VicidominiLab/BrightEyes-TTM/docs/source/IOConnectorBoard.md

# I/Os adapters & Pinout

```{toctree}
pinout5x5
pinout7x7
```

## Pinout synchronization

```{eval-rst}
.. list-table::
   :header-rows: 1

   * - SMA on Xilinx KC705 board (.xdc)
     - Input
   * - J11
     - Frame
   * - J12
     - Laser SYNC
   * - J14
     - Line
   * - J13
     - Pixel     
```
