VicidominiLab/BrightEyes-TTM/docs/source/NIM2TTL.md

# MPD NIM 2 TTL

MPD NIM 2 TTL

- *Brand:* Micro Photon Devices
- *Product code:* NIM2TTL
- *Link to the product:* <http://www.micro-photon-devices.com/Products/Instrumentation/NIM2TTL-Converter>

This is a commercial device which we use for converting the laser clock signal from NIM levels to TTL levels.
