VicidominiLab/BrightEyes-TTM/docs/source/img/FCS_curve.png

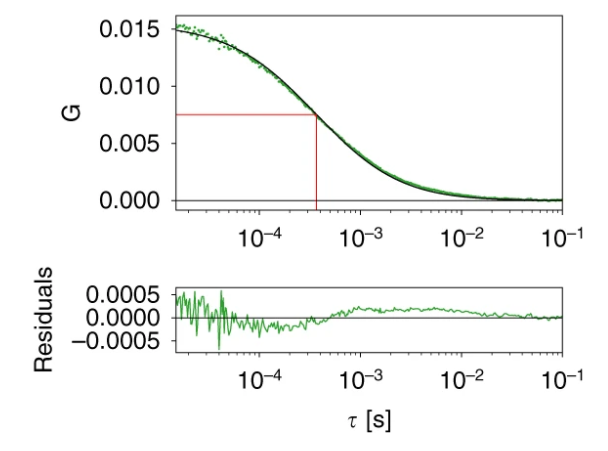
docs/source/img/FCS_curve.png
