VicidominiLab/BrightEyes-TTM/docs/source/img/FLIM_imaging.PNG

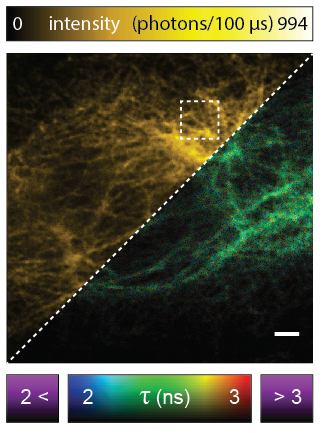
docs/source/img/FLIM_imaging.PNG
