VicidominiLab/BrightEyes-TTM/docs/source/img/Nutt_slidingscale.PNG

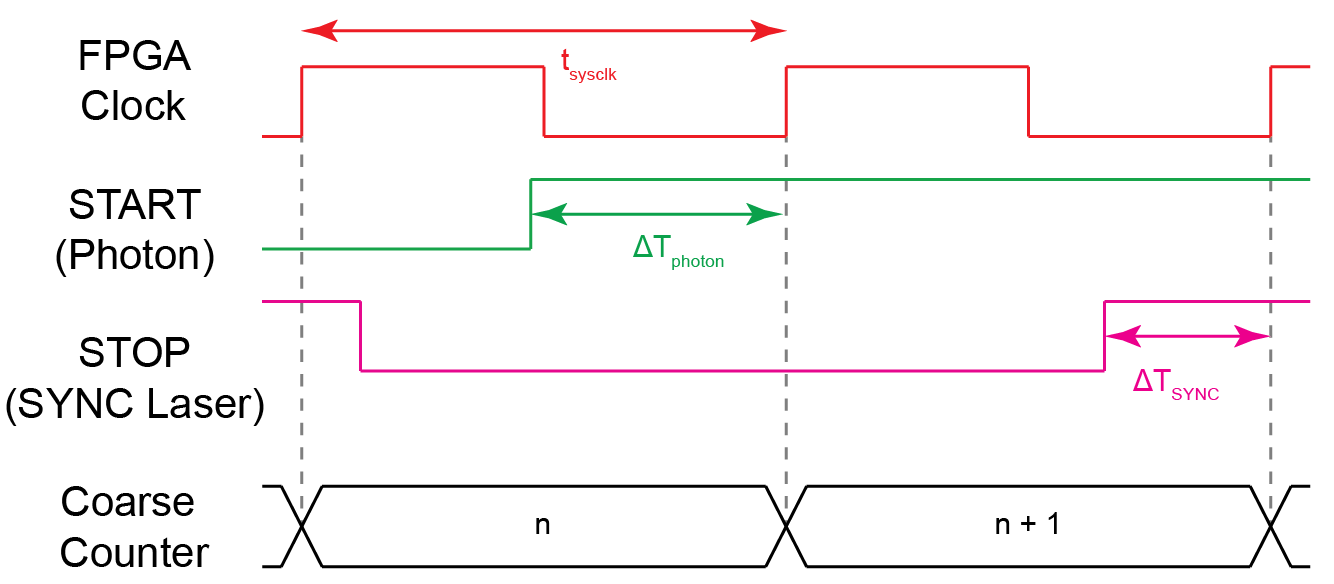
docs/source/img/Nutt_slidingscale.PNG
