VicidominiLab/BrightEyes-TTM/docs/source/img/TCSPC_histograms.png

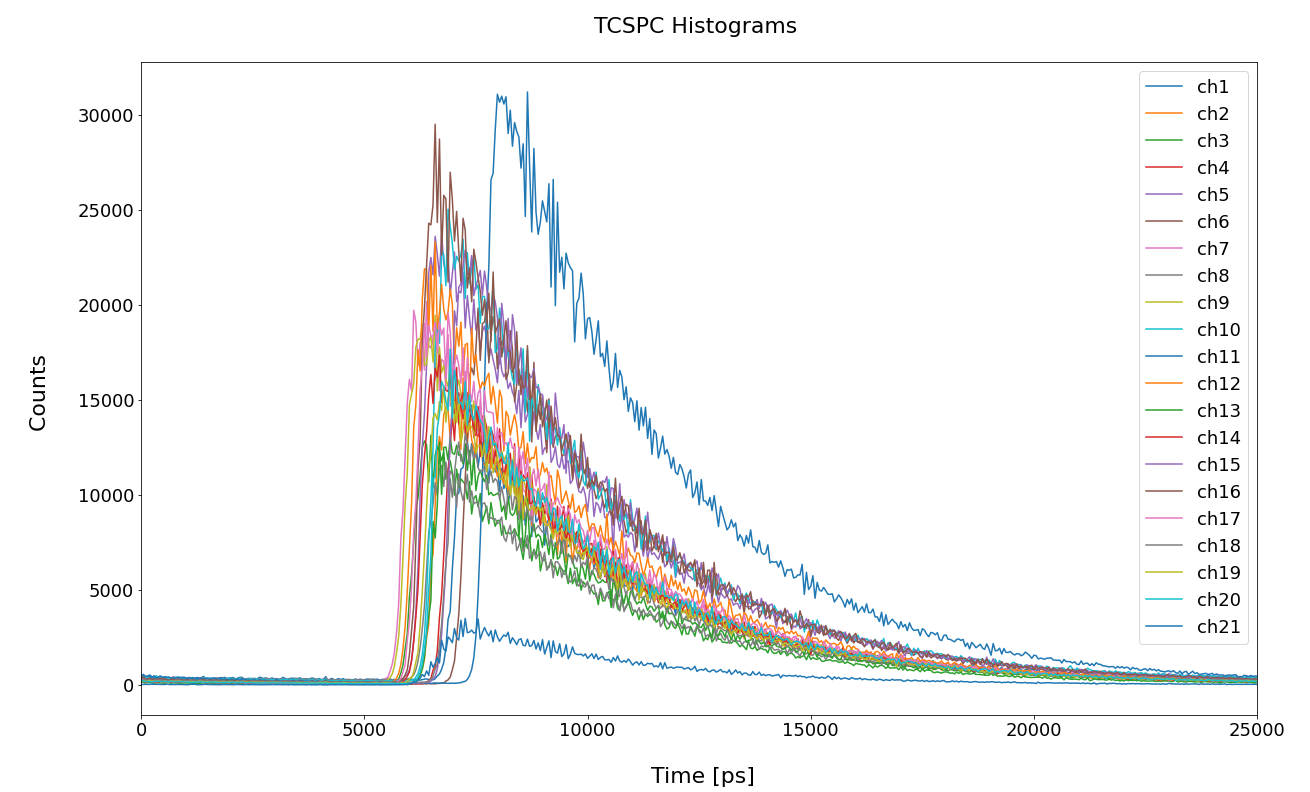
docs/source/img/TCSPC_histograms.png
