VicidominiLab/BrightEyes-TTM/docs/source/img/TTM_ch11_duplication.PNG

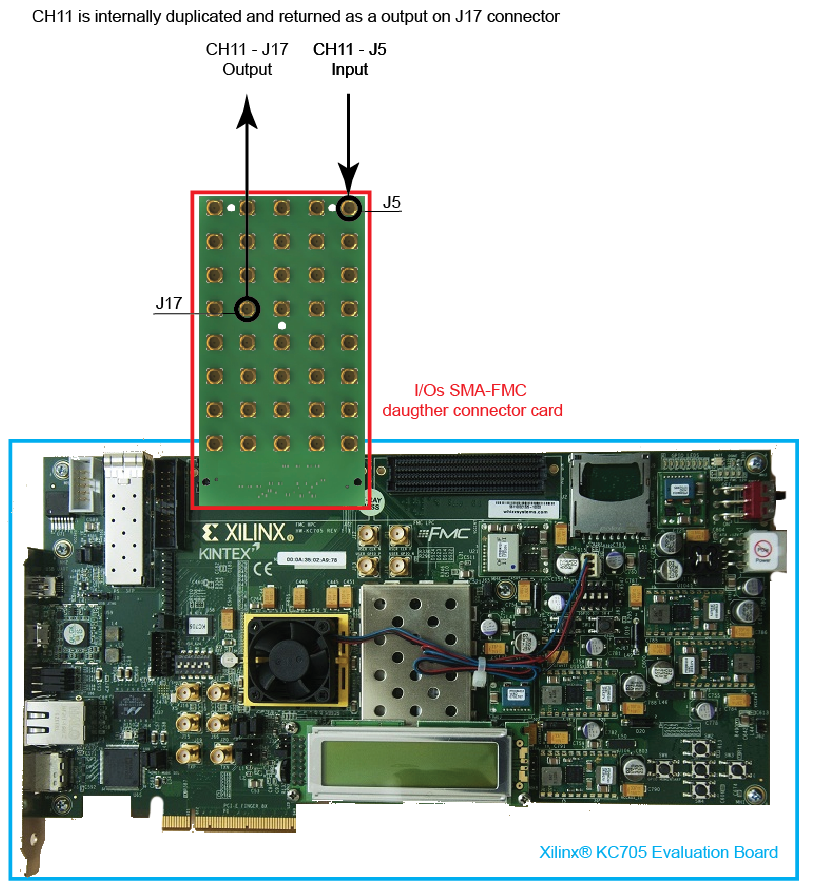
docs/source/img/TTM_ch11_duplication.PNG
