VicidominiLab/BrightEyes-TTM/boards/8xDigiBuffer/doc/BOM_DIGIBUFF8_rev2.xlsx

Revision: 0
Electronic Design Lab
Via E.Melen, 83
16152 - Genova
Bill Of Materials November 27,2020 10:58:11 | Page1
Item | Quantity | Reference | Value | IITCODE Description | Rev_2 | NonMontare
______________________________________________
1 | 1 | C1 | 10uF | 14727 Electrolithic Capacitor, 10uF, 16V, SMD, Diam.4mm
2 | 1 | C2 | 10uF | 11240 Multilayer Ceramic Capacitor, 10uF, 100V, 20%, X7S, SMD, 2220
3 | 1 | C3 | 100uF | 718 Tantalum Capacitor, 100uF, 16V, 10%, SMD, 7343, h. 4.1mm
4 | 1 | C4 | 2.2uF | 7059 Multilayer Ceramic Capacitor, 2.2uF, 16V, 10%, X5R, SMD, 0603
5 | 8 | C5,C7,C9,C11,C13,C15,C17,C19 | 0.1uF | 254 Multilayer Ceramic Capacitor, 0.1uF, 50V, 10%, X7R, SMD, 0603
6 | 8 | C6,C8,C10,C12,C14,C16,C18,C20 | 1uF | 12818 Multilayer Ceramic Capacitor, 1uF, 50V, 10%, X7R, SMD, 0603
7 | 1 | DL1 | OVS-0603 | 1655 Led diode, blue, 4V, 25mA, 100mcd, SMD, 0603
8 | 1 | DL2 | HSMH-C190 | 257 Led diode, red, 2.6V, 25mA, 10mcd, SMD, 0603
9 | 1 | FL1 | 220R@100MHz | 10708 Ferrite bead,1A, 220R@100MHz, SMD, 0603
10 | 1 | J1 | 47346-0001 | 5063 PCB connector, microUSB type B, 5 contact, socket, 90Â°, w to b, with flanges, SMD
11 | 16 | J2,J3,J4,J5,J6,J7,J8,J9,J10,J11,J12, J13,J14,J15,J16,J17 | 59S201-400L5 | 4509 PCB connector, SMB, male, 90Â°, w to b, lock, no key, THD
12 | 1 | R1 | 6K8 | 1424 Resistor Thick film, 6K8, 0.063W, 1%, SMD, 0603
13 | 1 | R2 | 4K12 | 15147 Resistor Thin film, 4K12, 0.063W, 0.1%, SMD, 0402
14 | 1 | R3 | 470R | 1578 Resistor Thick film, 470R, 0.063W, 1%, SMD, 0603
15 | 1 | R4 | 100R | 444 Resistor Thick film 100R, 0.1W, 1%, SMD, 0603
16 | 16 | R5,R6,R7,R8,R9,R10,R11,R12,R13, R14,R15,R16,R17,R18,R19,R20 | 100R | 444 Resistor Thick film 100R, 0.1W, 1%, SMD, 0603 |  | NM
17 | 1 | SW1 | OS102011MA1QN1 | 12064 Slide switch SPDT (ON/OFF), horizontal, 12V, 8.6x4.4mm, THD
18 | 1 | TP1 | TEST POINT 3mm | 5232 Test point, PCB, round, 3mm, for automatic test equipment |  | NM
19 | 1 | U1 | LT1764AMPQ | 14881 Voltage regulator, linear, fast transient response, low noise, Vin 2.7/20V, Vout ADJ 1.2/20V, 3A, SMD, DDPAK9X9-5
20 | 8 | U2,U3,U4,U5,U6,U7,U8,U9 | CDCLVC1102PWR | 15141 LVCMOS Clock Buffer, 1:2, 250MHz, 2.5/3.3V SMD, TSSOP8
