VicidominiLab/BrightEyes-TTM/docs/source/img/TTM_Assembly.PNG

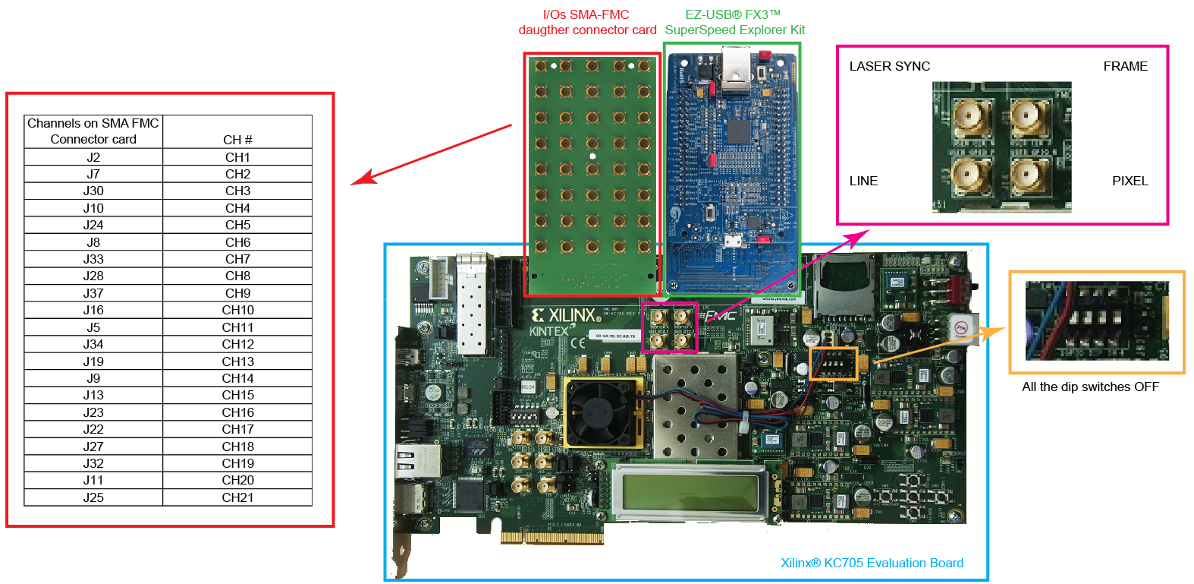
docs/source/img/TTM_Assembly.PNG
