VicidominiLab/BrightEyes-TTM/boards/IOconnectorBoard/SMA_FMC-schematic.pdf

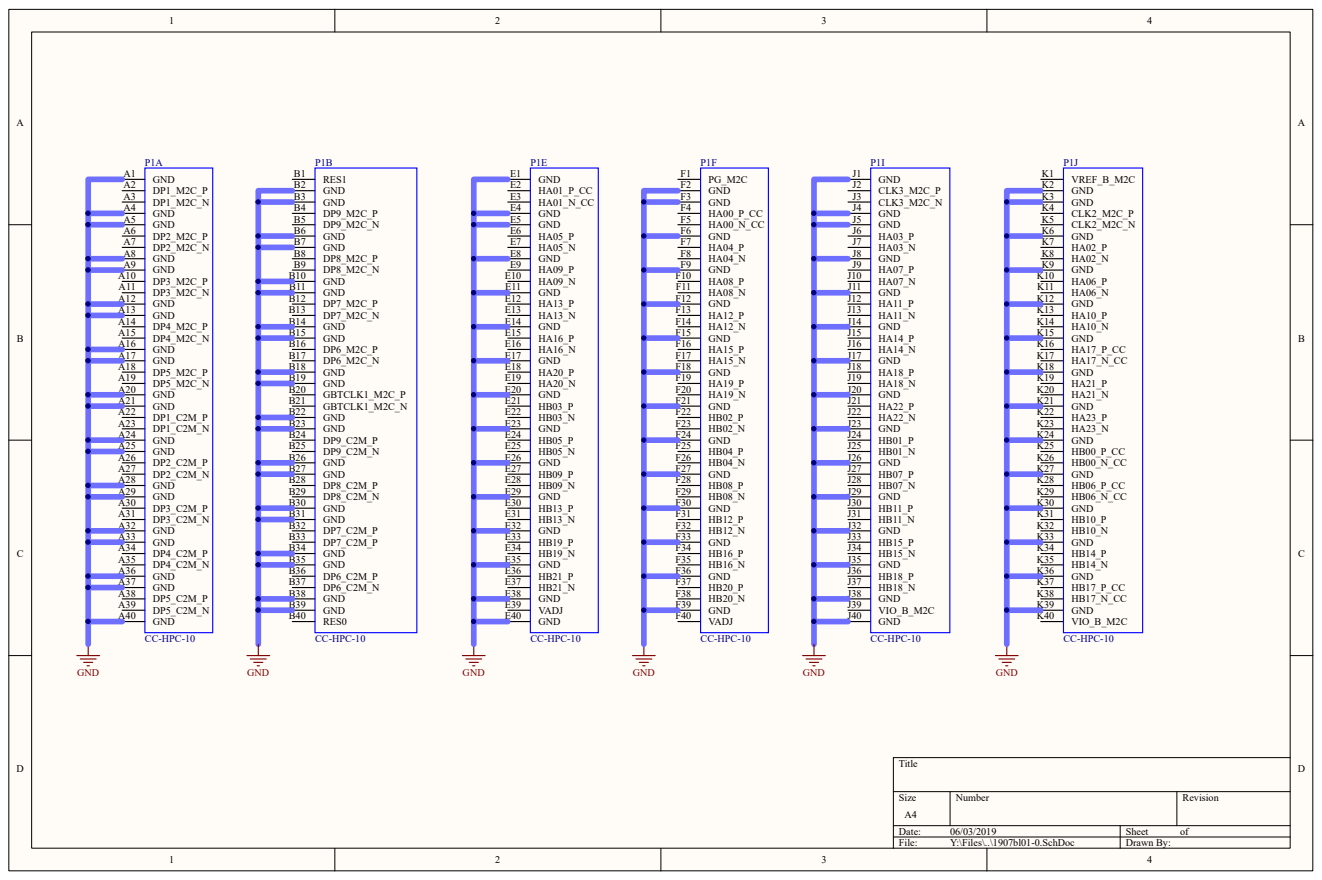
[picture p31: page 1]

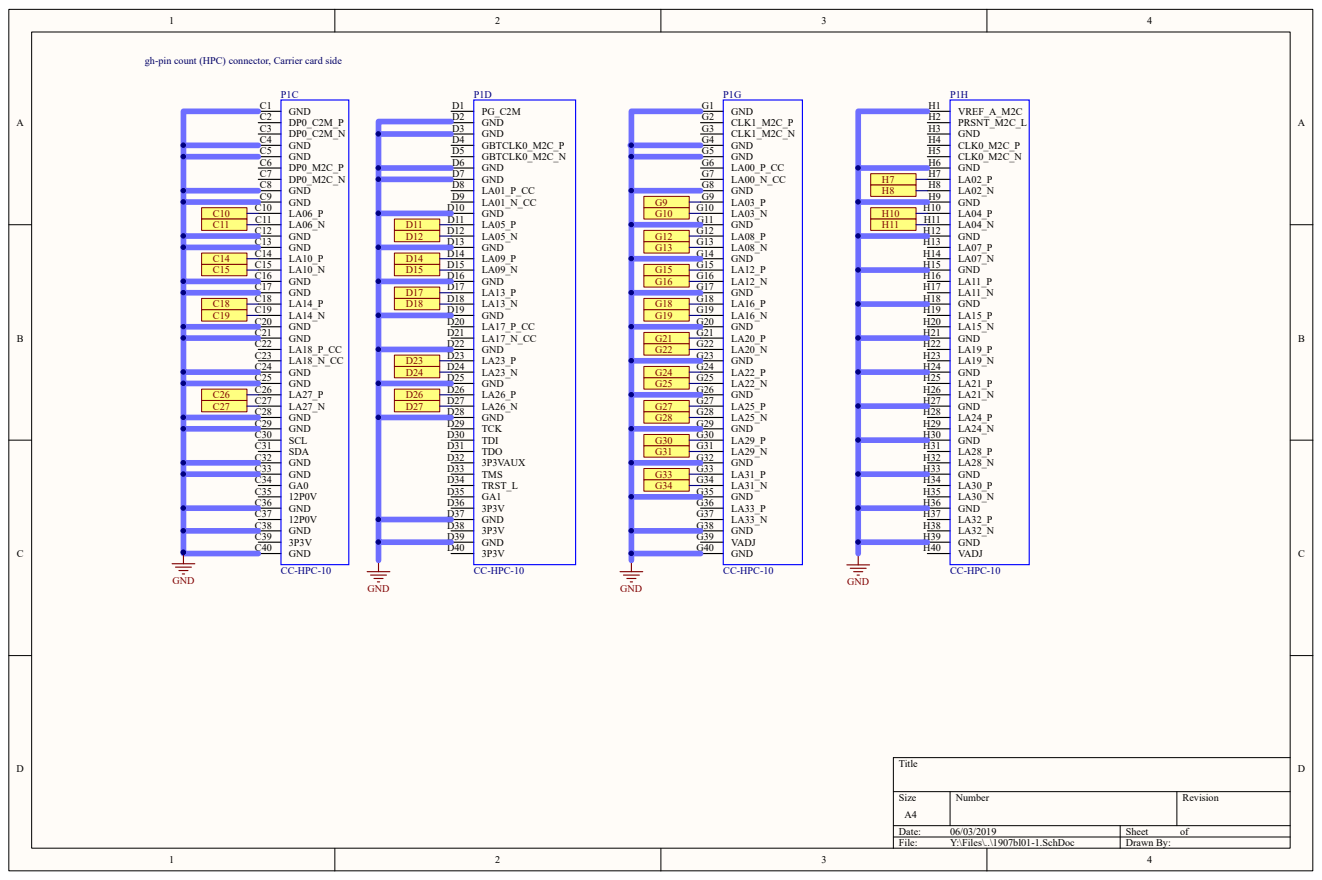
[picture p32: page 2]

gh-pin count (HPC) connector, Carrier card side

# GND 5

# GND 5

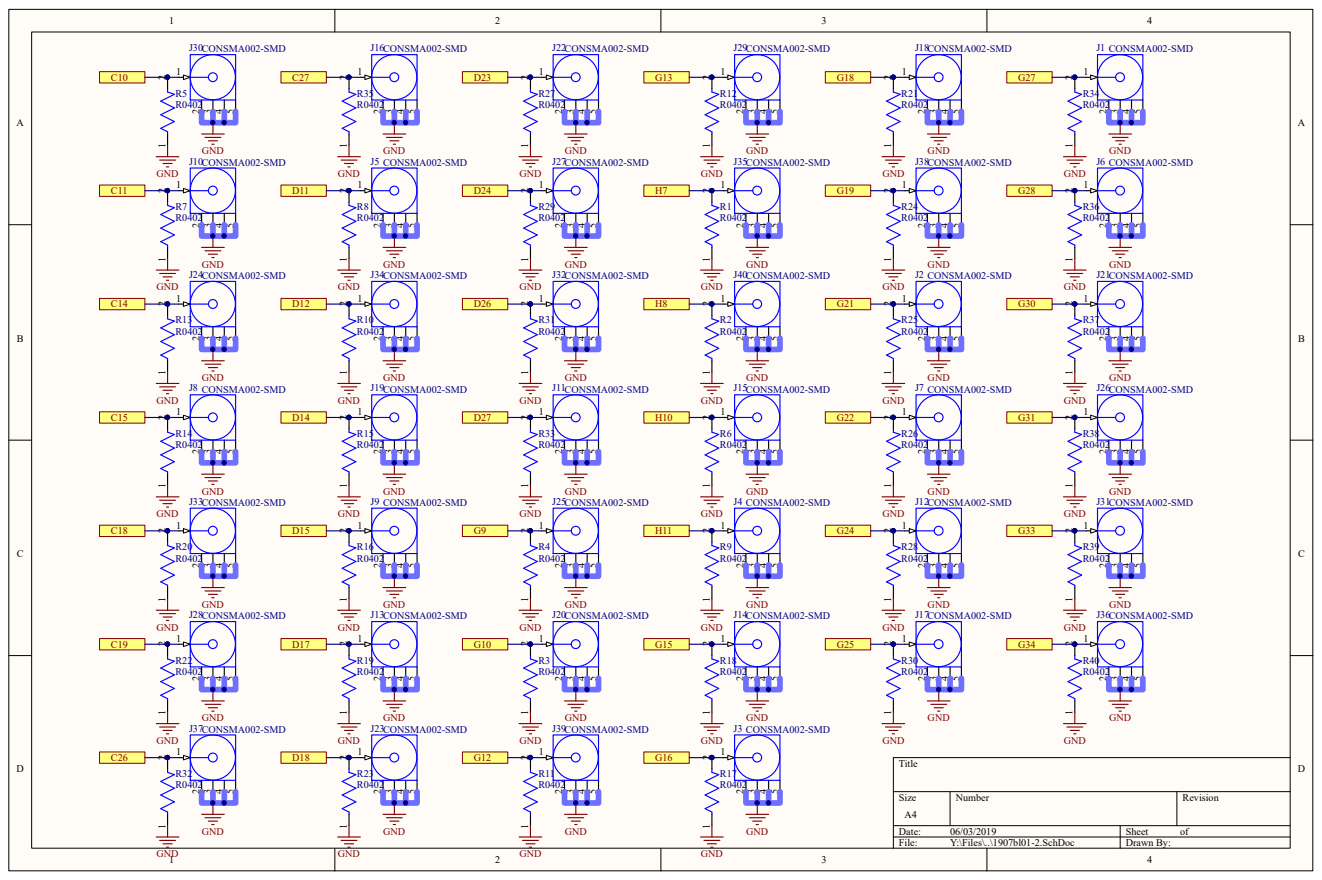
[picture p33: page 3]
