VicidominiLab/BrightEyes-TTM/boards/8xDigiBuffer/doc/DigiBuff8_rev2_pcb.pdf

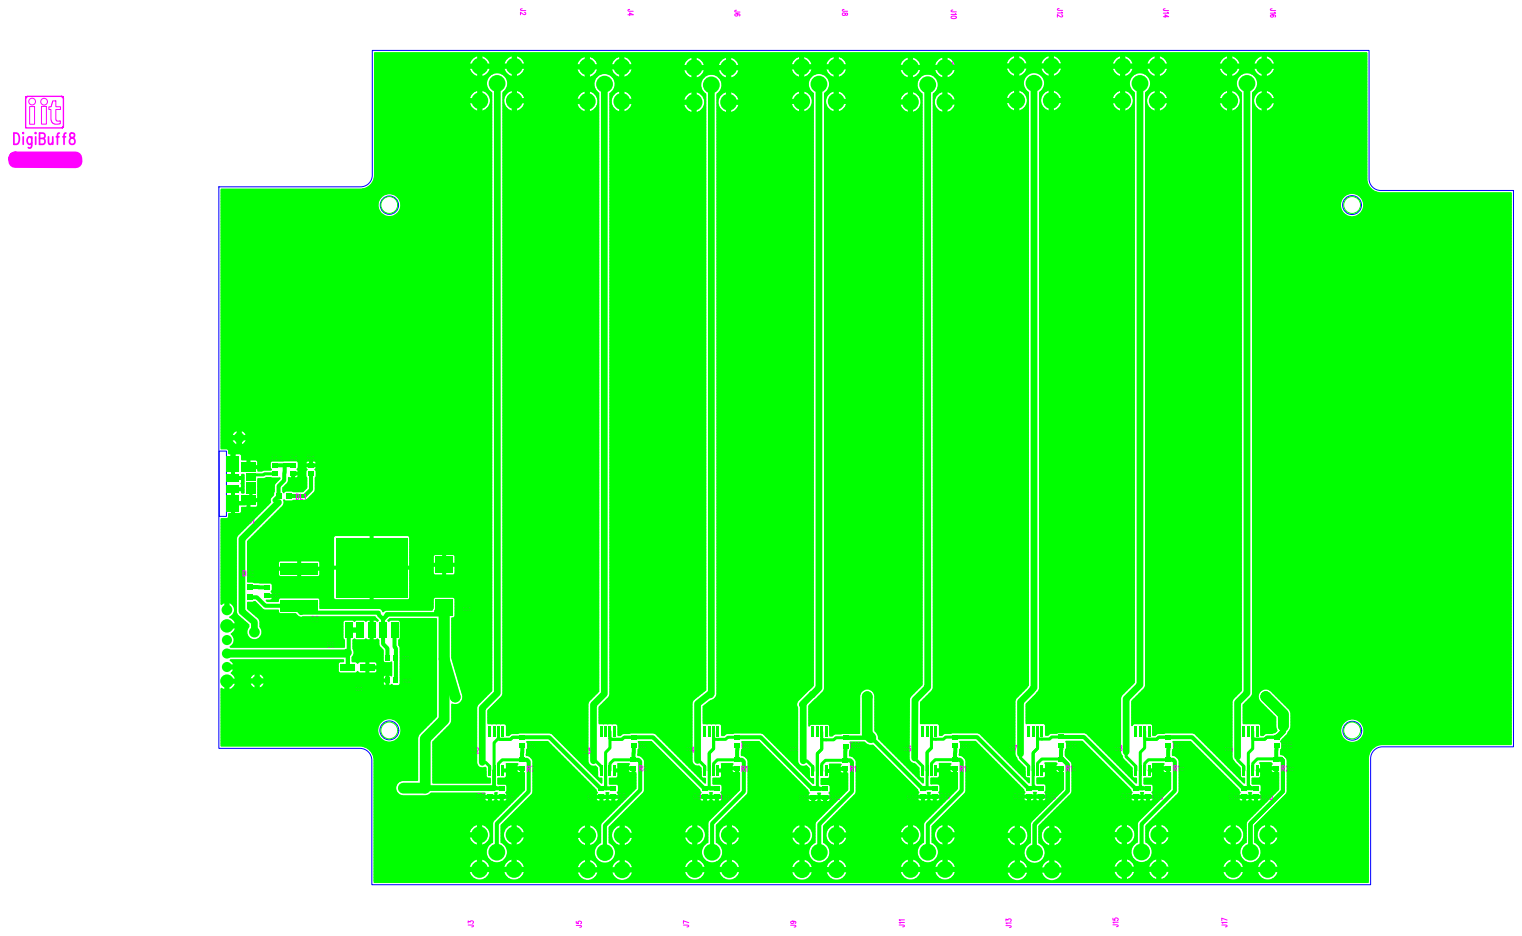
[picture p34: page 1]

J10J10x1J10x2 J10x3 | J10x4 J10x5
J11J11x1 J11x2 J11x4 | J11x3 J11x5
J12J12x1J12x2 J12x3 | J12x4 J12x5
J13J13x1 J13x2 J13x4 | J13x3 J13x5
J14J14x1J14x2 J14x3 | J14x4 J14x5
J15J15x1 J15x2 J15x4 | J15x3 J15x5
J16J16x1J16x2 J16x3 | J16x4 J16x5
J17J17x1 J17x2 J17x4 | J17x3 J17x5
J2J2x1J2x2 J2x3 | J2x4 J2x5
J3J3x1 J3x2 J3x4 | J3x3 J3x5
J4J4x1J4x2 J4x3 | J4x4 J4x5
J5J5x1 J5x2 J5x4 | J5x3 J5x5
J6J6x1J6x2 J6x3 | J6x4 J6x5
J7J7x1 J7x2 J7x4 | J7x3 J7x5
J8J8x1J8x2 J8x3 | J8x4 J8x5
J9J9x1 J9x2 J9x4 | J9x3 J9x5

SW1SW¹x1 SW¹x2 SW¹x3 SW¹x4 SW¹x5

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

SW1SW¹x1 SW¹x2 SW¹x3 SW¹x4 SW¹x5

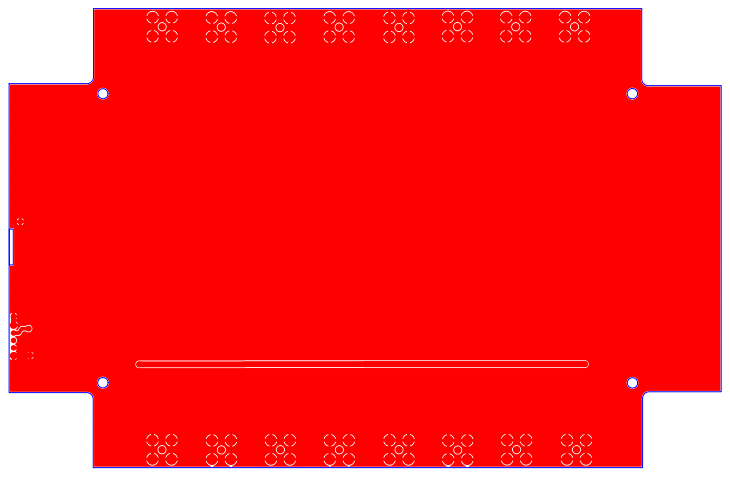
[picture p35: page 4]
SW1SW¹x1 SW¹x2 SW¹x3 SW¹x4 SW¹x5

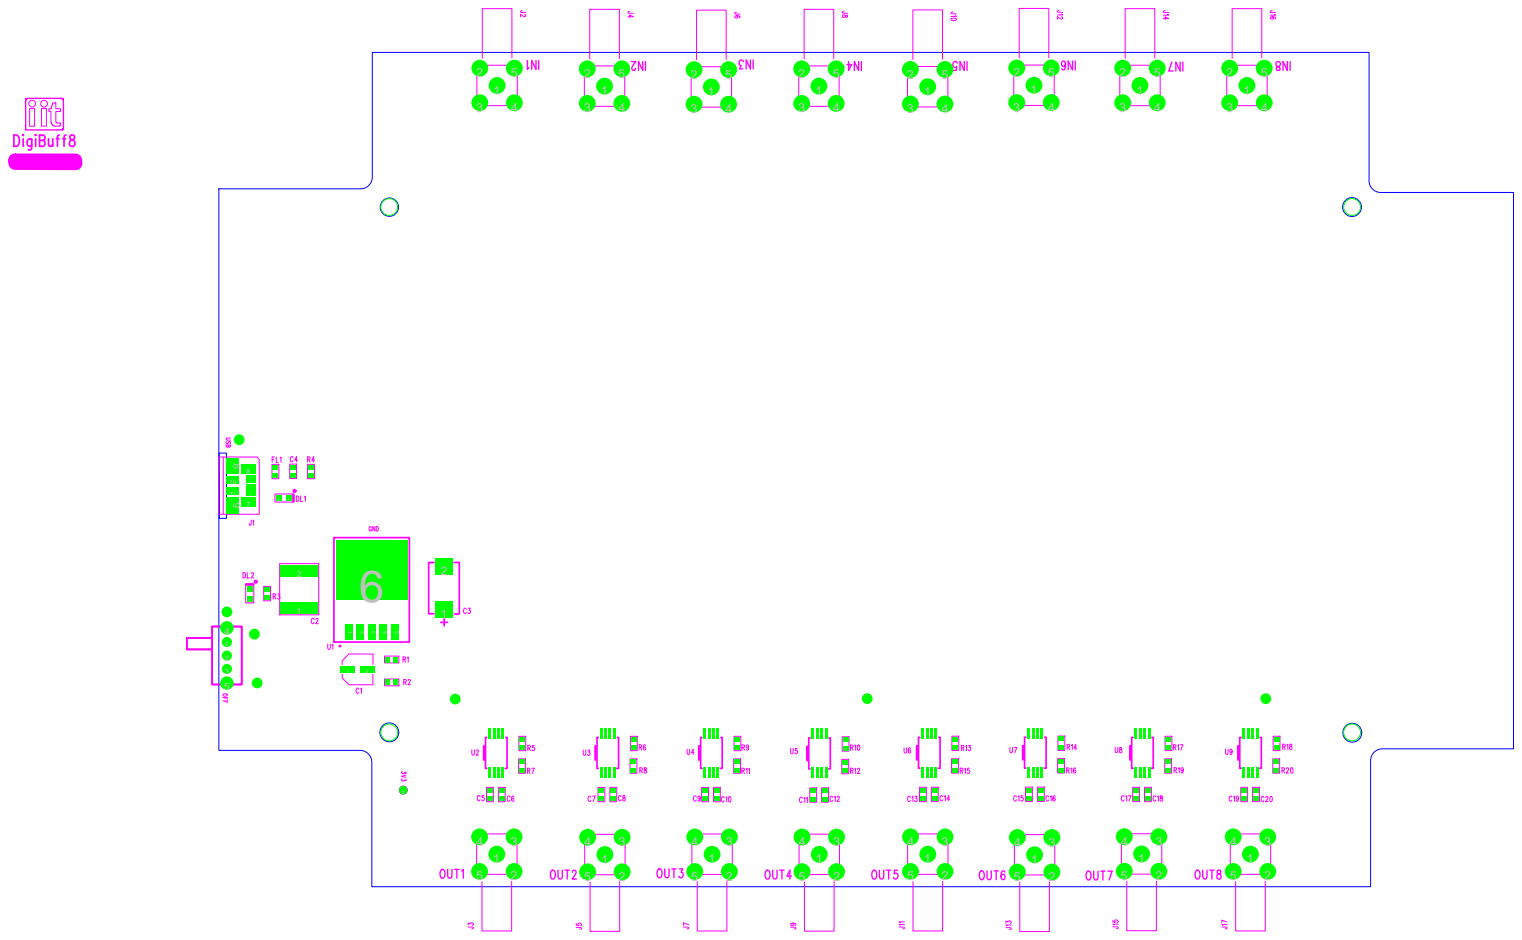
[picture p36: page 5]

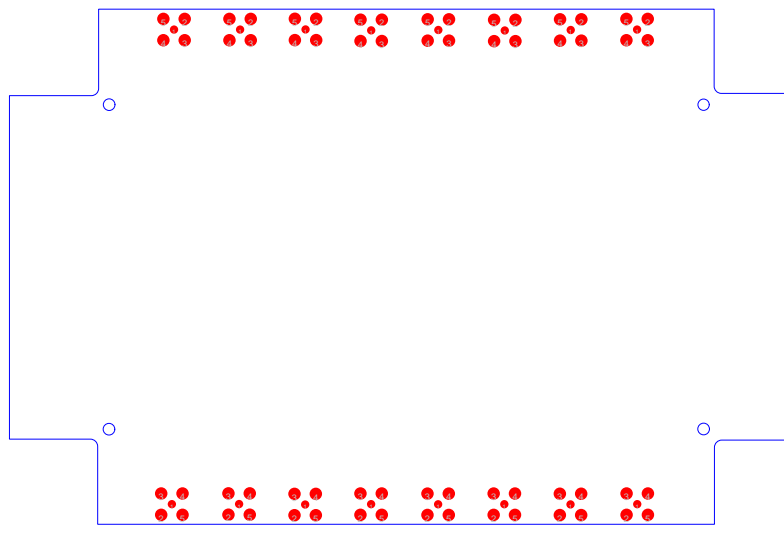
[picture p37: page 6]

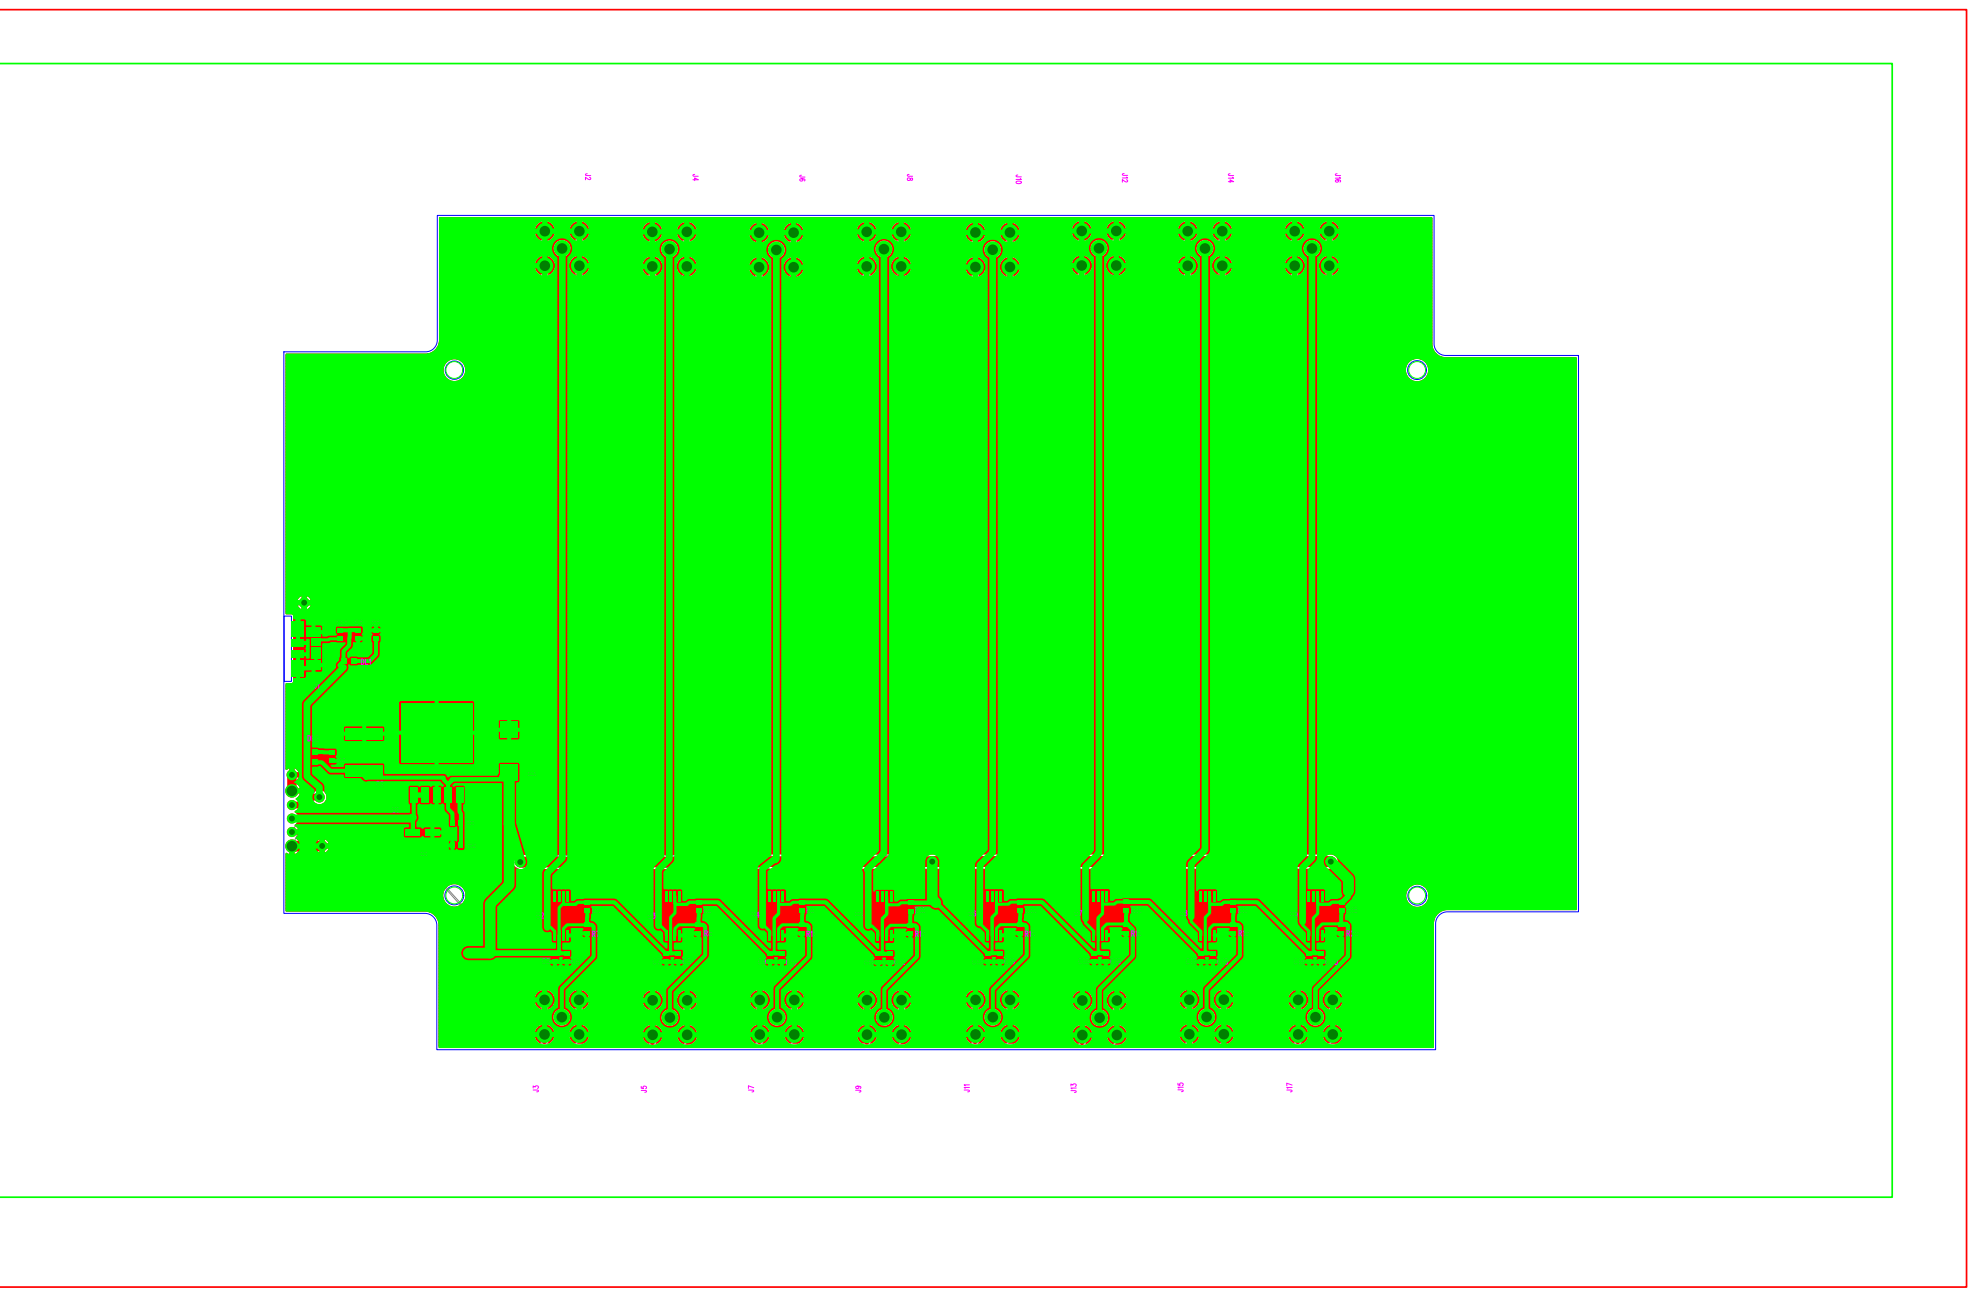
[picture p38: page 7]
