VicidominiLab/BrightEyes-TTM/boards/8xDigiBuffer/doc/DigiBuff8_rev2_sch.pdf

# uUSB

3,3V

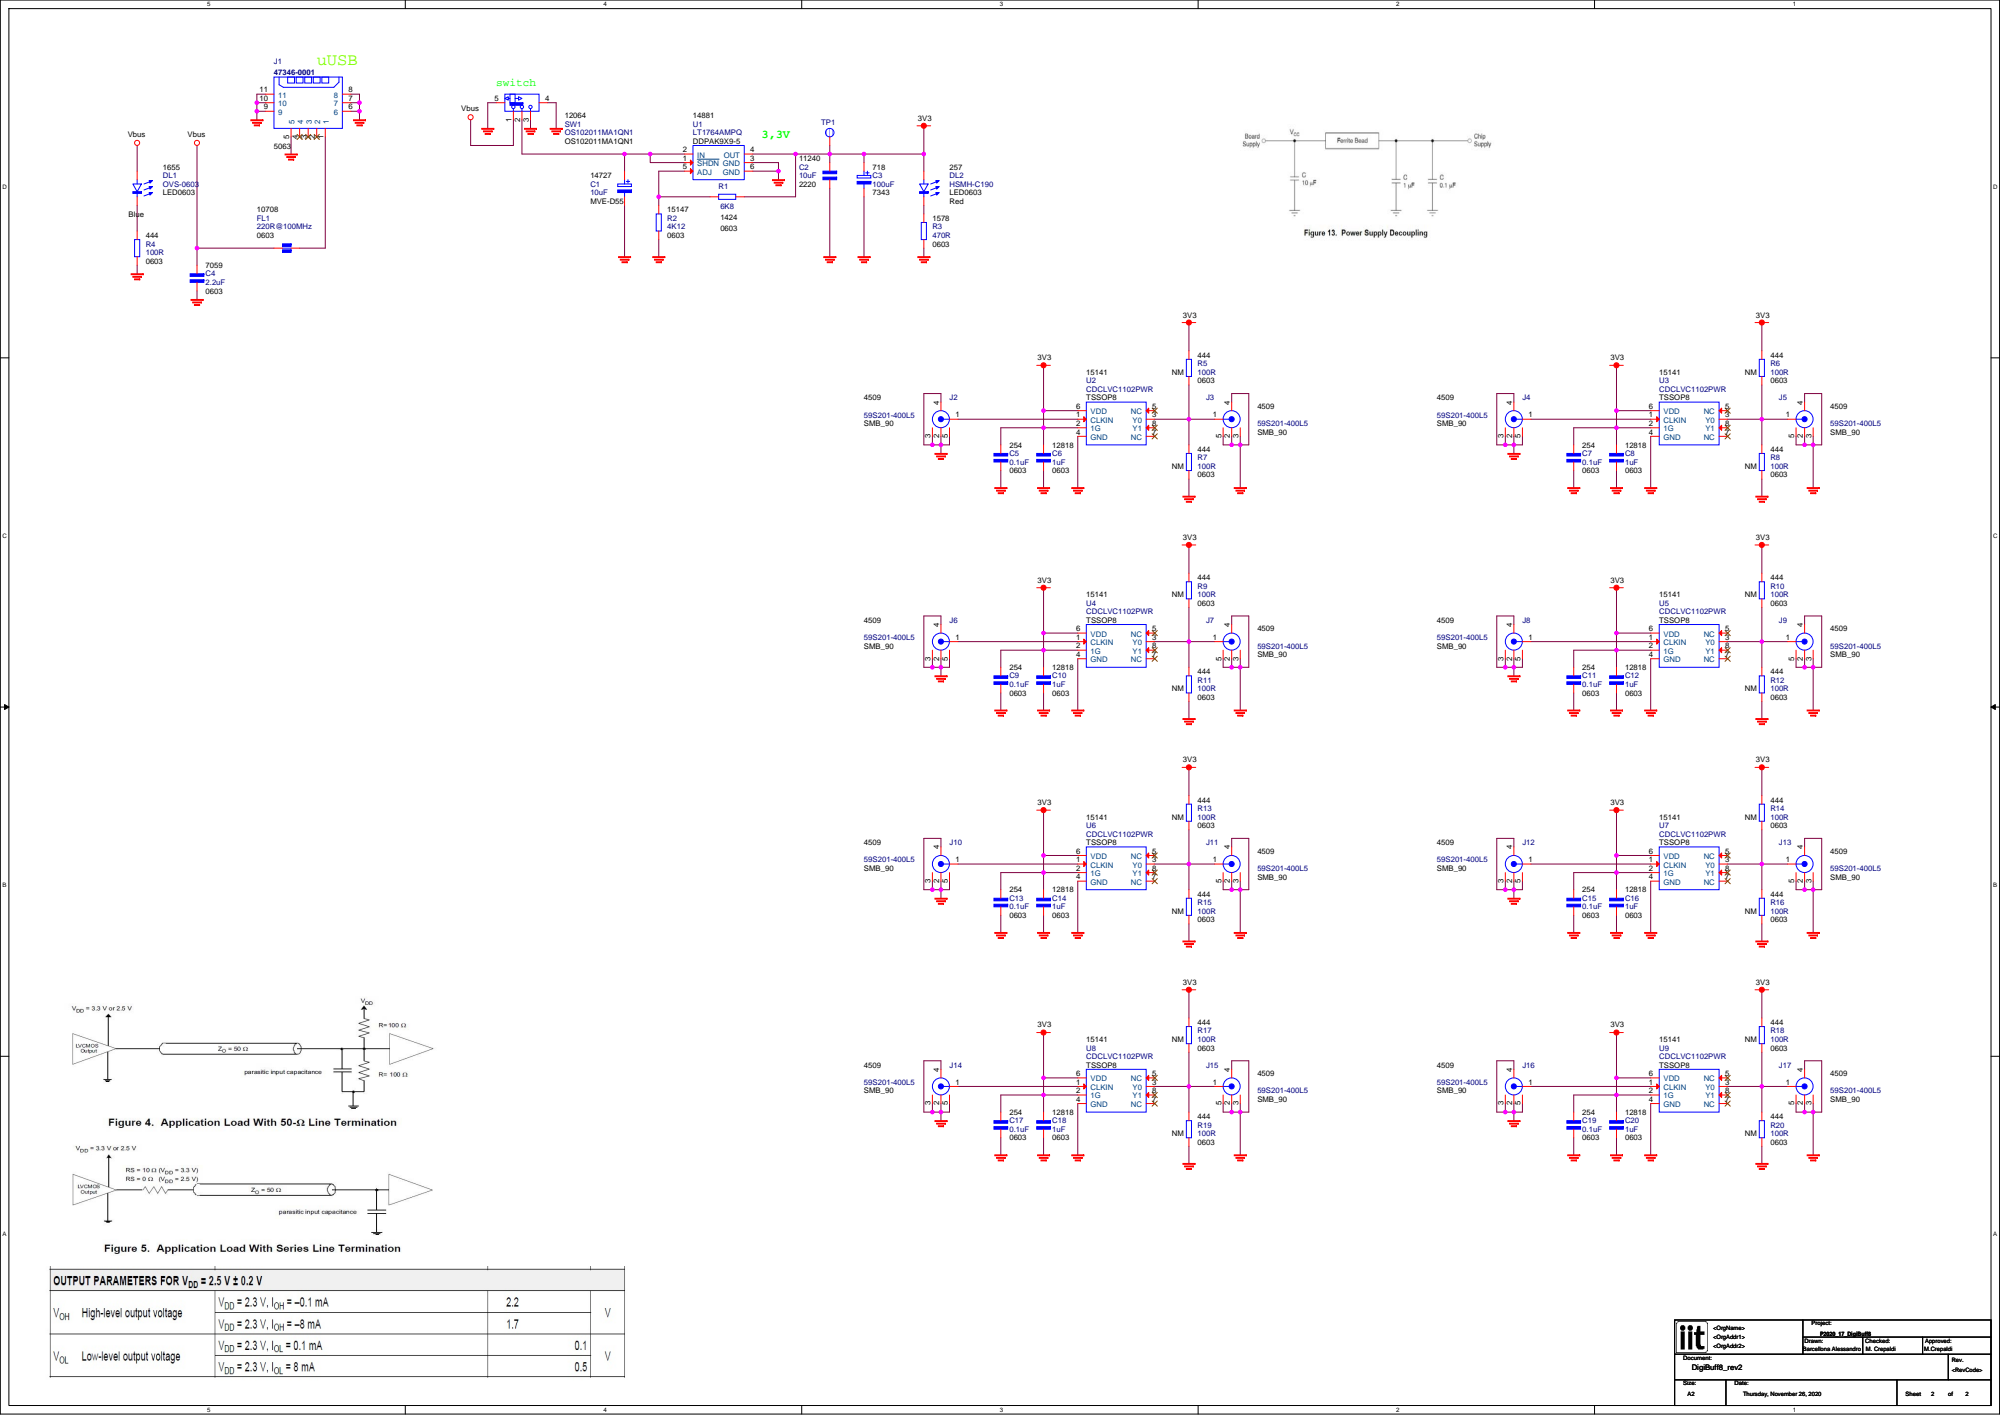
[picture p39: page 1]

<OrgAddr2> <OrgAddr2> <OrgAddr2> | Project: Project: Project: P2020_17_DigiBuff8 <OrgName> <OrgAddr1> P2020_17_DigiBuff8 <OrgName> <OrgAddr1> P2020_17_DigiBuff8 <OrgName> <OrgAddr1>

Drawn: Drawn: Drawn: Barcellona Alessandro Barcellona Alessandro Barcellona Alessandro | Checked: Checked: Checked: M. Crepaldi M. Crepaldi M. Crepaldi | Approved: Approved: Approved: M.Crepaldi M.Crepaldi M.Crepaldi

Document: Document: Document: DigiBuff8_rev2 DigiBuff8_rev2 DigiBuff8_rev2 | Rev. Rev. Rev. <RevCode> <RevCode> <RevCode>

Size: Size: Size: A2 A2 A2 | Date: Date: Date: Thursday, November 26, 2020 Thursday, November 26, 2020 Thursday, November 26, 2020 | Sheet Sheet Sheet 2 2 2 of of of 2 2 2
