VicidominiLab/BrightEyes-TTM/FPGA/ttm/hdl/ip/clockMainGen/clockMainGen_clk_wiz.v

// file: clockMainGen.v
// 
// (c) Copyright 2008 - 2013 Xilinx, Inc. All rights reserved.
// 
// This file contains confidential and proprietary information
// of Xilinx, Inc. and is protected under U.S. and
// international copyright and other intellectual property
// laws.
// 
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
// CRITICAL APPLICATIONS
// Xilinx products are not designed or intended to be fail-
// safe, or for use in any application requiring fail-safe
// performance, such as life-support or safety devices or
// systems, Class III medical devices, nuclear facilities,
// applications related to the deployment of airbags, or any
// other applications that could lead to death, personal
// injury, or severe property or environmental damage
// (individually and collectively, "Critical
// Applications"). Customer assumes the sole risk and
// liability of any use of Xilinx products in Critical
// Applications, subject only to applicable laws and
// regulations governing limitations on product liability.
// 
// THIS COPYRIGHT NOTICE AND DISCLAIMER MUST BE RETAINED AS
// PART OF THIS FILE AT ALL TIMES.
// 
//----------------------------------------------------------------------------
// User entered comments
//----------------------------------------------------------------------------
// None
//
//----------------------------------------------------------------------------
//  Output     Output      Phase    Duty Cycle   Pk-to-Pk     Phase
//   Clock     Freq (MHz)  (degrees)    (%)     Jitter (ps)  Error (ps)
//----------------------------------------------------------------------------
// _clk_240___240.000______0.000______50.0_______89.608_____82.655
// _clk_400___400.000______0.000______50.0_______81.254_____82.655
// __clk_50____50.000______0.000______50.0______121.478_____82.655
// _clk_100___100.000______0.000______50.0______106.024_____82.655
//
//----------------------------------------------------------------------------
// Input Clock   Freq (MHz)    Input Jitter (UI)
//----------------------------------------------------------------------------
// __primary_________200.000____________0.010

`timescale 1ps/1ps

module clockMainGen_clk_wiz 

 (// Clock in ports
  // Clock out ports
  output        clk_240,
  output        clk_400,
  output        clk_50,
  output        clk_100,
  // Status and control signals
  input         reset,
  output        locked,
  input         clk_in1_p,
  input         clk_in1_n
 );
  // Input buffering
  //------------------------------------
wire clk_in1_clockMainGen;
wire clk_in2_clockMainGen;
  IBUFDS clkin1_ibufgds
   (.O  (clk_in1_clockMainGen),
    .I  (clk_in1_p),
    .IB (clk_in1_n));




  // Clocking PRIMITIVE
  //------------------------------------

  // Instantiation of the MMCM PRIMITIVE
  //    * Unused inputs are tied off
  //    * Unused outputs are labeled unused

  wire        clk_240_clockMainGen;
  wire        clk_400_clockMainGen;
  wire        clk_50_clockMainGen;
  wire        clk_100_clockMainGen;
  wire        clk_out5_clockMainGen;
  wire        clk_out6_clockMainGen;
  wire        clk_out7_clockMainGen;

  wire [15:0] do_unused;
  wire        drdy_unused;
  wire        psdone_unused;
  wire        locked_int;
  wire        clkfbout_clockMainGen;
  wire        clkfbout_buf_clockMainGen;
  wire        clkfboutb_unused;
    wire clkout0b_unused;
   wire clkout1b_unused;
   wire clkout2b_unused;
   wire clkout3b_unused;
   wire clkout4_unused;
  wire        clkout5_unused;
  wire        clkout6_unused;
  wire        clkfbstopped_unused;
  wire        clkinstopped_unused;
  wire        reset_high;
  (* KEEP = "TRUE" *) 
  (* ASYNC_REG = "TRUE" *)
  reg  [7 :0] seq_reg1 = 0;
  (* KEEP = "TRUE" *) 
  (* ASYNC_REG = "TRUE" *)
  reg  [7 :0] seq_reg2 = 0;
  (* KEEP = "TRUE" *) 
  (* ASYNC_REG = "TRUE" *)
  reg  [7 :0] seq_reg3 = 0;
  (* KEEP = "TRUE" *) 
  (* ASYNC_REG = "TRUE" *)
  reg  [7 :0] seq_reg4 = 0;

  MMCME2_ADV
  #(.BANDWIDTH            ("HIGH"),
    .CLKOUT4_CASCADE      ("FALSE"),
    .COMPENSATION         ("ZHOLD"),
    .STARTUP_WAIT         ("FALSE"),
    .DIVCLK_DIVIDE        (1),
    .CLKFBOUT_MULT_F      (6.000),
    .CLKFBOUT_PHASE       (0.000),
    .CLKFBOUT_USE_FINE_PS ("FALSE"),
    .CLKOUT0_DIVIDE_F     (5.000),
    .CLKOUT0_PHASE        (0.000),
    .CLKOUT0_DUTY_CYCLE   (0.500),
    .CLKOUT0_USE_FINE_PS  ("FALSE"),
    .CLKOUT1_DIVIDE       (3),
    .CLKOUT1_PHASE        (0.000),
    .CLKOUT1_DUTY_CYCLE   (0.500),
    .CLKOUT1_USE_FINE_PS  ("FALSE"),
    .CLKOUT2_DIVIDE       (24),
    .CLKOUT2_PHASE        (0.000),
    .CLKOUT2_DUTY_CYCLE   (0.500),
    .CLKOUT2_USE_FINE_PS  ("FALSE"),
    .CLKOUT3_DIVIDE       (12),
    .CLKOUT3_PHASE        (0.000),
    .CLKOUT3_DUTY_CYCLE   (0.500),
    .CLKOUT3_USE_FINE_PS  ("FALSE"),
    .CLKIN1_PERIOD        (5.000))
  mmcm_adv_inst
    // Output clocks
   (
    .CLKFBOUT            (clkfbout_clockMainGen),
    .CLKFBOUTB           (clkfboutb_unused),
    .CLKOUT0             (clk_240_clockMainGen),
    .CLKOUT0B            (clkout0b_unused),
    .CLKOUT1             (clk_400_clockMainGen),
    .CLKOUT1B            (clkout1b_unused),
    .CLKOUT2             (clk_50_clockMainGen),
    .CLKOUT2B            (clkout2b_unused),
    .CLKOUT3             (clk_100_clockMainGen),
    .CLKOUT3B            (clkout3b_unused),
    .CLKOUT4             (clkout4_unused),
    .CLKOUT5             (clkout5_unused),
    .CLKOUT6             (clkout6_unused),
     // Input clock control
    .CLKFBIN             (clkfbout_buf_clockMainGen),
    .CLKIN1              (clk_in1_clockMainGen),
    .CLKIN2              (1'b0),
     // Tied to always select the primary input clock
    .CLKINSEL            (1'b1),
    // Ports for dynamic reconfiguration
    .DADDR               (7'h0),
    .DCLK                (1'b0),
    .DEN                 (1'b0),
    .DI                  (16'h0),
    .DO                  (do_unused),
    .DRDY                (drdy_unused),
    .DWE                 (1'b0),
    // Ports for dynamic phase shift
    .PSCLK               (1'b0),
    .PSEN                (1'b0),
    .PSINCDEC            (1'b0),
    .PSDONE              (psdone_unused),
    // Other control and status signals
    .LOCKED              (locked_int),
    .CLKINSTOPPED        (clkinstopped_unused),
    .CLKFBSTOPPED        (clkfbstopped_unused),
    .PWRDWN              (1'b0),
    .RST                 (reset_high));
  assign reset_high = reset; 

  assign locked = locked_int;
// Clock Monitor clock assigning
//--------------------------------------
 // Output buffering
  //-----------------------------------

  BUFG clkf_buf
   (.O (clkfbout_buf_clockMainGen),
    .I (clkfbout_clockMainGen));







  BUFGCE clkout1_buf
   (.O   (clk_240),
    .CE  (seq_reg1[7]),
    .I   (clk_240_clockMainGen));

  BUFH clkout1_buf_en
   (.O   (clk_240_clockMainGen_en_clk),
    .I   (clk_240_clockMainGen));
  always @(posedge clk_240_clockMainGen_en_clk or posedge reset_high) begin
    if(reset_high == 1'b1) begin
	    seq_reg1 <= 8'h00;
    end
    else begin
        seq_reg1 <= {seq_reg1[6:0],locked_int};
  
    end
  end


  BUFGCE clkout2_buf
   (.O   (clk_400),
    .CE  (seq_reg2[7]),
    .I   (clk_400_clockMainGen));
 
  BUFH clkout2_buf_en
   (.O   (clk_400_clockMainGen_en_clk),
    .I   (clk_400_clockMainGen));
 
  always @(posedge clk_400_clockMainGen_en_clk or posedge reset_high) begin
    if(reset_high == 1'b1) begin
	  seq_reg2 <= 8'h00;
    end
    else begin
        seq_reg2 <= {seq_reg2[6:0],locked_int};
  
    end
  end


  BUFGCE clkout3_buf
   (.O   (clk_50),
    .CE  (seq_reg3[7]),
    .I   (clk_50_clockMainGen));
 
  BUFH clkout3_buf_en
   (.O   (clk_50_clockMainGen_en_clk),
    .I   (clk_50_clockMainGen));
 
  always @(posedge clk_50_clockMainGen_en_clk or posedge reset_high) begin
    if(reset_high == 1'b1) begin
	  seq_reg3 <= 8'h00;
    end
    else begin
        seq_reg3 <= {seq_reg3[6:0],locked_int};
  
    end
  end


  BUFGCE clkout4_buf
   (.O   (clk_100),
    .CE  (seq_reg4[7]),
    .I   (clk_100_clockMainGen));

  BUFH clkout4_buf_en
   (.O   (clk_100_clockMainGen_en_clk),
    .I   (clk_100_clockMainGen));
	
  always @(posedge clk_100_clockMainGen_en_clk or posedge reset_high) begin
    if(reset_high == 1'b1) begin
	  seq_reg4 <= 8'h00;
    end
    else begin
        seq_reg4 <= {seq_reg4[6:0],locked_int};
  
    end
  end





endmodule
