VicidominiLab/BrightEyes-TTM/FPGA/ttm/project/ttm.srcs/sources_1/ip/ila_1/synth/ila_1.vhd

-- (c) Copyright 1995-2012 Xilinx, Inc. All rights reserved.
--
-- This file contains confidential and proprietary information
-- of Xilinx, Inc. and is protected under U.S. and
-- international copyright and other intellectual property
-- laws.
--
-- DISCLAIMER
-- This disclaimer is not a license and does not grant any
-- rights to the materials distributed herewith. Except as
-- otherwise provided in a valid license issued to you by
-- Xilinx, and to the maximum extent permitted by applicable
-- law: (1) THESE MATERIALS ARE MADE AVAILABLE "AS IS" AND
-- WITH ALL FAULTS, AND XILINX HEREBY DISCLAIMS ALL WARRANTIES
-- AND CONDITIONS, EXPRESS, IMPLIED, OR STATUTORY, INCLUDING
-- BUT NOT LIMITED TO WARRANTIES OF MERCHANTABILITY, NON-
-- INFRINGEMENT, OR FITNESS FOR ANY PARTICULAR PURPOSE; and
-- (2) Xilinx shall not be liable (whether in contract or tort,
-- including negligence, or under any other theory of
-- liability) for any loss or damage of any kind or nature
-- related to, arising under or in connection with these
-- materials, including for any direct, or any indirect,
-- special, incidental, or consequential loss or damage
-- (including loss of data, profits, goodwill, or any type of
-- loss or damage suffered as a result of any action brought
-- by a third party) even if such damage or loss was
-- reasonably foreseeable or Xilinx had been advised of the
-- possibility of the same.
--
-- CRITICAL APPLICATIONS
-- Xilinx products are not designed or intended to be fail-
-- safe, or for use in any application requiring fail-safe
-- performance, such as life-support or safety devices or
-- systems, Class III medical devices, nuclear facilities,
-- applications related to the deployment of airbags, or any
-- other applications that could lead to death, personal
-- injury, or severe property or environmental damage
-- (individually and collectively, "Critical
-- Applications"). Customer assumes the sole risk and
-- liability of any use of Xilinx products in Critical
-- Applications, subject only to applicable laws and
-- regulations governing limitations on product liability.
--
-- THIS COPYRIGHT NOTICE AND DISCLAIMER MUST BE RETAINED AS
-- PART OF THIS FILE AT ALL TIMES.
--
-- DO NOT MODIFY THIS FILE.

LIBRARY ieee;
USE ieee.std_logic_1164.ALL;
USE ieee.numeric_std.ALL;

ENTITY ila_1 IS
PORT (
clk : IN STD_LOGIC;


probe0 : IN STD_LOGIC_VECTOR(8 DOWNTO 0);
    probe1 : IN STD_LOGIC_VECTOR(0 DOWNTO 0);
    probe2 : IN STD_LOGIC_VECTOR(0 DOWNTO 0);
    probe3 : IN STD_LOGIC_VECTOR(0 DOWNTO 0);
    probe4 : IN STD_LOGIC_VECTOR(0 DOWNTO 0)
);
END ila_1;

ARCHITECTURE ila_1_arch OF ila_1 IS
COMPONENT ila_v6_2_5_ila IS
GENERIC (
C_XLNX_HW_PROBE_INFO : STRING;
C_XDEVICEFAMILY : STRING;
C_CORE_TYPE : INTEGER;
C_CORE_INFO1 : INTEGER;
C_CORE_INFO2 : INTEGER;
C_CAPTURE_TYPE : INTEGER;
C_MU_TYPE : INTEGER;
C_TC_TYPE : INTEGER;
C_NUM_OF_PROBES : INTEGER;
C_DATA_DEPTH : INTEGER;
C_MAJOR_VERSION : INTEGER;
C_MINOR_VERSION : INTEGER;
C_BUILD_REVISION : INTEGER;
C_CORE_MAJOR_VER : INTEGER;
C_CORE_MINOR_VER : INTEGER;
C_XSDB_SLAVE_TYPE : INTEGER;
C_NEXT_SLAVE : INTEGER;
C_CSE_DRV_VER : INTEGER;
C_USE_TEST_REG : INTEGER;
C_PIPE_IFACE : INTEGER;
C_RAM_STYLE : STRING;
C_TRIGOUT_EN : INTEGER;
C_TRIGIN_EN : INTEGER;
C_ADV_TRIGGER : INTEGER;
C_EN_DDR_ILA : INTEGER;
C_EN_STRG_QUAL : INTEGER;
C_INPUT_PIPE_STAGES : INTEGER;
C_EN_TIME_TAG  : INTEGER;
C_TIME_TAG_WIDTH : INTEGER;
C_ILA_CLK_FREQ : INTEGER;
C_PROBE0_WIDTH : INTEGER;
C_PROBE1_WIDTH : INTEGER;
C_PROBE2_WIDTH : INTEGER;
C_PROBE3_WIDTH : INTEGER;
C_PROBE4_WIDTH : INTEGER;
C_PROBE5_WIDTH : INTEGER;
C_PROBE6_WIDTH : INTEGER;
C_PROBE7_WIDTH : INTEGER;
C_PROBE8_WIDTH : INTEGER;
C_PROBE9_WIDTH : INTEGER;
C_PROBE10_WIDTH : INTEGER;
C_PROBE11_WIDTH : INTEGER;
C_PROBE12_WIDTH : INTEGER;
C_PROBE13_WIDTH : INTEGER;
C_PROBE14_WIDTH : INTEGER;
C_PROBE15_WIDTH : INTEGER;
C_PROBE16_WIDTH : INTEGER;
C_PROBE17_WIDTH : INTEGER;
C_PROBE18_WIDTH : INTEGER;
C_PROBE19_WIDTH : INTEGER;
C_PROBE20_WIDTH : INTEGER;
C_PROBE21_WIDTH : INTEGER;
C_PROBE22_WIDTH : INTEGER;
C_PROBE23_WIDTH : INTEGER;
C_PROBE24_WIDTH : INTEGER;
C_PROBE25_WIDTH : INTEGER;
C_PROBE26_WIDTH : INTEGER;
C_PROBE27_WIDTH : INTEGER;
C_PROBE28_WIDTH : INTEGER;
C_PROBE29_WIDTH : INTEGER;
C_PROBE30_WIDTH : INTEGER;
C_PROBE31_WIDTH : INTEGER;
C_PROBE32_WIDTH : INTEGER;
C_PROBE33_WIDTH : INTEGER;
C_PROBE34_WIDTH : INTEGER;
C_PROBE35_WIDTH : INTEGER;
C_PROBE36_WIDTH : INTEGER;
C_PROBE37_WIDTH : INTEGER;
C_PROBE38_WIDTH : INTEGER;
C_PROBE39_WIDTH : INTEGER;
C_PROBE40_WIDTH : INTEGER;
C_PROBE41_WIDTH : INTEGER;
C_PROBE42_WIDTH : INTEGER;
C_PROBE43_WIDTH : INTEGER;
C_PROBE44_WIDTH : INTEGER;
C_PROBE45_WIDTH : INTEGER;
C_PROBE46_WIDTH : INTEGER;
C_PROBE47_WIDTH : INTEGER;
C_PROBE48_WIDTH : INTEGER;
C_PROBE49_WIDTH : INTEGER;
C_PROBE50_WIDTH : INTEGER;
C_PROBE51_WIDTH : INTEGER;
C_PROBE52_WIDTH : INTEGER;
C_PROBE53_WIDTH : INTEGER;
C_PROBE54_WIDTH : INTEGER;
C_PROBE55_WIDTH : INTEGER;
C_PROBE56_WIDTH : INTEGER;
C_PROBE57_WIDTH : INTEGER;
C_PROBE58_WIDTH : INTEGER;
C_PROBE59_WIDTH : INTEGER;
C_PROBE60_WIDTH : INTEGER;
C_PROBE61_WIDTH : INTEGER;
C_PROBE62_WIDTH : INTEGER;
C_PROBE63_WIDTH : INTEGER;
C_PROBE64_WIDTH : INTEGER;
C_PROBE65_WIDTH : INTEGER;
C_PROBE66_WIDTH : INTEGER;
C_PROBE67_WIDTH : INTEGER;
C_PROBE68_WIDTH : INTEGER;
C_PROBE69_WIDTH : INTEGER;
C_PROBE70_WIDTH : INTEGER;
C_PROBE71_WIDTH : INTEGER;
C_PROBE72_WIDTH : INTEGER;
C_PROBE73_WIDTH : INTEGER;
C_PROBE74_WIDTH : INTEGER;
C_PROBE75_WIDTH : INTEGER;
C_PROBE76_WIDTH : INTEGER;
C_PROBE77_WIDTH : INTEGER;
C_PROBE78_WIDTH : INTEGER;
C_PROBE79_WIDTH : INTEGER;
C_PROBE80_WIDTH : INTEGER;
C_PROBE81_WIDTH : INTEGER;
C_PROBE82_WIDTH : INTEGER;
C_PROBE83_WIDTH : INTEGER;
C_PROBE84_WIDTH : INTEGER;
C_PROBE85_WIDTH : INTEGER;
C_PROBE86_WIDTH : INTEGER;
C_PROBE87_WIDTH : INTEGER;
C_PROBE88_WIDTH : INTEGER;
C_PROBE89_WIDTH : INTEGER;
C_PROBE90_WIDTH : INTEGER;
C_PROBE91_WIDTH : INTEGER;
C_PROBE92_WIDTH : INTEGER;
C_PROBE93_WIDTH : INTEGER;
C_PROBE94_WIDTH : INTEGER;
C_PROBE95_WIDTH : INTEGER;
C_PROBE96_WIDTH : INTEGER;
C_PROBE97_WIDTH : INTEGER;
C_PROBE98_WIDTH : INTEGER;
C_PROBE99_WIDTH : INTEGER;
C_PROBE100_WIDTH : INTEGER;
C_PROBE101_WIDTH : INTEGER;
C_PROBE102_WIDTH : INTEGER;
C_PROBE103_WIDTH : INTEGER;
C_PROBE104_WIDTH : INTEGER;
C_PROBE105_WIDTH : INTEGER;
C_PROBE106_WIDTH : INTEGER;
C_PROBE107_WIDTH : INTEGER;
C_PROBE108_WIDTH : INTEGER;
C_PROBE109_WIDTH : INTEGER;
C_PROBE110_WIDTH : INTEGER;
C_PROBE111_WIDTH : INTEGER;
C_PROBE112_WIDTH : INTEGER;
C_PROBE113_WIDTH : INTEGER;
C_PROBE114_WIDTH : INTEGER;
C_PROBE115_WIDTH : INTEGER;
C_PROBE116_WIDTH : INTEGER;
C_PROBE117_WIDTH : INTEGER;
C_PROBE118_WIDTH : INTEGER;
C_PROBE119_WIDTH : INTEGER;
C_PROBE120_WIDTH : INTEGER;
C_PROBE121_WIDTH : INTEGER;
C_PROBE122_WIDTH : INTEGER;
C_PROBE123_WIDTH : INTEGER;
C_PROBE124_WIDTH : INTEGER;
C_PROBE125_WIDTH : INTEGER;
C_PROBE126_WIDTH : INTEGER;
C_PROBE127_WIDTH : INTEGER;
C_PROBE128_WIDTH : INTEGER;
C_PROBE129_WIDTH : INTEGER;
C_PROBE130_WIDTH : INTEGER;
C_PROBE131_WIDTH : INTEGER;
C_PROBE132_WIDTH : INTEGER;
C_PROBE133_WIDTH : INTEGER;
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
probe674 : IN STD_LOGIC_VECTOR(0 DOWNTO 0);
probe675 : IN STD_LOGIC_VECTOR(0 DOWNTO 0);
probe676 : IN STD_LOGIC_VECTOR(0 DOWNTO 0);
probe677 : IN STD_LOGIC_VECTOR(0 DOWNTO 0);
probe678 : IN STD_LOGIC_VECTOR(0 DOWNTO 0);
probe679 : IN STD_LOGIC_VECTOR(0 DOWNTO 0);
probe680 : IN STD_LOGIC_VECTOR(0 DOWNTO 0);
probe681 : IN STD_LOGIC_VECTOR(0 DOWNTO 0);
probe682 : IN STD_LOGIC_VECTOR(0 DOWNTO 0);
probe683 : IN STD_LOGIC_VECTOR(0 DOWNTO 0);
probe684 : IN STD_LOGIC_VECTOR(0 DOWNTO 0);
probe685 : IN STD_LOGIC_VECTOR(0 DOWNTO 0);
probe686 : IN STD_LOGIC_VECTOR(0 DOWNTO 0);
probe687 : IN STD_LOGIC_VECTOR(0 DOWNTO 0);
probe688 : IN STD_LOGIC_VECTOR(0 DOWNTO 0);
probe689 : IN STD_LOGIC_VECTOR(0 DOWNTO 0);
probe690 : IN STD_LOGIC_VECTOR(0 DOWNTO 0);
probe691 : IN STD_LOGIC_VECTOR(0 DOWNTO 0);
probe692 : IN STD_LOGIC_VECTOR(0 DOWNTO 0);
probe693 : IN STD_LOGIC_VECTOR(0 DOWNTO 0);
probe694 : IN STD_LOGIC_VECTOR(0 DOWNTO 0);
probe695 : IN STD_LOGIC_VECTOR(0 DOWNTO 0);
probe696 : IN STD_LOGIC_VECTOR(0 DOWNTO 0);
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
