VicidominiLab/BrightEyes-TTM/FPGA/ttm/project/ttm.ip_user_files/ip/ila_1/ila_1_stub.vhdl

-- Copyright 1986-2017 Xilinx, Inc. All Rights Reserved.
-- --------------------------------------------------------------------------------
-- Tool Version: Vivado v.2017.4 (lin64) Build 2086221 Fri Dec 15 20:54:30 MST 2017
-- Date        : Tue Aug 17 08:47:06 2021
-- Host        : IITMMSDL002 running 64-bit Linux Mint 20.2
-- Command     : write_vhdl -force -mode synth_stub -rename_top ila_1 -prefix
--               ila_1_ ila_1_stub.vhdl
-- Design      : ila_1
-- Purpose     : Stub declaration of top-level module interface
-- Device      : xc7k325tffg900-2
-- --------------------------------------------------------------------------------
library IEEE;
use IEEE.STD_LOGIC_1164.ALL;

entity ila_1 is
  Port ( 
    clk : in STD_LOGIC;
    probe0 : in STD_LOGIC_VECTOR ( 8 downto 0 );
    probe1 : in STD_LOGIC_VECTOR ( 0 to 0 );
    probe2 : in STD_LOGIC_VECTOR ( 0 to 0 );
    probe3 : in STD_LOGIC_VECTOR ( 0 to 0 );
    probe4 : in STD_LOGIC_VECTOR ( 0 to 0 )
  );

end ila_1;

architecture stub of ila_1 is
attribute syn_black_box : boolean;
attribute black_box_pad_pin : string;
attribute syn_black_box of stub : architecture is true;
attribute black_box_pad_pin of stub : architecture is "clk,probe0[8:0],probe1[0:0],probe2[0:0],probe3[0:0],probe4[0:0]";
attribute x_core_info : string;
attribute x_core_info of stub : architecture is "ila,Vivado 2017.4";
begin
end;
