VicidominiLab/BrightEyes-TTM/FPGA/ttm/project/ttm.ip_user_files/ip/ila_data/ila_data_stub.v

// Copyright 1986-2017 Xilinx, Inc. All Rights Reserved.
// --------------------------------------------------------------------------------
// Tool Version: Vivado v.2017.4 (lin64) Build 2086221 Fri Dec 15 20:54:30 MST 2017
// Date        : Tue Aug 24 09:47:49 2021
// Host        : IITMMSDL002 running 64-bit Linux Mint 20.2
// Command     : write_verilog -force -mode synth_stub -rename_top ila_data -prefix
//               ila_data_ ila_data_stub.v
// Design      : ila_data
// Purpose     : Stub declaration of top-level module interface
// Device      : xc7k325tffg900-2
// --------------------------------------------------------------------------------

// This empty module with port declaration file causes synthesis tools to infer a black box for IP.
// The synthesis directives are for Synopsys Synplify support to prevent IO buffer insertion.
// Please paste the declaration into a Verilog source file or add the file as an additional source.
(* x_core_info = "ila,Vivado 2017.4" *)
module ila_data(clk, probe0, probe1, probe2, probe3, probe4, probe5, 
  probe6, probe7, probe8, probe9, probe10)
/* synthesis syn_black_box black_box_pad_pin="clk,probe0[95:0],probe1[0:0],probe2[0:0],probe3[31:0],probe4[0:0],probe5[0:0],probe6[7:0],probe7[95:0],probe8[0:0],probe9[0:0],probe10[0:0]" */;
  input clk;
  input [95:0]probe0;
  input [0:0]probe1;
  input [0:0]probe2;
  input [31:0]probe3;
  input [0:0]probe4;
  input [0:0]probe5;
  input [7:0]probe6;
  input [95:0]probe7;
  input [0:0]probe8;
  input [0:0]probe9;
  input [0:0]probe10;
endmodule
