VicidominiLab/BrightEyes-TTM/FPGA/ttm/project/ttm.ip_user_files/ip/ila_fx3/ila_fx3_stub.v

// Copyright 1986-2017 Xilinx, Inc. All Rights Reserved.
// --------------------------------------------------------------------------------
// Tool Version: Vivado v.2017.4 (lin64) Build 2086221 Fri Dec 15 20:54:30 MST 2017
// Date        : Tue Aug 24 08:41:59 2021
// Host        : IITMMSDL002 running 64-bit Linux Mint 20.2
// Command     : write_verilog -force -mode synth_stub -rename_top ila_fx3 -prefix
//               ila_fx3_ ila_fx3_stub.v
// Design      : ila_fx3
// Purpose     : Stub declaration of top-level module interface
// Device      : xc7k325tffg900-2
// --------------------------------------------------------------------------------

// This empty module with port declaration file causes synthesis tools to infer a black box for IP.
// The synthesis directives are for Synopsys Synplify support to prevent IO buffer insertion.
// Please paste the declaration into a Verilog source file or add the file as an additional source.
(* x_core_info = "ila,Vivado 2017.4" *)
module ila_fx3(clk, probe0, probe1, probe2, probe3, probe4, probe5, 
  probe6, probe7, probe8, probe9, probe10, probe11, probe12, probe13, probe14, probe15, probe16, probe17, 
  probe18, probe19, probe20, probe21, probe22, probe23, probe24, probe25)
/* synthesis syn_black_box black_box_pad_pin="clk,probe0[31:0],probe1[1:0],probe2[0:0],probe3[0:0],probe4[0:0],probe5[0:0],probe6[0:0],probe7[0:0],probe8[0:0],probe9[0:0],probe10[0:0],probe11[0:0],probe12[0:0],probe13[3:0],probe14[0:0],probe15[0:0],probe16[0:0],probe17[31:0],probe18[0:0],probe19[0:0],probe20[0:0],probe21[15:0],probe22[0:0],probe23[31:0],probe24[0:0],probe25[0:0]" */;
  input clk;
  input [31:0]probe0;
  input [1:0]probe1;
  input [0:0]probe2;
  input [0:0]probe3;
  input [0:0]probe4;
  input [0:0]probe5;
  input [0:0]probe6;
  input [0:0]probe7;
  input [0:0]probe8;
  input [0:0]probe9;
  input [0:0]probe10;
  input [0:0]probe11;
  input [0:0]probe12;
  input [3:0]probe13;
  input [0:0]probe14;
  input [0:0]probe15;
  input [0:0]probe16;
  input [31:0]probe17;
  input [0:0]probe18;
  input [0:0]probe19;
  input [0:0]probe20;
  input [15:0]probe21;
  input [0:0]probe22;
  input [31:0]probe23;
  input [0:0]probe24;
  input [0:0]probe25;
endmodule
