VicidominiLab/BrightEyes-TTM/FPGA/ttm/hdl/ip/fifo_generator_0_1/fifo_generator_0_stub.v

// Copyright 1986-2017 Xilinx, Inc. All Rights Reserved.
// --------------------------------------------------------------------------------
// Tool Version: Vivado v.2017.4 (lin64) Build 2086221 Fri Dec 15 20:54:30 MST 2017
// Date        : Wed Nov 18 15:34:24 2020
// Host        : IITMMSDL002 running 64-bit Linux Mint 20
// Command     : write_verilog -force -mode synth_stub
//               /home/mdonato-fast/myDev/timetaggingplatform/ttp-tdc.srcs/sources_1/ip/fifo_generator_0_1/fifo_generator_0_stub.v
// Design      : fifo_generator_0
// Purpose     : Stub declaration of top-level module interface
// Device      : xc7k325tffg900-2
// --------------------------------------------------------------------------------

// This empty module with port declaration file causes synthesis tools to infer a black box for IP.
// The synthesis directives are for Synopsys Synplify support to prevent IO buffer insertion.
// Please paste the declaration into a Verilog source file or add the file as an additional source.
(* x_core_info = "fifo_generator_v13_2_1,Vivado 2017.4" *)
module fifo_generator_0(rst, wr_clk, rd_clk, din, wr_en, rd_en, dout, full, 
  almost_full, empty, almost_empty, prog_full, prog_empty, wr_rst_busy, rd_rst_busy)
/* synthesis syn_black_box black_box_pad_pin="rst,wr_clk,rd_clk,din[255:0],wr_en,rd_en,dout[31:0],full,almost_full,empty,almost_empty,prog_full,prog_empty,wr_rst_busy,rd_rst_busy" */;
  input rst;
  input wr_clk;
  input rd_clk;
  input [255:0]din;
  input wr_en;
  input rd_en;
  output [31:0]dout;
  output full;
  output almost_full;
  output empty;
  output almost_empty;
  output prog_full;
  output prog_empty;
  output wr_rst_busy;
  output rd_rst_busy;
endmodule
