VicidominiLab/BrightEyes-TTM/FPGA/ttm/hdl/ip/clockMainGen/clockMainGen_sim_netlist.vhdl

-- Copyright 1986-2017 Xilinx, Inc. All Rights Reserved.
-- --------------------------------------------------------------------------------
-- Tool Version: Vivado v.2017.4 (lin64) Build 2086221 Fri Dec 15 20:54:30 MST 2017
-- Date        : Tue Jul 13 12:27:37 2021
-- Host        : IITMMSDL002 running 64-bit Linux Mint 20.1
-- Command     : write_vhdl -force -mode funcsim -rename_top clockMainGen -prefix
--               clockMainGen_ clockMainGen_sim_netlist.vhdl
-- Design      : clockMainGen
-- Purpose     : This VHDL netlist is a functional simulation representation of the design and should not be modified or
--               synthesized. This netlist cannot be used for SDF annotated simulation.
-- Device      : xc7k325tffg900-2
-- --------------------------------------------------------------------------------
library IEEE;
use IEEE.STD_LOGIC_1164.ALL;
library UNISIM;
use UNISIM.VCOMPONENTS.ALL;
entity clockMainGen_clockMainGen_clk_wiz is
  port (
    clk_240 : out STD_LOGIC;
    clk_400 : out STD_LOGIC;
    clk_50 : out STD_LOGIC;
    clk_100 : out STD_LOGIC;
    reset : in STD_LOGIC;
    locked : out STD_LOGIC;
    clk_in1_p : in STD_LOGIC;
    clk_in1_n : in STD_LOGIC
  );
end clockMainGen_clockMainGen_clk_wiz;

architecture STRUCTURE of clockMainGen_clockMainGen_clk_wiz is
  signal clk_100_clockMainGen : STD_LOGIC;
  signal clk_100_clockMainGen_en_clk : STD_LOGIC;
  signal clk_240_clockMainGen : STD_LOGIC;
  signal clk_240_clockMainGen_en_clk : STD_LOGIC;
  signal clk_400_clockMainGen : STD_LOGIC;
  signal clk_400_clockMainGen_en_clk : STD_LOGIC;
  signal clk_50_clockMainGen : STD_LOGIC;
  signal clk_50_clockMainGen_en_clk : STD_LOGIC;
  signal clk_in1_clockMainGen : STD_LOGIC;
  signal clkfbout_buf_clockMainGen : STD_LOGIC;
  signal clkfbout_clockMainGen : STD_LOGIC;
  signal \^locked\ : STD_LOGIC;
  signal seq_reg1 : STD_LOGIC_VECTOR ( 7 downto 0 );
  attribute RTL_KEEP : string;
  attribute RTL_KEEP of seq_reg1 : signal is "true";
  attribute async_reg : string;
  attribute async_reg of seq_reg1 : signal is "true";
  signal seq_reg2 : STD_LOGIC_VECTOR ( 7 downto 0 );
  attribute RTL_KEEP of seq_reg2 : signal is "true";
  attribute async_reg of seq_reg2 : signal is "true";
  signal seq_reg3 : STD_LOGIC_VECTOR ( 7 downto 0 );
  attribute RTL_KEEP of seq_reg3 : signal is "true";
  attribute async_reg of seq_reg3 : signal is "true";
  signal seq_reg4 : STD_LOGIC_VECTOR ( 7 downto 0 );
  attribute RTL_KEEP of seq_reg4 : signal is "true";
  attribute async_reg of seq_reg4 : signal is "true";
  signal NLW_mmcm_adv_inst_CLKFBOUTB_UNCONNECTED : STD_LOGIC;
  signal NLW_mmcm_adv_inst_CLKFBSTOPPED_UNCONNECTED : STD_LOGIC;
  signal NLW_mmcm_adv_inst_CLKINSTOPPED_UNCONNECTED : STD_LOGIC;
  signal NLW_mmcm_adv_inst_CLKOUT0B_UNCONNECTED : STD_LOGIC;
  signal NLW_mmcm_adv_inst_CLKOUT1B_UNCONNECTED : STD_LOGIC;
  signal NLW_mmcm_adv_inst_CLKOUT2B_UNCONNECTED : STD_LOGIC;
  signal NLW_mmcm_adv_inst_CLKOUT3B_UNCONNECTED : STD_LOGIC;
  signal NLW_mmcm_adv_inst_CLKOUT4_UNCONNECTED : STD_LOGIC;
  signal NLW_mmcm_adv_inst_CLKOUT5_UNCONNECTED : STD_LOGIC;
  signal NLW_mmcm_adv_inst_CLKOUT6_UNCONNECTED : STD_LOGIC;
  signal NLW_mmcm_adv_inst_DRDY_UNCONNECTED : STD_LOGIC;
  signal NLW_mmcm_adv_inst_PSDONE_UNCONNECTED : STD_LOGIC;
  signal NLW_mmcm_adv_inst_DO_UNCONNECTED : STD_LOGIC_VECTOR ( 15 downto 0 );
  attribute BOX_TYPE : string;
  attribute BOX_TYPE of clkf_buf : label is "PRIMITIVE";
  attribute BOX_TYPE of clkin1_ibufgds : label is "PRIMITIVE";
  attribute CAPACITANCE : string;
  attribute CAPACITANCE of clkin1_ibufgds : label is "DONT_CARE";
  attribute IBUF_DELAY_VALUE : string;
  attribute IBUF_DELAY_VALUE of clkin1_ibufgds : label is "0";
  attribute IFD_DELAY_VALUE : string;
  attribute IFD_DELAY_VALUE of clkin1_ibufgds : label is "AUTO";
  attribute BOX_TYPE of clkout1_buf : label is "PRIMITIVE";
  attribute XILINX_LEGACY_PRIM : string;
  attribute XILINX_LEGACY_PRIM of clkout1_buf : label is "BUFGCE";
  attribute XILINX_TRANSFORM_PINMAP : string;
  attribute XILINX_TRANSFORM_PINMAP of clkout1_buf : label is "CE:CE0 I:I0";
  attribute BOX_TYPE of clkout1_buf_en : label is "PRIMITIVE";
  attribute BOX_TYPE of clkout2_buf : label is "PRIMITIVE";
  attribute XILINX_LEGACY_PRIM of clkout2_buf : label is "BUFGCE";
  attribute XILINX_TRANSFORM_PINMAP of clkout2_buf : label is "CE:CE0 I:I0";
  attribute BOX_TYPE of clkout2_buf_en : label is "PRIMITIVE";
  attribute BOX_TYPE of clkout3_buf : label is "PRIMITIVE";
  attribute XILINX_LEGACY_PRIM of clkout3_buf : label is "BUFGCE";
  attribute XILINX_TRANSFORM_PINMAP of clkout3_buf : label is "CE:CE0 I:I0";
  attribute BOX_TYPE of clkout3_buf_en : label is "PRIMITIVE";
  attribute BOX_TYPE of clkout4_buf : label is "PRIMITIVE";
  attribute XILINX_LEGACY_PRIM of clkout4_buf : label is "BUFGCE";
  attribute XILINX_TRANSFORM_PINMAP of clkout4_buf : label is "CE:CE0 I:I0";
  attribute BOX_TYPE of clkout4_buf_en : label is "PRIMITIVE";
  attribute BOX_TYPE of mmcm_adv_inst : label is "PRIMITIVE";
  attribute ASYNC_REG_boolean : boolean;
  attribute ASYNC_REG_boolean of \seq_reg1_reg[0]\ : label is std.standard.true;
  attribute ASYNC_REG_boolean of \seq_reg1_reg[1]\ : label is std.standard.true;
  attribute ASYNC_REG_boolean of \seq_reg1_reg[2]\ : label is std.standard.true;
  attribute ASYNC_REG_boolean of \seq_reg1_reg[3]\ : label is std.standard.true;
  attribute ASYNC_REG_boolean of \seq_reg1_reg[4]\ : label is std.standard.true;
  attribute ASYNC_REG_boolean of \seq_reg1_reg[5]\ : label is std.standard.true;
  attribute ASYNC_REG_boolean of \seq_reg1_reg[6]\ : label is std.standard.true;
  attribute ASYNC_REG_boolean of \seq_reg1_reg[7]\ : label is std.standard.true;
  attribute ASYNC_REG_boolean of \seq_reg2_reg[0]\ : label is std.standard.true;
  attribute ASYNC_REG_boolean of \seq_reg2_reg[1]\ : label is std.standard.true;
  attribute ASYNC_REG_boolean of \seq_reg2_reg[2]\ : label is std.standard.true;
  attribute ASYNC_REG_boolean of \seq_reg2_reg[3]\ : label is std.standard.true;
  attribute ASYNC_REG_boolean of \seq_reg2_reg[4]\ : label is std.standard.true;
  attribute ASYNC_REG_boolean of \seq_reg2_reg[5]\ : label is std.standard.true;
  attribute ASYNC_REG_boolean of \seq_reg2_reg[6]\ : label is std.standard.true;
  attribute ASYNC_REG_boolean of \seq_reg2_reg[7]\ : label is std.standard.true;
  attribute ASYNC_REG_boolean of \seq_reg3_reg[0]\ : label is std.standard.true;
  attribute ASYNC_REG_boolean of \seq_reg3_reg[1]\ : label is std.standard.true;
  attribute ASYNC_REG_boolean of \seq_reg3_reg[2]\ : label is std.standard.true;
  attribute ASYNC_REG_boolean of \seq_reg3_reg[3]\ : label is std.standard.true;
  attribute ASYNC_REG_boolean of \seq_reg3_reg[4]\ : label is std.standard.true;
  attribute ASYNC_REG_boolean of \seq_reg3_reg[5]\ : label is std.standard.true;
  attribute ASYNC_REG_boolean of \seq_reg3_reg[6]\ : label is std.standard.true;
  attribute ASYNC_REG_boolean of \seq_reg3_reg[7]\ : label is std.standard.true;
  attribute ASYNC_REG_boolean of \seq_reg4_reg[0]\ : label is std.standard.true;
  attribute ASYNC_REG_boolean of \seq_reg4_reg[1]\ : label is std.standard.true;
  attribute ASYNC_REG_boolean of \seq_reg4_reg[2]\ : label is std.standard.true;
  attribute ASYNC_REG_boolean of \seq_reg4_reg[3]\ : label is std.standard.true;
  attribute ASYNC_REG_boolean of \seq_reg4_reg[4]\ : label is std.standard.true;
  attribute ASYNC_REG_boolean of \seq_reg4_reg[5]\ : label is std.standard.true;
  attribute ASYNC_REG_boolean of \seq_reg4_reg[6]\ : label is std.standard.true;
  attribute ASYNC_REG_boolean of \seq_reg4_reg[7]\ : label is std.standard.true;
begin
  locked <= \^locked\;
clkf_buf: unisim.vcomponents.BUFG
     port map (
      I => clkfbout_clockMainGen,
      O => clkfbout_buf_clockMainGen
    );
clkin1_ibufgds: unisim.vcomponents.IBUFDS
    generic map(
      IOSTANDARD => "DEFAULT"
    )
        port map (
      I => clk_in1_p,
      IB => clk_in1_n,
      O => clk_in1_clockMainGen
    );
clkout1_buf: unisim.vcomponents.BUFGCTRL
    generic map(
      INIT_OUT => 0,
      PRESELECT_I0 => true,
      PRESELECT_I1 => false
    )
        port map (
      CE0 => seq_reg1(7),
      CE1 => '0',
      I0 => clk_240_clockMainGen,
      I1 => '1',
      IGNORE0 => '0',
      IGNORE1 => '1',
      O => clk_240,
      S0 => '1',
      S1 => '0'
    );
clkout1_buf_en: unisim.vcomponents.BUFH
     port map (
      I => clk_240_clockMainGen,
      O => clk_240_clockMainGen_en_clk
    );
clkout2_buf: unisim.vcomponents.BUFGCTRL
    generic map(
      INIT_OUT => 0,
      PRESELECT_I0 => true,
      PRESELECT_I1 => false
    )
        port map (
      CE0 => seq_reg2(7),
      CE1 => '0',
      I0 => clk_400_clockMainGen,
      I1 => '1',
      IGNORE0 => '0',
      IGNORE1 => '1',
      O => clk_400,
      S0 => '1',
      S1 => '0'
    );
clkout2_buf_en: unisim.vcomponents.BUFH
     port map (
      I => clk_400_clockMainGen,
      O => clk_400_clockMainGen_en_clk
    );
clkout3_buf: unisim.vcomponents.BUFGCTRL
    generic map(
      INIT_OUT => 0,
      PRESELECT_I0 => true,
      PRESELECT_I1 => false
    )
        port map (
      CE0 => seq_reg3(7),
      CE1 => '0',
      I0 => clk_50_clockMainGen,
      I1 => '1',
      IGNORE0 => '0',
      IGNORE1 => '1',
      O => clk_50,
      S0 => '1',
      S1 => '0'
    );
clkout3_buf_en: unisim.vcomponents.BUFH
     port map (
      I => clk_50_clockMainGen,
      O => clk_50_clockMainGen_en_clk
    );
clkout4_buf: unisim.vcomponents.BUFGCTRL
    generic map(
      INIT_OUT => 0,
      PRESELECT_I0 => true,
      PRESELECT_I1 => false
    )
        port map (
      CE0 => seq_reg4(7),
      CE1 => '0',
      I0 => clk_100_clockMainGen,
      I1 => '1',
      IGNORE0 => '0',
      IGNORE1 => '1',
      O => clk_100,
      S0 => '1',
      S1 => '0'
    );
clkout4_buf_en: unisim.vcomponents.BUFH
     port map (
      I => clk_100_clockMainGen,
      O => clk_100_clockMainGen_en_clk
    );
mmcm_adv_inst: unisim.vcomponents.MMCME2_ADV
    generic map(
      BANDWIDTH => "HIGH",
      CLKFBOUT_MULT_F => 6.000000,
      CLKFBOUT_PHASE => 0.000000,
      CLKFBOUT_USE_FINE_PS => false,
      CLKIN1_PERIOD => 5.000000,
      CLKIN2_PERIOD => 0.000000,
      CLKOUT0_DIVIDE_F => 5.000000,
      CLKOUT0_DUTY_CYCLE => 0.500000,
      CLKOUT0_PHASE => 0.000000,
      CLKOUT0_USE_FINE_PS => false,
      CLKOUT1_DIVIDE => 3,
      CLKOUT1_DUTY_CYCLE => 0.500000,
      CLKOUT1_PHASE => 0.000000,
      CLKOUT1_USE_FINE_PS => false,
      CLKOUT2_DIVIDE => 24,
      CLKOUT2_DUTY_CYCLE => 0.500000,
      CLKOUT2_PHASE => 0.000000,
      CLKOUT2_USE_FINE_PS => false,
      CLKOUT3_DIVIDE => 12,
      CLKOUT3_DUTY_CYCLE => 0.500000,
      CLKOUT3_PHASE => 0.000000,
      CLKOUT3_USE_FINE_PS => false,
      CLKOUT4_CASCADE => false,
      CLKOUT4_DIVIDE => 1,
      CLKOUT4_DUTY_CYCLE => 0.500000,
      CLKOUT4_PHASE => 0.000000,
      CLKOUT4_USE_FINE_PS => false,
      CLKOUT5_DIVIDE => 1,
      CLKOUT5_DUTY_CYCLE => 0.500000,
      CLKOUT5_PHASE => 0.000000,
      CLKOUT5_USE_FINE_PS => false,
      CLKOUT6_DIVIDE => 1,
      CLKOUT6_DUTY_CYCLE => 0.500000,
      CLKOUT6_PHASE => 0.000000,
      CLKOUT6_USE_FINE_PS => false,
      COMPENSATION => "ZHOLD",
      DIVCLK_DIVIDE => 1,
      IS_CLKINSEL_INVERTED => '0',
      IS_PSEN_INVERTED => '0',
      IS_PSINCDEC_INVERTED => '0',
      IS_PWRDWN_INVERTED => '0',
      IS_RST_INVERTED => '0',
      REF_JITTER1 => 0.010000,
      REF_JITTER2 => 0.010000,
      SS_EN => "FALSE",
      SS_MODE => "CENTER_HIGH",
      SS_MOD_PERIOD => 10000,
      STARTUP_WAIT => false
    )
        port map (
      CLKFBIN => clkfbout_buf_clockMainGen,
      CLKFBOUT => clkfbout_clockMainGen,
      CLKFBOUTB => NLW_mmcm_adv_inst_CLKFBOUTB_UNCONNECTED,
      CLKFBSTOPPED => NLW_mmcm_adv_inst_CLKFBSTOPPED_UNCONNECTED,
      CLKIN1 => clk_in1_clockMainGen,
      CLKIN2 => '0',
      CLKINSEL => '1',
      CLKINSTOPPED => NLW_mmcm_adv_inst_CLKINSTOPPED_UNCONNECTED,
      CLKOUT0 => clk_240_clockMainGen,
      CLKOUT0B => NLW_mmcm_adv_inst_CLKOUT0B_UNCONNECTED,
      CLKOUT1 => clk_400_clockMainGen,
      CLKOUT1B => NLW_mmcm_adv_inst_CLKOUT1B_UNCONNECTED,
      CLKOUT2 => clk_50_clockMainGen,
      CLKOUT2B => NLW_mmcm_adv_inst_CLKOUT2B_UNCONNECTED,
      CLKOUT3 => clk_100_clockMainGen,
      CLKOUT3B => NLW_mmcm_adv_inst_CLKOUT3B_UNCONNECTED,
      CLKOUT4 => NLW_mmcm_adv_inst_CLKOUT4_UNCONNECTED,
      CLKOUT5 => NLW_mmcm_adv_inst_CLKOUT5_UNCONNECTED,
      CLKOUT6 => NLW_mmcm_adv_inst_CLKOUT6_UNCONNECTED,
      DADDR(6 downto 0) => B"0000000",
      DCLK => '0',
      DEN => '0',
      DI(15 downto 0) => B"0000000000000000",
      DO(15 downto 0) => NLW_mmcm_adv_inst_DO_UNCONNECTED(15 downto 0),
      DRDY => NLW_mmcm_adv_inst_DRDY_UNCONNECTED,
      DWE => '0',
      LOCKED => \^locked\,
      PSCLK => '0',
      PSDONE => NLW_mmcm_adv_inst_PSDONE_UNCONNECTED,
      PSEN => '0',
      PSINCDEC => '0',
      PWRDWN => '0',
      RST => reset
    );
\seq_reg1_reg[0]\: unisim.vcomponents.FDCE
    generic map(
      INIT => '0'
    )
        port map (
      C => clk_240_clockMainGen_en_clk,
      CE => '1',
      CLR => reset,
      D => \^locked\,
      Q => seq_reg1(0)
    );
\seq_reg1_reg[1]\: unisim.vcomponents.FDCE
    generic map(
      INIT => '0'
    )
        port map (
      C => clk_240_clockMainGen_en_clk,
      CE => '1',
      CLR => reset,
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
  port (
    clk_240 : out STD_LOGIC;
    clk_400 : out STD_LOGIC;
    clk_50 : out STD_LOGIC;
    clk_100 : out STD_LOGIC;
    reset : in STD_LOGIC;
    locked : out STD_LOGIC;
    clk_in1_p : in STD_LOGIC;
    clk_in1_n : in STD_LOGIC
  );
  attribute NotValidForBitStream : boolean;
  attribute NotValidForBitStream of clockMainGen : entity is true;
end clockMainGen;

architecture STRUCTURE of clockMainGen is
begin
inst: entity work.clockMainGen_clockMainGen_clk_wiz
     port map (
      clk_100 => clk_100,
      clk_240 => clk_240,
      clk_400 => clk_400,
      clk_50 => clk_50,
      clk_in1_n => clk_in1_n,
      clk_in1_p => clk_in1_p,
      locked => locked,
      reset => reset
    );
end STRUCTURE;
