VicidominiLab/BrightEyes-TTM/FPGA/ttm/hdl/ip/fifo_generator_0_1/fifo_generator_0_sim_netlist.v

// Copyright 1986-2017 Xilinx, Inc. All Rights Reserved.
// --------------------------------------------------------------------------------
// Tool Version: Vivado v.2017.4 (lin64) Build 2086221 Fri Dec 15 20:54:30 MST 2017
// Date        : Wed Nov 18 15:34:24 2020
// Host        : IITMMSDL002 running 64-bit Linux Mint 20
// Command     : write_verilog -force -mode funcsim
//               /home/mdonato-fast/myDev/timetaggingplatform/ttp-tdc.srcs/sources_1/ip/fifo_generator_0_1/fifo_generator_0_sim_netlist.v
// Design      : fifo_generator_0
// Purpose     : This verilog netlist is a functional simulation representation of the design and should not be modified
//               or synthesized. This netlist cannot be used for SDF annotated simulation.
// Device      : xc7k325tffg900-2
// --------------------------------------------------------------------------------
`timescale 1 ps / 1 ps

(* CHECK_LICENSE_TYPE = "fifo_generator_0,fifo_generator_v13_2_1,{}" *) (* downgradeipidentifiedwarnings = "yes" *) (* x_core_info = "fifo_generator_v13_2_1,Vivado 2017.4" *) 
(* NotValidForBitStream *)
module fifo_generator_0
   (rst,
    wr_clk,
    rd_clk,
    din,
    wr_en,
    rd_en,
    dout,
    full,
    almost_full,
    empty,
    almost_empty,
    prog_full,
    prog_empty,
    wr_rst_busy,
    rd_rst_busy);
  input rst;
  (* x_interface_info = "xilinx.com:signal:clock:1.0 write_clk CLK" *) (* x_interface_parameter = "XIL_INTERFACENAME write_clk, FREQ_HZ 100000000, PHASE 0.000" *) input wr_clk;
  (* x_interface_info = "xilinx.com:signal:clock:1.0 read_clk CLK" *) (* x_interface_parameter = "XIL_INTERFACENAME read_clk, FREQ_HZ 100000000, PHASE 0.000" *) input rd_clk;
  (* x_interface_info = "xilinx.com:interface:fifo_write:1.0 FIFO_WRITE WR_DATA" *) input [255:0]din;
  (* x_interface_info = "xilinx.com:interface:fifo_write:1.0 FIFO_WRITE WR_EN" *) input wr_en;
  (* x_interface_info = "xilinx.com:interface:fifo_read:1.0 FIFO_READ RD_EN" *) input rd_en;
  (* x_interface_info = "xilinx.com:interface:fifo_read:1.0 FIFO_READ RD_DATA" *) output [31:0]dout;
  (* x_interface_info = "xilinx.com:interface:fifo_write:1.0 FIFO_WRITE FULL" *) output full;
  (* x_interface_info = "xilinx.com:interface:fifo_write:1.0 FIFO_WRITE ALMOST_FULL" *) output almost_full;
  (* x_interface_info = "xilinx.com:interface:fifo_read:1.0 FIFO_READ EMPTY" *) output empty;
  (* x_interface_info = "xilinx.com:interface:fifo_read:1.0 FIFO_READ ALMOST_EMPTY" *) output almost_empty;
  output prog_full;
  output prog_empty;
  output wr_rst_busy;
  output rd_rst_busy;

  wire almost_empty;
  wire almost_full;
  wire [255:0]din;
  wire [31:0]dout;
  wire empty;
  wire full;
  wire prog_empty;
  wire prog_full;
  wire rd_clk;
  wire rd_en;
  wire rd_rst_busy;
  wire rst;
  wire wr_clk;
  wire wr_en;
  wire wr_rst_busy;
  wire NLW_U0_axi_ar_dbiterr_UNCONNECTED;
  wire NLW_U0_axi_ar_overflow_UNCONNECTED;
  wire NLW_U0_axi_ar_prog_empty_UNCONNECTED;
  wire NLW_U0_axi_ar_prog_full_UNCONNECTED;
  wire NLW_U0_axi_ar_sbiterr_UNCONNECTED;
  wire NLW_U0_axi_ar_underflow_UNCONNECTED;
  wire NLW_U0_axi_aw_dbiterr_UNCONNECTED;
  wire NLW_U0_axi_aw_overflow_UNCONNECTED;
  wire NLW_U0_axi_aw_prog_empty_UNCONNECTED;
  wire NLW_U0_axi_aw_prog_full_UNCONNECTED;
  wire NLW_U0_axi_aw_sbiterr_UNCONNECTED;
  wire NLW_U0_axi_aw_underflow_UNCONNECTED;
  wire NLW_U0_axi_b_dbiterr_UNCONNECTED;
  wire NLW_U0_axi_b_overflow_UNCONNECTED;
  wire NLW_U0_axi_b_prog_empty_UNCONNECTED;
  wire NLW_U0_axi_b_prog_full_UNCONNECTED;
  wire NLW_U0_axi_b_sbiterr_UNCONNECTED;
  wire NLW_U0_axi_b_underflow_UNCONNECTED;
  wire NLW_U0_axi_r_dbiterr_UNCONNECTED;
  wire NLW_U0_axi_r_overflow_UNCONNECTED;
  wire NLW_U0_axi_r_prog_empty_UNCONNECTED;
  wire NLW_U0_axi_r_prog_full_UNCONNECTED;
  wire NLW_U0_axi_r_sbiterr_UNCONNECTED;
  wire NLW_U0_axi_r_underflow_UNCONNECTED;
  wire NLW_U0_axi_w_dbiterr_UNCONNECTED;
  wire NLW_U0_axi_w_overflow_UNCONNECTED;
  wire NLW_U0_axi_w_prog_empty_UNCONNECTED;
  wire NLW_U0_axi_w_prog_full_UNCONNECTED;
  wire NLW_U0_axi_w_sbiterr_UNCONNECTED;
  wire NLW_U0_axi_w_underflow_UNCONNECTED;
  wire NLW_U0_axis_dbiterr_UNCONNECTED;
  wire NLW_U0_axis_overflow_UNCONNECTED;
  wire NLW_U0_axis_prog_empty_UNCONNECTED;
  wire NLW_U0_axis_prog_full_UNCONNECTED;
  wire NLW_U0_axis_sbiterr_UNCONNECTED;
  wire NLW_U0_axis_underflow_UNCONNECTED;
  wire NLW_U0_dbiterr_UNCONNECTED;
  wire NLW_U0_m_axi_arvalid_UNCONNECTED;
  wire NLW_U0_m_axi_awvalid_UNCONNECTED;
  wire NLW_U0_m_axi_bready_UNCONNECTED;
  wire NLW_U0_m_axi_rready_UNCONNECTED;
  wire NLW_U0_m_axi_wlast_UNCONNECTED;
  wire NLW_U0_m_axi_wvalid_UNCONNECTED;
  wire NLW_U0_m_axis_tlast_UNCONNECTED;
  wire NLW_U0_m_axis_tvalid_UNCONNECTED;
  wire NLW_U0_overflow_UNCONNECTED;
  wire NLW_U0_s_axi_arready_UNCONNECTED;
  wire NLW_U0_s_axi_awready_UNCONNECTED;
  wire NLW_U0_s_axi_bvalid_UNCONNECTED;
  wire NLW_U0_s_axi_rlast_UNCONNECTED;
  wire NLW_U0_s_axi_rvalid_UNCONNECTED;
  wire NLW_U0_s_axi_wready_UNCONNECTED;
  wire NLW_U0_s_axis_tready_UNCONNECTED;
  wire NLW_U0_sbiterr_UNCONNECTED;
  wire NLW_U0_underflow_UNCONNECTED;
  wire NLW_U0_valid_UNCONNECTED;
  wire NLW_U0_wr_ack_UNCONNECTED;
  wire [4:0]NLW_U0_axi_ar_data_count_UNCONNECTED;
  wire [4:0]NLW_U0_axi_ar_rd_data_count_UNCONNECTED;
  wire [4:0]NLW_U0_axi_ar_wr_data_count_UNCONNECTED;
  wire [4:0]NLW_U0_axi_aw_data_count_UNCONNECTED;
  wire [4:0]NLW_U0_axi_aw_rd_data_count_UNCONNECTED;
  wire [4:0]NLW_U0_axi_aw_wr_data_count_UNCONNECTED;
  wire [4:0]NLW_U0_axi_b_data_count_UNCONNECTED;
  wire [4:0]NLW_U0_axi_b_rd_data_count_UNCONNECTED;
  wire [4:0]NLW_U0_axi_b_wr_data_count_UNCONNECTED;
  wire [10:0]NLW_U0_axi_r_data_count_UNCONNECTED;
  wire [10:0]NLW_U0_axi_r_rd_data_count_UNCONNECTED;
  wire [10:0]NLW_U0_axi_r_wr_data_count_UNCONNECTED;
  wire [10:0]NLW_U0_axi_w_data_count_UNCONNECTED;
  wire [10:0]NLW_U0_axi_w_rd_data_count_UNCONNECTED;
  wire [10:0]NLW_U0_axi_w_wr_data_count_UNCONNECTED;
  wire [10:0]NLW_U0_axis_data_count_UNCONNECTED;
  wire [10:0]NLW_U0_axis_rd_data_count_UNCONNECTED;
  wire [10:0]NLW_U0_axis_wr_data_count_UNCONNECTED;
  wire [4:0]NLW_U0_data_count_UNCONNECTED;
  wire [31:0]NLW_U0_m_axi_araddr_UNCONNECTED;
  wire [1:0]NLW_U0_m_axi_arburst_UNCONNECTED;
  wire [3:0]NLW_U0_m_axi_arcache_UNCONNECTED;
  wire [0:0]NLW_U0_m_axi_arid_UNCONNECTED;
  wire [7:0]NLW_U0_m_axi_arlen_UNCONNECTED;
  wire [0:0]NLW_U0_m_axi_arlock_UNCONNECTED;
  wire [2:0]NLW_U0_m_axi_arprot_UNCONNECTED;
  wire [3:0]NLW_U0_m_axi_arqos_UNCONNECTED;
  wire [3:0]NLW_U0_m_axi_arregion_UNCONNECTED;
  wire [2:0]NLW_U0_m_axi_arsize_UNCONNECTED;
  wire [0:0]NLW_U0_m_axi_aruser_UNCONNECTED;
  wire [31:0]NLW_U0_m_axi_awaddr_UNCONNECTED;
  wire [1:0]NLW_U0_m_axi_awburst_UNCONNECTED;
  wire [3:0]NLW_U0_m_axi_awcache_UNCONNECTED;
  wire [0:0]NLW_U0_m_axi_awid_UNCONNECTED;
  wire [7:0]NLW_U0_m_axi_awlen_UNCONNECTED;
  wire [0:0]NLW_U0_m_axi_awlock_UNCONNECTED;
  wire [2:0]NLW_U0_m_axi_awprot_UNCONNECTED;
  wire [3:0]NLW_U0_m_axi_awqos_UNCONNECTED;
  wire [3:0]NLW_U0_m_axi_awregion_UNCONNECTED;
  wire [2:0]NLW_U0_m_axi_awsize_UNCONNECTED;
  wire [0:0]NLW_U0_m_axi_awuser_UNCONNECTED;
  wire [63:0]NLW_U0_m_axi_wdata_UNCONNECTED;
  wire [0:0]NLW_U0_m_axi_wid_UNCONNECTED;
  wire [7:0]NLW_U0_m_axi_wstrb_UNCONNECTED;
  wire [0:0]NLW_U0_m_axi_wuser_UNCONNECTED;
  wire [7:0]NLW_U0_m_axis_tdata_UNCONNECTED;
  wire [0:0]NLW_U0_m_axis_tdest_UNCONNECTED;
  wire [0:0]NLW_U0_m_axis_tid_UNCONNECTED;
  wire [0:0]NLW_U0_m_axis_tkeep_UNCONNECTED;
  wire [0:0]NLW_U0_m_axis_tstrb_UNCONNECTED;
  wire [3:0]NLW_U0_m_axis_tuser_UNCONNECTED;
  wire [7:0]NLW_U0_rd_data_count_UNCONNECTED;
  wire [0:0]NLW_U0_s_axi_bid_UNCONNECTED;
  wire [1:0]NLW_U0_s_axi_bresp_UNCONNECTED;
  wire [0:0]NLW_U0_s_axi_buser_UNCONNECTED;
  wire [63:0]NLW_U0_s_axi_rdata_UNCONNECTED;
  wire [0:0]NLW_U0_s_axi_rid_UNCONNECTED;
  wire [1:0]NLW_U0_s_axi_rresp_UNCONNECTED;
  wire [0:0]NLW_U0_s_axi_ruser_UNCONNECTED;
  wire [4:0]NLW_U0_wr_data_count_UNCONNECTED;

  (* C_ADD_NGC_CONSTRAINT = "0" *) 
  (* C_APPLICATION_TYPE_AXIS = "0" *) 
  (* C_APPLICATION_TYPE_RACH = "0" *) 
  (* C_APPLICATION_TYPE_RDCH = "0" *) 
  (* C_APPLICATION_TYPE_WACH = "0" *) 
  (* C_APPLICATION_TYPE_WDCH = "0" *) 
  (* C_APPLICATION_TYPE_WRCH = "0" *) 
  (* C_AXIS_TDATA_WIDTH = "8" *) 
  (* C_AXIS_TDEST_WIDTH = "1" *) 
  (* C_AXIS_TID_WIDTH = "1" *) 
  (* C_AXIS_TKEEP_WIDTH = "1" *) 
  (* C_AXIS_TSTRB_WIDTH = "1" *) 
  (* C_AXIS_TUSER_WIDTH = "4" *) 
  (* C_AXIS_TYPE = "0" *) 
  (* C_AXI_ADDR_WIDTH = "32" *) 
  (* C_AXI_ARUSER_WIDTH = "1" *) 
  (* C_AXI_AWUSER_WIDTH = "1" *) 
  (* C_AXI_BUSER_WIDTH = "1" *) 
  (* C_AXI_DATA_WIDTH = "64" *) 
  (* C_AXI_ID_WIDTH = "1" *) 
  (* C_AXI_LEN_WIDTH = "8" *) 
  (* C_AXI_LOCK_WIDTH = "1" *) 
  (* C_AXI_RUSER_WIDTH = "1" *) 
  (* C_AXI_TYPE = "1" *) 
  (* C_AXI_WUSER_WIDTH = "1" *) 
  (* C_COMMON_CLOCK = "0" *) 
  (* C_COUNT_TYPE = "0" *) 
  (* C_DATA_COUNT_WIDTH = "5" *) 
  (* C_DEFAULT_VALUE = "BlankString" *) 
  (* C_DIN_WIDTH = "256" *) 
  (* C_DIN_WIDTH_AXIS = "1" *) 
  (* C_DIN_WIDTH_RACH = "32" *) 
  (* C_DIN_WIDTH_RDCH = "64" *) 
  (* C_DIN_WIDTH_WACH = "1" *) 
  (* C_DIN_WIDTH_WDCH = "64" *) 
  (* C_DIN_WIDTH_WRCH = "2" *) 
  (* C_DOUT_RST_VAL = "0" *) 
  (* C_DOUT_WIDTH = "32" *) 
  (* C_ENABLE_RLOCS = "0" *) 
  (* C_ENABLE_RST_SYNC = "1" *) 
  (* C_EN_SAFETY_CKT = "1" *) 
  (* C_ERROR_INJECTION_TYPE = "0" *) 
  (* C_ERROR_INJECTION_TYPE_AXIS = "0" *) 
  (* C_ERROR_INJECTION_TYPE_RACH = "0" *) 
  (* C_ERROR_INJECTION_TYPE_RDCH = "0" *) 
  (* C_ERROR_INJECTION_TYPE_WACH = "0" *) 
  (* C_ERROR_INJECTION_TYPE_WDCH = "0" *) 
  (* C_ERROR_INJECTION_TYPE_WRCH = "0" *) 
  (* C_FAMILY = "kintex7" *) 
  (* C_FULL_FLAGS_RST_VAL = "0" *) 
  (* C_HAS_ALMOST_EMPTY = "1" *) 
  (* C_HAS_ALMOST_FULL = "1" *) 
  (* C_HAS_AXIS_TDATA = "1" *) 
  (* C_HAS_AXIS_TDEST = "0" *) 
  (* C_HAS_AXIS_TID = "0" *) 
  (* C_HAS_AXIS_TKEEP = "0" *) 
  (* C_HAS_AXIS_TLAST = "0" *) 
  (* C_HAS_AXIS_TREADY = "1" *) 
  (* C_HAS_AXIS_TSTRB = "0" *) 
  (* C_HAS_AXIS_TUSER = "1" *) 
  (* C_HAS_AXI_ARUSER = "0" *) 
  (* C_HAS_AXI_AWUSER = "0" *) 
  (* C_HAS_AXI_BUSER = "0" *) 
  (* C_HAS_AXI_ID = "0" *) 
  (* C_HAS_AXI_RD_CHANNEL = "1" *) 
  (* C_HAS_AXI_RUSER = "0" *) 
  (* C_HAS_AXI_WR_CHANNEL = "1" *) 
  (* C_HAS_AXI_WUSER = "0" *) 
  (* C_HAS_BACKUP = "0" *) 
  (* C_HAS_DATA_COUNT = "0" *) 
  (* C_HAS_DATA_COUNTS_AXIS = "0" *) 
  (* C_HAS_DATA_COUNTS_RACH = "0" *) 
  (* C_HAS_DATA_COUNTS_RDCH = "0" *) 
  (* C_HAS_DATA_COUNTS_WACH = "0" *) 
  (* C_HAS_DATA_COUNTS_WDCH = "0" *) 
  (* C_HAS_DATA_COUNTS_WRCH = "0" *) 
  (* C_HAS_INT_CLK = "0" *) 
  (* C_HAS_MASTER_CE = "0" *) 
  (* C_HAS_MEMINIT_FILE = "0" *) 
  (* C_HAS_OVERFLOW = "0" *) 
  (* C_HAS_PROG_FLAGS_AXIS = "0" *) 
  (* C_HAS_PROG_FLAGS_RACH = "0" *) 
  (* C_HAS_PROG_FLAGS_RDCH = "0" *) 
  (* C_HAS_PROG_FLAGS_WACH = "0" *) 
  (* C_HAS_PROG_FLAGS_WDCH = "0" *) 
  (* C_HAS_PROG_FLAGS_WRCH = "0" *) 
  (* C_HAS_RD_DATA_COUNT = "0" *) 
  (* C_HAS_RD_RST = "0" *) 
  (* C_HAS_RST = "1" *) 
  (* C_HAS_SLAVE_CE = "0" *) 
  (* C_HAS_SRST = "0" *) 
  (* C_HAS_UNDERFLOW = "0" *) 
  (* C_HAS_VALID = "0" *) 
  (* C_HAS_WR_ACK = "0" *) 
  (* C_HAS_WR_DATA_COUNT = "0" *) 
  (* C_HAS_WR_RST = "0" *) 
  (* C_IMPLEMENTATION_TYPE = "2" *) 
  (* C_IMPLEMENTATION_TYPE_AXIS = "1" *) 
  (* C_IMPLEMENTATION_TYPE_RACH = "1" *) 
  (* C_IMPLEMENTATION_TYPE_RDCH = "1" *) 
  (* C_IMPLEMENTATION_TYPE_WACH = "1" *) 
  (* C_IMPLEMENTATION_TYPE_WDCH = "1" *) 
  (* C_IMPLEMENTATION_TYPE_WRCH = "1" *) 
  (* C_INIT_WR_PNTR_VAL = "0" *) 
  (* C_INTERFACE_TYPE = "0" *) 
  (* C_MEMORY_TYPE = "1" *) 
  (* C_MIF_FILE_NAME = "BlankString" *) 
  (* C_MSGON_VAL = "1" *) 
  (* C_OPTIMIZATION_MODE = "0" *) 
  (* C_OVERFLOW_LOW = "0" *) 
  (* C_POWER_SAVING_MODE = "0" *) 
  (* C_PRELOAD_LATENCY = "1" *) 
  (* C_PRELOAD_REGS = "0" *) 
  (* C_PRIM_FIFO_TYPE = "512x72" *) 
  (* C_PRIM_FIFO_TYPE_AXIS = "1kx18" *) 
  (* C_PRIM_FIFO_TYPE_RACH = "512x36" *) 
  (* C_PRIM_FIFO_TYPE_RDCH = "1kx36" *) 
  (* C_PRIM_FIFO_TYPE_WACH = "512x36" *) 
  (* C_PRIM_FIFO_TYPE_WDCH = "1kx36" *) 
  (* C_PRIM_FIFO_TYPE_WRCH = "512x36" *) 
  (* C_PROG_EMPTY_THRESH_ASSERT_VAL = "7" *) 
  (* C_PROG_EMPTY_THRESH_ASSERT_VAL_AXIS = "1022" *) 
  (* C_PROG_EMPTY_THRESH_ASSERT_VAL_RACH = "1022" *) 
  (* C_PROG_EMPTY_THRESH_ASSERT_VAL_RDCH = "1022" *) 
  (* C_PROG_EMPTY_THRESH_ASSERT_VAL_WACH = "1022" *) 
  (* C_PROG_EMPTY_THRESH_ASSERT_VAL_WDCH = "1022" *) 
  (* C_PROG_EMPTY_THRESH_ASSERT_VAL_WRCH = "1022" *) 
  (* C_PROG_EMPTY_THRESH_NEGATE_VAL = "8" *) 
  (* C_PROG_EMPTY_TYPE = "1" *) 
  (* C_PROG_EMPTY_TYPE_AXIS = "0" *) 
  (* C_PROG_EMPTY_TYPE_RACH = "0" *) 
  (* C_PROG_EMPTY_TYPE_RDCH = "0" *) 
  (* C_PROG_EMPTY_TYPE_WACH = "0" *) 
  (* C_PROG_EMPTY_TYPE_WDCH = "0" *) 
  (* C_PROG_EMPTY_TYPE_WRCH = "0" *) 
  (* C_PROG_FULL_THRESH_ASSERT_VAL = "29" *) 
  (* C_PROG_FULL_THRESH_ASSERT_VAL_AXIS = "1023" *) 
  (* C_PROG_FULL_THRESH_ASSERT_VAL_RACH = "1023" *) 
  (* C_PROG_FULL_THRESH_ASSERT_VAL_RDCH = "1023" *) 
  (* C_PROG_FULL_THRESH_ASSERT_VAL_WACH = "1023" *) 
  (* C_PROG_FULL_THRESH_ASSERT_VAL_WDCH = "1023" *) 
  (* C_PROG_FULL_THRESH_ASSERT_VAL_WRCH = "1023" *) 
  (* C_PROG_FULL_THRESH_NEGATE_VAL = "28" *) 
  (* C_PROG_FULL_TYPE = "1" *) 
  (* C_PROG_FULL_TYPE_AXIS = "0" *) 
  (* C_PROG_FULL_TYPE_RACH = "0" *) 
  (* C_PROG_FULL_TYPE_RDCH = "0" *) 
  (* C_PROG_FULL_TYPE_WACH = "0" *) 
  (* C_PROG_FULL_TYPE_WDCH = "0" *) 
  (* C_PROG_FULL_TYPE_WRCH = "0" *) 
  (* C_RACH_TYPE = "0" *) 
  (* C_RDCH_TYPE = "0" *) 
  (* C_RD_DATA_COUNT_WIDTH = "8" *) 
  (* C_RD_DEPTH = "256" *) 
  (* C_RD_FREQ = "1" *) 
  (* C_RD_PNTR_WIDTH = "8" *) 
  (* C_REG_SLICE_MODE_AXIS = "0" *) 
  (* C_REG_SLICE_MODE_RACH = "0" *) 
  (* C_REG_SLICE_MODE_RDCH = "0" *) 
  (* C_REG_SLICE_MODE_WACH = "0" *) 
  (* C_REG_SLICE_MODE_WDCH = "0" *) 
  (* C_REG_SLICE_MODE_WRCH = "0" *) 
  (* C_SELECT_XPM = "0" *) 
  (* C_SYNCHRONIZER_STAGE = "2" *) 
  (* C_UNDERFLOW_LOW = "0" *) 
  (* C_USE_COMMON_OVERFLOW = "0" *) 
  (* C_USE_COMMON_UNDERFLOW = "0" *) 
  (* C_USE_DEFAULT_SETTINGS = "0" *) 
  (* C_USE_DOUT_RST = "1" *) 
  (* C_USE_ECC = "0" *) 
  (* C_USE_ECC_AXIS = "0" *) 
  (* C_USE_ECC_RACH = "0" *) 
  (* C_USE_ECC_RDCH = "0" *) 
  (* C_USE_ECC_WACH = "0" *) 
  (* C_USE_ECC_WDCH = "0" *) 
  (* C_USE_ECC_WRCH = "0" *) 
  (* C_USE_EMBEDDED_REG = "0" *) 
  (* C_USE_FIFO16_FLAGS = "0" *) 
  (* C_USE_FWFT_DATA_COUNT = "0" *) 
  (* C_USE_PIPELINE_REG = "0" *) 
  (* C_VALID_LOW = "0" *) 
  (* C_WACH_TYPE = "0" *) 
  (* C_WDCH_TYPE = "0" *) 
  (* C_WRCH_TYPE = "0" *) 
  (* C_WR_ACK_LOW = "0" *) 
  (* C_WR_DATA_COUNT_WIDTH = "5" *) 
  (* C_WR_DEPTH = "32" *) 
  (* C_WR_DEPTH_AXIS = "1024" *) 
  (* C_WR_DEPTH_RACH = "16" *) 
  (* C_WR_DEPTH_RDCH = "1024" *) 
  (* C_WR_DEPTH_WACH = "16" *) 
  (* C_WR_DEPTH_WDCH = "1024" *) 
  (* C_WR_DEPTH_WRCH = "16" *) 
  (* C_WR_FREQ = "1" *) 
  (* C_WR_PNTR_WIDTH = "5" *) 
  (* C_WR_PNTR_WIDTH_AXIS = "10" *) 
  (* C_WR_PNTR_WIDTH_RACH = "4" *) 
  (* C_WR_PNTR_WIDTH_RDCH = "10" *) 
  (* C_WR_PNTR_WIDTH_WACH = "4" *) 
  (* C_WR_PNTR_WIDTH_WDCH = "10" *) 
  (* C_WR_PNTR_WIDTH_WRCH = "4" *) 
  (* C_WR_RESPONSE_LATENCY = "1" *) 
  fifo_generator_0_fifo_generator_v13_2_1 U0
       (.almost_empty(almost_empty),
        .almost_full(almost_full),
        .axi_ar_data_count(NLW_U0_axi_ar_data_count_UNCONNECTED[4:0]),
        .axi_ar_dbiterr(NLW_U0_axi_ar_dbiterr_UNCONNECTED),
        .axi_ar_injectdbiterr(1'b0),
        .axi_ar_injectsbiterr(1'b0),
        .axi_ar_overflow(NLW_U0_axi_ar_overflow_UNCONNECTED),
        .axi_ar_prog_empty(NLW_U0_axi_ar_prog_empty_UNCONNECTED),
        .axi_ar_prog_empty_thresh({1'b0,1'b0,1'b0,1'b0}),
        .axi_ar_prog_full(NLW_U0_axi_ar_prog_full_UNCONNECTED),
        .axi_ar_prog_full_thresh({1'b0,1'b0,1'b0,1'b0}),
        .axi_ar_rd_data_count(NLW_U0_axi_ar_rd_data_count_UNCONNECTED[4:0]),
        .axi_ar_sbiterr(NLW_U0_axi_ar_sbiterr_UNCONNECTED),
        .axi_ar_underflow(NLW_U0_axi_ar_underflow_UNCONNECTED),
        .axi_ar_wr_data_count(NLW_U0_axi_ar_wr_data_count_UNCONNECTED[4:0]),
        .axi_aw_data_count(NLW_U0_axi_aw_data_count_UNCONNECTED[4:0]),
        .axi_aw_dbiterr(NLW_U0_axi_aw_dbiterr_UNCONNECTED),
        .axi_aw_injectdbiterr(1'b0),
        .axi_aw_injectsbiterr(1'b0),
        .axi_aw_overflow(NLW_U0_axi_aw_overflow_UNCONNECTED),
        .axi_aw_prog_empty(NLW_U0_axi_aw_prog_empty_UNCONNECTED),
        .axi_aw_prog_empty_thresh({1'b0,1'b0,1'b0,1'b0}),
        .axi_aw_prog_full(NLW_U0_axi_aw_prog_full_UNCONNECTED),
        .axi_aw_prog_full_thresh({1'b0,1'b0,1'b0,1'b0}),
        .axi_aw_rd_data_count(NLW_U0_axi_aw_rd_data_count_UNCONNECTED[4:0]),
        .axi_aw_sbiterr(NLW_U0_axi_aw_sbiterr_UNCONNECTED),
        .axi_aw_underflow(NLW_U0_axi_aw_underflow_UNCONNECTED),
        .axi_aw_wr_data_count(NLW_U0_axi_aw_wr_data_count_UNCONNECTED[4:0]),
        .axi_b_data_count(NLW_U0_axi_b_data_count_UNCONNECTED[4:0]),
        .axi_b_dbiterr(NLW_U0_axi_b_dbiterr_UNCONNECTED),
        .axi_b_injectdbiterr(1'b0),
        .axi_b_injectsbiterr(1'b0),
        .axi_b_overflow(NLW_U0_axi_b_overflow_UNCONNECTED),
        .axi_b_prog_empty(NLW_U0_axi_b_prog_empty_UNCONNECTED),
        .axi_b_prog_empty_thresh({1'b0,1'b0,1'b0,1'b0}),
        .axi_b_prog_full(NLW_U0_axi_b_prog_full_UNCONNECTED),
        .axi_b_prog_full_thresh({1'b0,1'b0,1'b0,1'b0}),
        .axi_b_rd_data_count(NLW_U0_axi_b_rd_data_count_UNCONNECTED[4:0]),
        .axi_b_sbiterr(NLW_U0_axi_b_sbiterr_UNCONNECTED),
        .axi_b_underflow(NLW_U0_axi_b_underflow_UNCONNECTED),
        .axi_b_wr_data_count(NLW_U0_axi_b_wr_data_count_UNCONNECTED[4:0]),
        .axi_r_data_count(NLW_U0_axi_r_data_count_UNCONNECTED[10:0]),
        .axi_r_dbiterr(NLW_U0_axi_r_dbiterr_UNCONNECTED),
        .axi_r_injectdbiterr(1'b0),
        .axi_r_injectsbiterr(1'b0),
        .axi_r_overflow(NLW_U0_axi_r_overflow_UNCONNECTED),
        .axi_r_prog_empty(NLW_U0_axi_r_prog_empty_UNCONNECTED),
        .axi_r_prog_empty_thresh({1'b0,1'b0,1'b0,1'b0,1'b0,1'b0,1'b0,1'b0,1'b0,1'b0}),
        .axi_r_prog_full(NLW_U0_axi_r_prog_full_UNCONNECTED),
        .axi_r_prog_full_thresh({1'b0,1'b0,1'b0,1'b0,1'b0,1'b0,1'b0,1'b0,1'b0,1'b0}),
        .axi_r_rd_data_count(NLW_U0_axi_r_rd_data_count_UNCONNECTED[10:0]),
        .axi_r_sbiterr(NLW_U0_axi_r_sbiterr_UNCONNECTED),
        .axi_r_underflow(NLW_U0_axi_r_underflow_UNCONNECTED),
        .axi_r_wr_data_count(NLW_U0_axi_r_wr_data_count_UNCONNECTED[10:0]),
        .axi_w_data_count(NLW_U0_axi_w_data_count_UNCONNECTED[10:0]),
        .axi_w_dbiterr(NLW_U0_axi_w_dbiterr_UNCONNECTED),
        .axi_w_injectdbiterr(1'b0),
        .axi_w_injectsbiterr(1'b0),
        .axi_w_overflow(NLW_U0_axi_w_overflow_UNCONNECTED),
        .axi_w_prog_empty(NLW_U0_axi_w_prog_empty_UNCONNECTED),
        .axi_w_prog_empty_thresh({1'b0,1'b0,1'b0,1'b0,1'b0,1'b0,1'b0,1'b0,1'b0,1'b0}),
        .axi_w_prog_full(NLW_U0_axi_w_prog_full_UNCONNECTED),
        .axi_w_prog_full_thresh({1'b0,1'b0,1'b0,1'b0,1'b0,1'b0,1'b0,1'b0,1'b0,1'b0}),
        .axi_w_rd_data_count(NLW_U0_axi_w_rd_data_count_UNCONNECTED[10:0]),
        .axi_w_sbiterr(NLW_U0_axi_w_sbiterr_UNCONNECTED),
        .axi_w_underflow(NLW_U0_axi_w_underflow_UNCONNECTED),
        .axi_w_wr_data_count(NLW_U0_axi_w_wr_data_count_UNCONNECTED[10:0]),
        .axis_data_count(NLW_U0_axis_data_count_UNCONNECTED[10:0]),
        .axis_dbiterr(NLW_U0_axis_dbiterr_UNCONNECTED),
        .axis_injectdbiterr(1'b0),
        .axis_injectsbiterr(1'b0),
        .axis_overflow(NLW_U0_axis_overflow_UNCONNECTED),
        .axis_prog_empty(NLW_U0_axis_prog_empty_UNCONNECTED),
        .axis_prog_empty_thresh({1'b0,1'b0,1'b0,1'b0,1'b0,1'b0,1'b0,1'b0,1'b0,1'b0}),
        .axis_prog_full(NLW_U0_axis_prog_full_UNCONNECTED),
        .axis_prog_full_thresh({1'b0,1'b0,1'b0,1'b0,1'b0,1'b0,1'b0,1'b0,1'b0,1'b0}),
        .axis_rd_data_count(NLW_U0_axis_rd_data_count_UNCONNECTED[10:0]),
        .axis_sbiterr(NLW_U0_axis_sbiterr_UNCONNECTED),
        .axis_underflow(NLW_U0_axis_underflow_UNCONNECTED),
        .axis_wr_data_count(NLW_U0_axis_wr_data_count_UNCONNECTED[10:0]),
        .backup(1'b0),
        .backup_marker(1'b0),
        .clk(1'b0),
        .data_count(NLW_U0_data_count_UNCONNECTED[4:0]),
        .dbiterr(NLW_U0_dbiterr_UNCONNECTED),
        .din(din),
        .dout(dout),
        .empty(empty),
        .full(full),
        .injectdbiterr(1'b0),
        .injectsbiterr(1'b0),
        .int_clk(1'b0),
        .m_aclk(1'b0),
        .m_aclk_en(1'b0),
        .m_axi_araddr(NLW_U0_m_axi_araddr_UNCONNECTED[31:0]),
        .m_axi_arburst(NLW_U0_m_axi_arburst_UNCONNECTED[1:0]),
        .m_axi_arcache(NLW_U0_m_axi_arcache_UNCONNECTED[3:0]),
        .m_axi_arid(NLW_U0_m_axi_arid_UNCONNECTED[0]),
        .m_axi_arlen(NLW_U0_m_axi_arlen_UNCONNECTED[7:0]),
        .m_axi_arlock(NLW_U0_m_axi_arlock_UNCONNECTED[0]),
        .m_axi_arprot(NLW_U0_m_axi_arprot_UNCONNECTED[2:0]),
        .m_axi_arqos(NLW_U0_m_axi_arqos_UNCONNECTED[3:0]),
        .m_axi_arready(1'b0),
        .m_axi_arregion(NLW_U0_m_axi_arregion_UNCONNECTED[3:0]),
        .m_axi_arsize(NLW_U0_m_axi_arsize_UNCONNECTED[2:0]),
        .m_axi_aruser(NLW_U0_m_axi_aruser_UNCONNECTED[0]),
        .m_axi_arvalid(NLW_U0_m_axi_arvalid_UNCONNECTED),
        .m_axi_awaddr(NLW_U0_m_axi_awaddr_UNCONNECTED[31:0]),
        .m_axi_awburst(NLW_U0_m_axi_awburst_UNCONNECTED[1:0]),
        .m_axi_awcache(NLW_U0_m_axi_awcache_UNCONNECTED[3:0]),
        .m_axi_awid(NLW_U0_m_axi_awid_UNCONNECTED[0]),
        .m_axi_awlen(NLW_U0_m_axi_awlen_UNCONNECTED[7:0]),
        .m_axi_awlock(NLW_U0_m_axi_awlock_UNCONNECTED[0]),
        .m_axi_awprot(NLW_U0_m_axi_awprot_UNCONNECTED[2:0]),
        .m_axi_awqos(NLW_U0_m_axi_awqos_UNCONNECTED[3:0]),
        .m_axi_awready(1'b0),
        .m_axi_awregion(NLW_U0_m_axi_awregion_UNCONNECTED[3:0]),
        .m_axi_awsize(NLW_U0_m_axi_awsize_UNCONNECTED[2:0]),
        .m_axi_awuser(NLW_U0_m_axi_awuser_UNCONNECTED[0]),
        .m_axi_awvalid(NLW_U0_m_axi_awvalid_UNCONNECTED),
        .m_axi_bid(1'b0),
        .m_axi_bready(NLW_U0_m_axi_bready_UNCONNECTED),
        .m_axi_bresp({1'b0,1'b0}),
        .m_axi_buser(1'b0),
        .m_axi_bvalid(1'b0),
        .m_axi_rdata({1'b0,1'b0,1'b0,1'b0,1'b0,1'b0,1'b0,1'b0,1'b0,1'b0,1'b0,1'b0,1'b0,1'b0,1'b0,1'b0,1'b0,1'b0,1'b0,1'b0,1'b0,1'b0,1'b0,1'b0,1'b0,1'b0,1'b0,1'b0,1'b0,1'b0,1'b0,1'b0,1'b0,1'b0,1'b0,1'b0,1'b0,1'b0,1'b0,1'b0,1'b0,1'b0,1'b0,1'b0,1'b0,1'b0,1'b0,1'b0,1'b0,1'b0,1'b0,1'b0,1'b0,1'b0,1'b0,1'b0,1'b0,1'b0,1'b0,1'b0,1'b0,1'b0,1'b0,1'b0}),
        .m_axi_rid(1'b0),
        .m_axi_rlast(1'b0),
        .m_axi_rready(NLW_U0_m_axi_rready_UNCONNECTED),
        .m_axi_rresp({1'b0,1'b0}),
        .m_axi_ruser(1'b0),
        .m_axi_rvalid(1'b0),
        .m_axi_wdata(NLW_U0_m_axi_wdata_UNCONNECTED[63:0]),
        .m_axi_wid(NLW_U0_m_axi_wid_UNCONNECTED[0]),
        .m_axi_wlast(NLW_U0_m_axi_wlast_UNCONNECTED),
        .m_axi_wready(1'b0),
        .m_axi_wstrb(NLW_U0_m_axi_wstrb_UNCONNECTED[7:0]),
        .m_axi_wuser(NLW_U0_m_axi_wuser_UNCONNECTED[0]),
        .m_axi_wvalid(NLW_U0_m_axi_wvalid_UNCONNECTED),
        .m_axis_tdata(NLW_U0_m_axis_tdata_UNCONNECTED[7:0]),
        .m_axis_tdest(NLW_U0_m_axis_tdest_UNCONNECTED[0]),
        .m_axis_tid(NLW_U0_m_axis_tid_UNCONNECTED[0]),
        .m_axis_tkeep(NLW_U0_m_axis_tkeep_UNCONNECTED[0]),
        .m_axis_tlast(NLW_U0_m_axis_tlast_UNCONNECTED),
        .m_axis_tready(1'b0),
        .m_axis_tstrb(NLW_U0_m_axis_tstrb_UNCONNECTED[0]),
        .m_axis_tuser(NLW_U0_m_axis_tuser_UNCONNECTED[3:0]),
        .m_axis_tvalid(NLW_U0_m_axis_tvalid_UNCONNECTED),
        .overflow(NLW_U0_overflow_UNCONNECTED),
        .prog_empty(prog_empty),
        .prog_empty_thresh({1'b0,1'b0,1'b0,1'b0,1'b0,1'b0,1'b0,1'b0}),
        .prog_empty_thresh_assert({1'b0,1'b0,1'b0,1'b0,1'b0,1'b0,1'b0,1'b0}),
        .prog_empty_thresh_negate({1'b0,1'b0,1'b0,1'b0,1'b0,1'b0,1'b0,1'b0}),
        .prog_full(prog_full),
        .prog_full_thresh({1'b0,1'b0,1'b0,1'b0,1'b0}),
        .prog_full_thresh_assert({1'b0,1'b0,1'b0,1'b0,1'b0}),
        .prog_full_thresh_negate({1'b0,1'b0,1'b0,1'b0,1'b0}),
        .rd_clk(rd_clk),
        .rd_data_count(NLW_U0_rd_data_count_UNCONNECTED[7:0]),
        .rd_en(rd_en),
        .rd_rst(1'b0),
        .rd_rst_busy(rd_rst_busy),
        .rst(rst),
        .s_aclk(1'b0),
        .s_aclk_en(1'b0),
        .s_aresetn(1'b0),
        .s_axi_araddr({1'b0,1'b0,1'b0,1'b0,1'b0,1'b0,1'b0,1'b0,1'b0,1'b0,1'b0,1'b0,1'b0,1'b0,1'b0,1'b0,1'b0,1'b0,1'b0,1'b0,1'b0,1'b0,1'b0,1'b0,1'b0,1'b0,1'b0,1'b0,1'b0,1'b0,1'b0,1'b0}),
        .s_axi_arburst({1'b0,1'b0}),
        .s_axi_arcache({1'b0,1'b0,1'b0,1'b0}),
        .s_axi_arid(1'b0),
        .s_axi_arlen({1'b0,1'b0,1'b0,1'b0,1'b0,1'b0,1'b0,1'b0}),
        .s_axi_arlock(1'b0),
        .s_axi_arprot({1'b0,1'b0,1'b0}),
        .s_axi_arqos({1'b0,1'b0,1'b0,1'b0}),
        .s_axi_arready(NLW_U0_s_axi_arready_UNCONNECTED),
        .s_axi_arregion({1'b0,1'b0,1'b0,1'b0}),
        .s_axi_arsize({1'b0,1'b0,1'b0}),
        .s_axi_aruser(1'b0),
        .s_axi_arvalid(1'b0),
        .s_axi_awaddr({1'b0,1'b0,1'b0,1'b0,1'b0,1'b0,1'b0,1'b0,1'b0,1'b0,1'b0,1'b0,1'b0,1'b0,1'b0,1'b0,1'b0,1'b0,1'b0,1'b0,1'b0,1'b0,1'b0,1'b0,1'b0,1'b0,1'b0,1'b0,1'b0,1'b0,1'b0,1'b0}),
        .s_axi_awburst({1'b0,1'b0}),
        .s_axi_awcache({1'b0,1'b0,1'b0,1'b0}),
        .s_axi_awid(1'b0),
        .s_axi_awlen({1'b0,1'b0,1'b0,1'b0,1'b0,1'b0,1'b0,1'b0}),
        .s_axi_awlock(1'b0),
        .s_axi_awprot({1'b0,1'b0,1'b0}),
        .s_axi_awqos({1'b0,1'b0,1'b0,1'b0}),
        .s_axi_awready(NLW_U0_s_axi_awready_UNCONNECTED),
        .s_axi_awregion({1'b0,1'b0,1'b0,1'b0}),
        .s_axi_awsize({1'b0,1'b0,1'b0}),
        .s_axi_awuser(1'b0),
        .s_axi_awvalid(1'b0),
        .s_axi_bid(NLW_U0_s_axi_bid_UNCONNECTED[0]),
        .s_axi_bready(1'b0),
        .s_axi_bresp(NLW_U0_s_axi_bresp_UNCONNECTED[1:0]),
        .s_axi_buser(NLW_U0_s_axi_buser_UNCONNECTED[0]),
        .s_axi_bvalid(NLW_U0_s_axi_bvalid_UNCONNECTED),
        .s_axi_rdata(NLW_U0_s_axi_rdata_UNCONNECTED[63:0]),
        .s_axi_rid(NLW_U0_s_axi_rid_UNCONNECTED[0]),
        .s_axi_rlast(NLW_U0_s_axi_rlast_UNCONNECTED),
        .s_axi_rready(1'b0),
        .s_axi_rresp(NLW_U0_s_axi_rresp_UNCONNECTED[1:0]),
        .s_axi_ruser(NLW_U0_s_axi_ruser_UNCONNECTED[0]),
        .s_axi_rvalid(NLW_U0_s_axi_rvalid_UNCONNECTED),
        .s_axi_wdata({1'b0,1'b0,1'b0,1'b0,1'b0,1'b0,1'b0,1'b0,1'b0,1'b0,1'b0,1'b0,1'b0,1'b0,1'b0,1'b0,1'b0,1'b0,1'b0,1'b0,1'b0,1'b0,1'b0,1'b0,1'b0,1'b0,1'b0,1'b0,1'b0,1'b0,1'b0,1'b0,1'b0,1'b0,1'b0,1'b0,1'b0,1'b0,1'b0,1'b0,1'b0,1'b0,1'b0,1'b0,1'b0,1'b0,1'b0,1'b0,1'b0,1'b0,1'b0,1'b0,1'b0,1'b0,1'b0,1'b0,1'b0,1'b0,1'b0,1'b0,1'b0,1'b0,1'b0,1'b0}),
        .s_axi_wid(1'b0),
        .s_axi_wlast(1'b0),
        .s_axi_wready(NLW_U0_s_axi_wready_UNCONNECTED),
        .s_axi_wstrb({1'b0,1'b0,1'b0,1'b0,1'b0,1'b0,1'b0,1'b0}),
        .s_axi_wuser(1'b0),
        .s_axi_wvalid(1'b0),
        .s_axis_tdata({1'b0,1'b0,1'b0,1'b0,1'b0,1'b0,1'b0,1'b0}),
        .s_axis_tdest(1'b0),
        .s_axis_tid(1'b0),
        .s_axis_tkeep(1'b0),
        .s_axis_tlast(1'b0),
        .s_axis_tready(NLW_U0_s_axis_tready_UNCONNECTED),
        .s_axis_tstrb(1'b0),
        .s_axis_tuser({1'b0,1'b0,1'b0,1'b0}),
        .s_axis_tvalid(1'b0),
        .sbiterr(NLW_U0_sbiterr_UNCONNECTED),
        .sleep(1'b0),
        .srst(1'b0),
        .underflow(NLW_U0_underflow_UNCONNECTED),
        .valid(NLW_U0_valid_UNCONNECTED),
        .wr_ack(NLW_U0_wr_ack_UNCONNECTED),
        .wr_clk(wr_clk),
        .wr_data_count(NLW_U0_wr_data_count_UNCONNECTED[4:0]),
        .wr_en(wr_en),
        .wr_rst(1'b0),
        .wr_rst_busy(wr_rst_busy));
endmodule

(* DEST_SYNC_FF = "2" *) (* INIT_SYNC_FF = "0" *) (* ORIG_REF_NAME = "xpm_cdc_gray" *) 
(* REG_OUTPUT = "1" *) (* SIM_ASSERT_CHK = "0" *) (* SIM_LOSSLESS_GRAY_CHK = "0" *) 
(* VERSION = "0" *) (* WIDTH = "5" *) (* XPM_MODULE = "TRUE" *) 
(* xpm_cdc = "GRAY" *) 
module fifo_generator_0_xpm_cdc_gray
   (src_clk,
    src_in_bin,
    dest_clk,
    dest_out_bin);
  input src_clk;
  input [4:0]src_in_bin;
  input dest_clk;
  output [4:0]dest_out_bin;

  wire [4:0]async_path;
  wire [3:0]binval;
  wire dest_clk;
  (* RTL_KEEP = "true" *) (* async_reg = "true" *) (* xpm_cdc = "GRAY" *) wire [4:0]\dest_graysync_ff[0] ;
  (* RTL_KEEP = "true" *) (* async_reg = "true" *) (* xpm_cdc = "GRAY" *) wire [4:0]\dest_graysync_ff[1] ;
  wire [4:0]dest_out_bin;
  wire [3:0]gray_enc;
  wire src_clk;
  wire [4:0]src_in_bin;

  (* ASYNC_REG *) 
  (* XPM_CDC = "GRAY" *) 
  FDRE \dest_graysync_ff_reg[0][0] 
       (.C(dest_clk),
        .CE(1'b1),
        .D(async_path[0]),
        .Q(\dest_graysync_ff[0] [0]),
        .R(1'b0));
  (* ASYNC_REG *) 
  (* XPM_CDC = "GRAY" *) 
  FDRE \dest_graysync_ff_reg[0][1] 
       (.C(dest_clk),
        .CE(1'b1),
        .D(async_path[1]),
        .Q(\dest_graysync_ff[0] [1]),
        .R(1'b0));
  (* ASYNC_REG *) 
  (* XPM_CDC = "GRAY" *) 
  FDRE \dest_graysync_ff_reg[0][2] 
       (.C(dest_clk),
        .CE(1'b1),
        .D(async_path[2]),
        .Q(\dest_graysync_ff[0] [2]),
        .R(1'b0));
  (* ASYNC_REG *) 
  (* XPM_CDC = "GRAY" *) 
  FDRE \dest_graysync_ff_reg[0][3] 
       (.C(dest_clk),
        .CE(1'b1),
        .D(async_path[3]),
        .Q(\dest_graysync_ff[0] [3]),
        .R(1'b0));
  (* ASYNC_REG *) 
  (* XPM_CDC = "GRAY" *) 
  FDRE \dest_graysync_ff_reg[0][4] 
       (.C(dest_clk),
        .CE(1'b1),
        .D(async_path[4]),
        .Q(\dest_graysync_ff[0] [4]),
        .R(1'b0));
  (* ASYNC_REG *) 
  (* XPM_CDC = "GRAY" *) 
  FDRE \dest_graysync_ff_reg[1][0] 
       (.C(dest_clk),
        .CE(1'b1),
        .D(\dest_graysync_ff[0] [0]),
        .Q(\dest_graysync_ff[1] [0]),
        .R(1'b0));
  (* ASYNC_REG *) 
  (* XPM_CDC = "GRAY" *) 
  FDRE \dest_graysync_ff_reg[1][1] 
       (.C(dest_clk),
        .CE(1'b1),
        .D(\dest_graysync_ff[0] [1]),
        .Q(\dest_graysync_ff[1] [1]),
        .R(1'b0));
  (* ASYNC_REG *) 
  (* XPM_CDC = "GRAY" *) 
  FDRE \dest_graysync_ff_reg[1][2] 
       (.C(dest_clk),
        .CE(1'b1),
        .D(\dest_graysync_ff[0] [2]),
        .Q(\dest_graysync_ff[1] [2]),
        .R(1'b0));
  (* ASYNC_REG *) 
  (* XPM_CDC = "GRAY" *) 
  FDRE \dest_graysync_ff_reg[1][3] 
       (.C(dest_clk),
        .CE(1'b1),
        .D(\dest_graysync_ff[0] [3]),
        .Q(\dest_graysync_ff[1] [3]),
        .R(1'b0));
  (* ASYNC_REG *) 
  (* XPM_CDC = "GRAY" *) 
  FDRE \dest_graysync_ff_reg[1][4] 
       (.C(dest_clk),
        .CE(1'b1),
        .D(\dest_graysync_ff[0] [4]),
        .Q(\dest_graysync_ff[1] [4]),
        .R(1'b0));
  LUT5 #(
    .INIT(32'h96696996)) 
    \dest_out_bin_ff[0]_i_1 
       (.I0(\dest_graysync_ff[1] [4]),
        .I1(\dest_graysync_ff[1] [1]),
        .I2(\dest_graysync_ff[1] [0]),
        .I3(\dest_graysync_ff[1] [3]),
        .I4(\dest_graysync_ff[1] [2]),
        .O(binval[0]));
  LUT4 #(
    .INIT(16'h6996)) 
    \dest_out_bin_ff[1]_i_1 
       (.I0(\dest_graysync_ff[1] [3]),
        .I1(\dest_graysync_ff[1] [4]),
        .I2(\dest_graysync_ff[1] [1]),
        .I3(\dest_graysync_ff[1] [2]),
        .O(binval[1]));
  LUT3 #(
    .INIT(8'h96)) 
    \dest_out_bin_ff[2]_i_1 
       (.I0(\dest_graysync_ff[1] [4]),
        .I1(\dest_graysync_ff[1] [2]),
        .I2(\dest_graysync_ff[1] [3]),
        .O(binval[2]));
  LUT2 #(
    .INIT(4'h6)) 
    \dest_out_bin_ff[3]_i_1 
       (.I0(\dest_graysync_ff[1] [4]),
        .I1(\dest_graysync_ff[1] [3]),
        .O(binval[3]));
  FDRE \dest_out_bin_ff_reg[0] 
       (.C(dest_clk),
        .CE(1'b1),
        .D(binval[0]),
        .Q(dest_out_bin[0]),
        .R(1'b0));
  FDRE \dest_out_bin_ff_reg[1] 
       (.C(dest_clk),
        .CE(1'b1),
        .D(binval[1]),
        .Q(dest_out_bin[1]),
        .R(1'b0));
  FDRE \dest_out_bin_ff_reg[2] 
       (.C(dest_clk),
        .CE(1'b1),
        .D(binval[2]),
        .Q(dest_out_bin[2]),
        .R(1'b0));
  FDRE \dest_out_bin_ff_reg[3] 
       (.C(dest_clk),
        .CE(1'b1),
        .D(binval[3]),
        .Q(dest_out_bin[3]),
        .R(1'b0));
  FDRE \dest_out_bin_ff_reg[4] 
       (.C(dest_clk),
        .CE(1'b1),
        .D(\dest_graysync_ff[1] [4]),
        .Q(dest_out_bin[4]),
        .R(1'b0));
  (* SOFT_HLUTNM = "soft_lutpair0" *) 
  LUT2 #(
    .INIT(4'h6)) 
    \src_gray_ff[0]_i_1 
       (.I0(src_in_bin[0]),
        .I1(src_in_bin[1]),
        .O(gray_enc[0]));
  (* SOFT_HLUTNM = "soft_lutpair0" *) 
  LUT2 #(
    .INIT(4'h6)) 
    \src_gray_ff[1]_i_1 
       (.I0(src_in_bin[1]),
        .I1(src_in_bin[2]),
        .O(gray_enc[1]));
  (* SOFT_HLUTNM = "soft_lutpair1" *) 
  LUT2 #(
    .INIT(4'h6)) 
    \src_gray_ff[2]_i_1 
       (.I0(src_in_bin[2]),
        .I1(src_in_bin[3]),
        .O(gray_enc[2]));
  (* SOFT_HLUTNM = "soft_lutpair1" *) 
  LUT2 #(
    .INIT(4'h6)) 
    \src_gray_ff[3]_i_1 
       (.I0(src_in_bin[3]),
        .I1(src_in_bin[4]),
        .O(gray_enc[3]));
  FDRE \src_gray_ff_reg[0] 
       (.C(src_clk),
        .CE(1'b1),
        .D(gray_enc[0]),
        .Q(async_path[0]),
        .R(1'b0));
  FDRE \src_gray_ff_reg[1] 
       (.C(src_clk),
        .CE(1'b1),
        .D(gray_enc[1]),
        .Q(async_path[1]),
        .R(1'b0));
  FDRE \src_gray_ff_reg[2] 
       (.C(src_clk),
        .CE(1'b1),
        .D(gray_enc[2]),
        .Q(async_path[2]),
        .R(1'b0));
  FDRE \src_gray_ff_reg[3] 
       (.C(src_clk),
        .CE(1'b1),
        .D(gray_enc[3]),
        .Q(async_path[3]),
        .R(1'b0));
  FDRE \src_gray_ff_reg[4] 
       (.C(src_clk),
        .CE(1'b1),
        .D(src_in_bin[4]),
        .Q(async_path[4]),
        .R(1'b0));
endmodule

(* DEST_SYNC_FF = "2" *) (* INIT_SYNC_FF = "0" *) (* ORIG_REF_NAME = "xpm_cdc_gray" *) 
(* REG_OUTPUT = "1" *) (* SIM_ASSERT_CHK = "0" *) (* SIM_LOSSLESS_GRAY_CHK = "0" *) 
(* VERSION = "0" *) (* WIDTH = "8" *) (* XPM_MODULE = "TRUE" *) 
(* xpm_cdc = "GRAY" *) 
module fifo_generator_0_xpm_cdc_gray__parameterized0
   (src_clk,
    src_in_bin,
    dest_clk,
    dest_out_bin);
  input src_clk;
  input [7:0]src_in_bin;
  input dest_clk;
  output [7:0]dest_out_bin;

  wire [7:0]async_path;
  wire [6:0]binval;
  wire dest_clk;
  (* RTL_KEEP = "true" *) (* async_reg = "true" *) (* xpm_cdc = "GRAY" *) wire [7:0]\dest_graysync_ff[0] ;
  (* RTL_KEEP = "true" *) (* async_reg = "true" *) (* xpm_cdc = "GRAY" *) wire [7:0]\dest_graysync_ff[1] ;
  wire [7:0]dest_out_bin;
  wire [6:0]gray_enc;
  wire src_clk;
  wire [7:0]src_in_bin;

  (* ASYNC_REG *) 
  (* XPM_CDC = "GRAY" *) 
  FDRE \dest_graysync_ff_reg[0][0] 
       (.C(dest_clk),
        .CE(1'b1),
        .D(async_path[0]),
        .Q(\dest_graysync_ff[0] [0]),
        .R(1'b0));
  (* ASYNC_REG *) 
  (* XPM_CDC = "GRAY" *) 
  FDRE \dest_graysync_ff_reg[0][1] 
       (.C(dest_clk),
        .CE(1'b1),
        .D(async_path[1]),
        .Q(\dest_graysync_ff[0] [1]),
        .R(1'b0));
  (* ASYNC_REG *) 
  (* XPM_CDC = "GRAY" *) 
  FDRE \dest_graysync_ff_reg[0][2] 
       (.C(dest_clk),
        .CE(1'b1),
        .D(async_path[2]),
        .Q(\dest_graysync_ff[0] [2]),
        .R(1'b0));
  (* ASYNC_REG *) 
  (* XPM_CDC = "GRAY" *) 
  FDRE \dest_graysync_ff_reg[0][3] 
       (.C(dest_clk),
        .CE(1'b1),
        .D(async_path[3]),
        .Q(\dest_graysync_ff[0] [3]),
        .R(1'b0));
  (* ASYNC_REG *) 
  (* XPM_CDC = "GRAY" *) 
  FDRE \dest_graysync_ff_reg[0][4] 
       (.C(dest_clk),
        .CE(1'b1),
        .D(async_path[4]),
        .Q(\dest_graysync_ff[0] [4]),
        .R(1'b0));
  (* ASYNC_REG *) 
  (* XPM_CDC = "GRAY" *) 
  FDRE \dest_graysync_ff_reg[0][5] 
       (.C(dest_clk),
        .CE(1'b1),
        .D(async_path[5]),
        .Q(\dest_graysync_ff[0] [5]),
        .R(1'b0));
  (* ASYNC_REG *) 
  (* XPM_CDC = "GRAY" *) 
  FDRE \dest_graysync_ff_reg[0][6] 
       (.C(dest_clk),
        .CE(1'b1),
        .D(async_path[6]),
        .Q(\dest_graysync_ff[0] [6]),
        .R(1'b0));
  (* ASYNC_REG *) 
  (* XPM_CDC = "GRAY" *) 
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
  FDRE \src_gray_ff_reg[6] 
       (.C(src_clk),
        .CE(1'b1),
        .D(gray_enc[6]),
        .Q(async_path[6]),
        .R(1'b0));
  FDRE \src_gray_ff_reg[7] 
       (.C(src_clk),
        .CE(1'b1),
        .D(src_in_bin[7]),
        .Q(async_path[7]),
        .R(1'b0));
endmodule

(* DEST_SYNC_FF = "5" *) (* INIT_SYNC_FF = "0" *) (* ORIG_REF_NAME = "xpm_cdc_single" *) 
(* SIM_ASSERT_CHK = "0" *) (* SRC_INPUT_REG = "0" *) (* VERSION = "0" *) 
(* XPM_MODULE = "TRUE" *) (* xpm_cdc = "SINGLE" *) 
module fifo_generator_0_xpm_cdc_single
   (src_clk,
    src_in,
    dest_clk,
    dest_out);
  input src_clk;
  input src_in;
  input dest_clk;
  output dest_out;

  wire dest_clk;
  wire src_in;
  (* RTL_KEEP = "true" *) (* async_reg = "true" *) (* xpm_cdc = "SINGLE" *) wire [4:0]syncstages_ff;

  assign dest_out = syncstages_ff[4];
  (* ASYNC_REG *) 
  (* XPM_CDC = "SINGLE" *) 
  FDRE \syncstages_ff_reg[0] 
       (.C(dest_clk),
        .CE(1'b1),
        .D(src_in),
        .Q(syncstages_ff[0]),
        .R(1'b0));
  (* ASYNC_REG *) 
  (* XPM_CDC = "SINGLE" *) 
  FDRE \syncstages_ff_reg[1] 
       (.C(dest_clk),
        .CE(1'b1),
        .D(syncstages_ff[0]),
        .Q(syncstages_ff[1]),
        .R(1'b0));
  (* ASYNC_REG *) 
  (* XPM_CDC = "SINGLE" *) 
  FDRE \syncstages_ff_reg[2] 
       (.C(dest_clk),
        .CE(1'b1),
        .D(syncstages_ff[1]),
        .Q(syncstages_ff[2]),
        .R(1'b0));
  (* ASYNC_REG *) 
  (* XPM_CDC = "SINGLE" *) 
  FDRE \syncstages_ff_reg[3] 
       (.C(dest_clk),
        .CE(1'b1),
        .D(syncstages_ff[2]),
        .Q(syncstages_ff[3]),
        .R(1'b0));
  (* ASYNC_REG *) 
  (* XPM_CDC = "SINGLE" *) 
  FDRE \syncstages_ff_reg[4] 
       (.C(dest_clk),
        .CE(1'b1),
        .D(syncstages_ff[3]),
        .Q(syncstages_ff[4]),
        .R(1'b0));
endmodule

(* DEST_SYNC_FF = "5" *) (* INIT_SYNC_FF = "0" *) (* ORIG_REF_NAME = "xpm_cdc_single" *) 
(* SIM_ASSERT_CHK = "0" *) (* SRC_INPUT_REG = "0" *) (* VERSION = "0" *) 
(* XPM_MODULE = "TRUE" *) (* xpm_cdc = "SINGLE" *) 
module fifo_generator_0_xpm_cdc_single__1
   (src_clk,
    src_in,
    dest_clk,
    dest_out);
  input src_clk;
  input src_in;
  input dest_clk;
  output dest_out;

  wire dest_clk;
  wire src_in;
  (* RTL_KEEP = "true" *) (* async_reg = "true" *) (* xpm_cdc = "SINGLE" *) wire [4:0]syncstages_ff;

  assign dest_out = syncstages_ff[4];
  (* ASYNC_REG *) 
  (* XPM_CDC = "SINGLE" *) 
  FDRE \syncstages_ff_reg[0] 
       (.C(dest_clk),
        .CE(1'b1),
        .D(src_in),
        .Q(syncstages_ff[0]),
        .R(1'b0));
  (* ASYNC_REG *) 
  (* XPM_CDC = "SINGLE" *) 
  FDRE \syncstages_ff_reg[1] 
       (.C(dest_clk),
        .CE(1'b1),
        .D(syncstages_ff[0]),
        .Q(syncstages_ff[1]),
        .R(1'b0));
  (* ASYNC_REG *) 
  (* XPM_CDC = "SINGLE" *) 
  FDRE \syncstages_ff_reg[2] 
       (.C(dest_clk),
        .CE(1'b1),
        .D(syncstages_ff[1]),
        .Q(syncstages_ff[2]),
        .R(1'b0));
  (* ASYNC_REG *) 
  (* XPM_CDC = "SINGLE" *) 
  FDRE \syncstages_ff_reg[3] 
       (.C(dest_clk),
        .CE(1'b1),
        .D(syncstages_ff[2]),
        .Q(syncstages_ff[3]),
        .R(1'b0));
  (* ASYNC_REG *) 
  (* XPM_CDC = "SINGLE" *) 
  FDRE \syncstages_ff_reg[4] 
       (.C(dest_clk),
        .CE(1'b1),
        .D(syncstages_ff[3]),
        .Q(syncstages_ff[4]),
        .R(1'b0));
endmodule

(* DEF_VAL = "1'b1" *) (* DEST_SYNC_FF = "5" *) (* INIT = "1" *) 
(* INIT_SYNC_FF = "0" *) (* ORIG_REF_NAME = "xpm_cdc_sync_rst" *) (* SIM_ASSERT_CHK = "0" *) 
(* VERSION = "0" *) (* XPM_MODULE = "TRUE" *) (* xpm_cdc = "SYNC_RST" *) 
module fifo_generator_0_xpm_cdc_sync_rst
   (src_rst,
    dest_clk,
    dest_rst);
  input src_rst;
  input dest_clk;
  output dest_rst;

  wire dest_clk;
  wire src_rst;
  (* RTL_KEEP = "true" *) (* async_reg = "true" *) (* xpm_cdc = "SYNC_RST" *) wire [4:0]syncstages_ff;

  assign dest_rst = syncstages_ff[4];
  (* ASYNC_REG *) 
  (* XPM_CDC = "SYNC_RST" *) 
  FDRE #(
    .INIT(1'b1)) 
    \syncstages_ff_reg[0] 
       (.C(dest_clk),
        .CE(1'b1),
        .D(src_rst),
        .Q(syncstages_ff[0]),
        .R(1'b0));
  (* ASYNC_REG *) 
  (* XPM_CDC = "SYNC_RST" *) 
  FDRE #(
    .INIT(1'b1)) 
    \syncstages_ff_reg[1] 
       (.C(dest_clk),
        .CE(1'b1),
        .D(syncstages_ff[0]),
        .Q(syncstages_ff[1]),
        .R(1'b0));
  (* ASYNC_REG *) 
  (* XPM_CDC = "SYNC_RST" *) 
  FDRE #(
    .INIT(1'b1)) 
    \syncstages_ff_reg[2] 
       (.C(dest_clk),
        .CE(1'b1),
        .D(syncstages_ff[1]),
        .Q(syncstages_ff[2]),
        .R(1'b0));
  (* ASYNC_REG *) 
  (* XPM_CDC = "SYNC_RST" *) 
  FDRE #(
    .INIT(1'b1)) 
    \syncstages_ff_reg[3] 
       (.C(dest_clk),
        .CE(1'b1),
        .D(syncstages_ff[2]),
        .Q(syncstages_ff[3]),
        .R(1'b0));
  (* ASYNC_REG *) 
  (* XPM_CDC = "SYNC_RST" *) 
  FDRE #(
    .INIT(1'b1)) 
    \syncstages_ff_reg[4] 
       (.C(dest_clk),
        .CE(1'b1),
        .D(syncstages_ff[3]),
        .Q(syncstages_ff[4]),
        .R(1'b0));
endmodule

(* DEF_VAL = "1'b1" *) (* DEST_SYNC_FF = "5" *) (* INIT = "1" *) 
(* INIT_SYNC_FF = "0" *) (* ORIG_REF_NAME = "xpm_cdc_sync_rst" *) (* SIM_ASSERT_CHK = "0" *) 
(* VERSION = "0" *) (* XPM_MODULE = "TRUE" *) (* xpm_cdc = "SYNC_RST" *) 
module fifo_generator_0_xpm_cdc_sync_rst__1
   (src_rst,
    dest_clk,
    dest_rst);
  input src_rst;
  input dest_clk;
  output dest_rst;

  wire dest_clk;
  wire src_rst;
  (* RTL_KEEP = "true" *) (* async_reg = "true" *) (* xpm_cdc = "SYNC_RST" *) wire [4:0]syncstages_ff;

  assign dest_rst = syncstages_ff[4];
  (* ASYNC_REG *) 
  (* XPM_CDC = "SYNC_RST" *) 
  FDRE #(
    .INIT(1'b1)) 
    \syncstages_ff_reg[0] 
       (.C(dest_clk),
        .CE(1'b1),
        .D(src_rst),
        .Q(syncstages_ff[0]),
        .R(1'b0));
  (* ASYNC_REG *) 
  (* XPM_CDC = "SYNC_RST" *) 
  FDRE #(
    .INIT(1'b1)) 
    \syncstages_ff_reg[1] 
       (.C(dest_clk),
        .CE(1'b1),
        .D(syncstages_ff[0]),
        .Q(syncstages_ff[1]),
        .R(1'b0));
  (* ASYNC_REG *) 
  (* XPM_CDC = "SYNC_RST" *) 
  FDRE #(
    .INIT(1'b1)) 
    \syncstages_ff_reg[2] 
       (.C(dest_clk),
        .CE(1'b1),
        .D(syncstages_ff[1]),
        .Q(syncstages_ff[2]),
        .R(1'b0));
  (* ASYNC_REG *) 
  (* XPM_CDC = "SYNC_RST" *) 
  FDRE #(
    .INIT(1'b1)) 
    \syncstages_ff_reg[3] 
       (.C(dest_clk),
        .CE(1'b1),
        .D(syncstages_ff[2]),
        .Q(syncstages_ff[3]),
        .R(1'b0));
  (* ASYNC_REG *) 
  (* XPM_CDC = "SYNC_RST" *) 
  FDRE #(
    .INIT(1'b1)) 
    \syncstages_ff_reg[4] 
       (.C(dest_clk),
        .CE(1'b1),
        .D(syncstages_ff[3]),
        .Q(syncstages_ff[4]),
        .R(1'b0));
endmodule

(* DEF_VAL = "1'b0" *) (* DEST_SYNC_FF = "3" *) (* INIT = "0" *) 
(* INIT_SYNC_FF = "0" *) (* ORIG_REF_NAME = "xpm_cdc_sync_rst" *) (* SIM_ASSERT_CHK = "0" *) 
(* VERSION = "0" *) (* XPM_MODULE = "TRUE" *) (* xpm_cdc = "SYNC_RST" *) 
module fifo_generator_0_xpm_cdc_sync_rst__parameterized0
   (src_rst,
    dest_clk,
    dest_rst);
  input src_rst;
  input dest_clk;
  output dest_rst;

  wire dest_clk;
  wire src_rst;
  (* RTL_KEEP = "true" *) (* async_reg = "true" *) (* xpm_cdc = "SYNC_RST" *) wire [2:0]syncstages_ff;

  assign dest_rst = syncstages_ff[2];
  (* ASYNC_REG *) 
  (* XPM_CDC = "SYNC_RST" *) 
  FDRE #(
    .INIT(1'b0)) 
    \syncstages_ff_reg[0] 
       (.C(dest_clk),
        .CE(1'b1),
        .D(src_rst),
        .Q(syncstages_ff[0]),
        .R(1'b0));
  (* ASYNC_REG *) 
  (* XPM_CDC = "SYNC_RST" *) 
  FDRE #(
    .INIT(1'b0)) 
    \syncstages_ff_reg[1] 
       (.C(dest_clk),
        .CE(1'b1),
        .D(syncstages_ff[0]),
        .Q(syncstages_ff[1]),
        .R(1'b0));
  (* ASYNC_REG *) 
  (* XPM_CDC = "SYNC_RST" *) 
  FDRE #(
    .INIT(1'b0)) 
    \syncstages_ff_reg[2] 
       (.C(dest_clk),
        .CE(1'b1),
        .D(syncstages_ff[1]),
        .Q(syncstages_ff[2]),
        .R(1'b0));
endmodule

(* ORIG_REF_NAME = "blk_mem_gen_generic_cstr" *) 
module fifo_generator_0_blk_mem_gen_generic_cstr
   (ENA_dly_D,
    dout,
    POR_B,
    wr_clk,
    rd_clk,
    ENA_I,
    ram_rstram_b,
    \gc1.count_d2_reg[7] ,
    \gic0.gc1.count_d3_reg[4] ,
    din,
    E,
    SS,
    rd_en,
    out);
  output ENA_dly_D;
  output [31:0]dout;
  output POR_B;
  input wr_clk;
  input rd_clk;
  input ENA_I;
  input ram_rstram_b;
  input [7:0]\gc1.count_d2_reg[7] ;
  input [4:0]\gic0.gc1.count_d3_reg[4] ;
  input [255:0]din;
  input [0:0]E;
  input [0:0]SS;
  input rd_en;
  input out;

  wire [0:0]E;
  wire ENA_I;
  wire ENA_dly_D;
  wire ENB_I;
  wire POR_B;
  wire [0:0]SS;
  wire [255:0]din;
  wire [31:0]dout;
  wire [7:0]\gc1.count_d2_reg[7] ;
  wire [4:0]\gic0.gc1.count_d3_reg[4] ;
  wire out;
  wire ram_rstram_b;
  wire rd_clk;
  wire rd_en;
  wire wr_clk;

  fifo_generator_0_blk_mem_gen_prim_width \ramloop[0].ram.r 
       (.E(E),
        .ENA_I(ENA_I),
        .ENB_I(ENB_I),
        .din({din[232:224],din[200:192],din[168:160],din[136:128],din[104:96],din[72:64],din[40:32],din[8:0]}),
        .dout(dout[8:0]),
        .\gc1.count_d2_reg[7] (\gc1.count_d2_reg[7] ),
        .\gic0.gc1.count_d3_reg[4] (\gic0.gc1.count_d3_reg[4] ),
        .ram_rstram_b(ram_rstram_b),
        .rd_clk(rd_clk),
        .wr_clk(wr_clk));
  fifo_generator_0_blk_mem_gen_prim_width__parameterized0 \ramloop[1].ram.r 
       (.E(E),
        .ENA_I(ENA_I),
        .ENB_I(ENB_I),
        .din({din[241:233],din[209:201],din[177:169],din[145:137],din[113:105],din[81:73],din[49:41],din[17:9]}),
        .dout(dout[17:9]),
        .\gc1.count_d2_reg[7] (\gc1.count_d2_reg[7] ),
        .\gic0.gc1.count_d3_reg[4] (\gic0.gc1.count_d3_reg[4] ),
        .ram_rstram_b(ram_rstram_b),
        .rd_clk(rd_clk),
        .wr_clk(wr_clk));
  fifo_generator_0_blk_mem_gen_prim_width__parameterized1 \ramloop[2].ram.r 
       (.E(E),
        .ENA_I(ENA_I),
        .ENB_I(ENB_I),
        .din({din[250:242],din[218:210],din[186:178],din[154:146],din[122:114],din[90:82],din[58:50],din[26:18]}),
        .dout(dout[26:18]),
        .\gc1.count_d2_reg[7] (\gc1.count_d2_reg[7] ),
        .\gic0.gc1.count_d3_reg[4] (\gic0.gc1.count_d3_reg[4] ),
        .ram_rstram_b(ram_rstram_b),
        .rd_clk(rd_clk),
        .wr_clk(wr_clk));
  fifo_generator_0_blk_mem_gen_prim_width__parameterized2 \ramloop[3].ram.r 
       (.E(E),
        .ENA_I(ENA_I),
        .ENA_dly_D(ENA_dly_D),
        .ENB_I(ENB_I),
        .POR_B(POR_B),
        .SS(SS),
        .din({din[255:251],din[223:219],din[191:187],din[159:155],din[127:123],din[95:91],din[63:59],din[31:27]}),
        .dout(dout[31:27]),
        .\gc1.count_d2_reg[7] (\gc1.count_d2_reg[7] ),
        .\gic0.gc1.count_d3_reg[4] (\gic0.gc1.count_d3_reg[4] ),
        .out(out),
        .ram_rstram_b(ram_rstram_b),
        .rd_clk(rd_clk),
        .rd_en(rd_en),
        .wr_clk(wr_clk));
endmodule

(* ORIG_REF_NAME = "blk_mem_gen_prim_width" *) 
module fifo_generator_0_blk_mem_gen_prim_width
   (dout,
    rd_clk,
    wr_clk,
    ENB_I,
    ENA_I,
    ram_rstram_b,
    \gc1.count_d2_reg[7] ,
    \gic0.gc1.count_d3_reg[4] ,
    din,
    E);
  output [8:0]dout;
  input rd_clk;
  input wr_clk;
  input ENB_I;
  input ENA_I;
  input ram_rstram_b;
  input [7:0]\gc1.count_d2_reg[7] ;
  input [4:0]\gic0.gc1.count_d3_reg[4] ;
  input [71:0]din;
  input [0:0]E;

  wire [0:0]E;
  wire ENA_I;
  wire ENB_I;
  wire [71:0]din;
  wire [8:0]dout;
  wire [7:0]\gc1.count_d2_reg[7] ;
  wire [4:0]\gic0.gc1.count_d3_reg[4] ;
  wire ram_rstram_b;
  wire rd_clk;
  wire wr_clk;

  fifo_generator_0_blk_mem_gen_prim_wrapper \prim_noinit.ram 
       (.E(E),
        .ENA_I(ENA_I),
        .ENB_I(ENB_I),
        .din(din),
        .dout(dout),
        .\gc1.count_d2_reg[7] (\gc1.count_d2_reg[7] ),
        .\gic0.gc1.count_d3_reg[4] (\gic0.gc1.count_d3_reg[4] ),
        .ram_rstram_b(ram_rstram_b),
        .rd_clk(rd_clk),
        .wr_clk(wr_clk));
endmodule

(* ORIG_REF_NAME = "blk_mem_gen_prim_width" *) 
module fifo_generator_0_blk_mem_gen_prim_width__parameterized0
   (dout,
    rd_clk,
    wr_clk,
    ENB_I,
    ENA_I,
    ram_rstram_b,
    \gc1.count_d2_reg[7] ,
    \gic0.gc1.count_d3_reg[4] ,
    din,
    E);
  output [8:0]dout;
  input rd_clk;
  input wr_clk;
  input ENB_I;
  input ENA_I;
  input ram_rstram_b;
  input [7:0]\gc1.count_d2_reg[7] ;
  input [4:0]\gic0.gc1.count_d3_reg[4] ;
  input [71:0]din;
  input [0:0]E;

  wire [0:0]E;
  wire ENA_I;
  wire ENB_I;
  wire [71:0]din;
  wire [8:0]dout;
  wire [7:0]\gc1.count_d2_reg[7] ;
  wire [4:0]\gic0.gc1.count_d3_reg[4] ;
  wire ram_rstram_b;
  wire rd_clk;
  wire wr_clk;

  fifo_generator_0_blk_mem_gen_prim_wrapper__parameterized0 \prim_noinit.ram 
       (.E(E),
        .ENA_I(ENA_I),
        .ENB_I(ENB_I),
        .din(din),
        .dout(dout),
        .\gc1.count_d2_reg[7] (\gc1.count_d2_reg[7] ),
        .\gic0.gc1.count_d3_reg[4] (\gic0.gc1.count_d3_reg[4] ),
        .ram_rstram_b(ram_rstram_b),
        .rd_clk(rd_clk),
        .wr_clk(wr_clk));
endmodule

(* ORIG_REF_NAME = "blk_mem_gen_prim_width" *) 
module fifo_generator_0_blk_mem_gen_prim_width__parameterized1
   (dout,
    rd_clk,
    wr_clk,
    ENB_I,
    ENA_I,
    ram_rstram_b,
    \gc1.count_d2_reg[7] ,
    \gic0.gc1.count_d3_reg[4] ,
    din,
    E);
  output [8:0]dout;
  input rd_clk;
  input wr_clk;
  input ENB_I;
  input ENA_I;
  input ram_rstram_b;
  input [7:0]\gc1.count_d2_reg[7] ;
  input [4:0]\gic0.gc1.count_d3_reg[4] ;
  input [71:0]din;
  input [0:0]E;

  wire [0:0]E;
  wire ENA_I;
  wire ENB_I;
  wire [71:0]din;
  wire [8:0]dout;
  wire [7:0]\gc1.count_d2_reg[7] ;
  wire [4:0]\gic0.gc1.count_d3_reg[4] ;
  wire ram_rstram_b;
  wire rd_clk;
  wire wr_clk;

  fifo_generator_0_blk_mem_gen_prim_wrapper__parameterized1 \prim_noinit.ram 
       (.E(E),
        .ENA_I(ENA_I),
        .ENB_I(ENB_I),
        .din(din),
        .dout(dout),
        .\gc1.count_d2_reg[7] (\gc1.count_d2_reg[7] ),
        .\gic0.gc1.count_d3_reg[4] (\gic0.gc1.count_d3_reg[4] ),
        .ram_rstram_b(ram_rstram_b),
        .rd_clk(rd_clk),
        .wr_clk(wr_clk));
endmodule

(* ORIG_REF_NAME = "blk_mem_gen_prim_width" *) 
module fifo_generator_0_blk_mem_gen_prim_width__parameterized2
   (ENA_dly_D,
    dout,
    ENB_I,
    POR_B,
    wr_clk,
    rd_clk,
    ENA_I,
    ram_rstram_b,
    \gc1.count_d2_reg[7] ,
    \gic0.gc1.count_d3_reg[4] ,
    din,
    E,
    SS,
    rd_en,
    out);
  output ENA_dly_D;
  output [4:0]dout;
  output ENB_I;
  output POR_B;
  input wr_clk;
  input rd_clk;
  input ENA_I;
  input ram_rstram_b;
  input [7:0]\gc1.count_d2_reg[7] ;
  input [4:0]\gic0.gc1.count_d3_reg[4] ;
  input [39:0]din;
  input [0:0]E;
  input [0:0]SS;
  input rd_en;
  input out;

  wire [0:0]E;
  wire ENA_I;
  wire ENA_dly_D;
  wire ENB_I;
  wire ENB_dly;
  wire ENB_dly_D;
  wire POR_B;
  wire \SAFETY_CKT_GEN.ENA_NO_REG.ENA_dly_reg_srl2_i_1_n_0 ;
  wire \SAFETY_CKT_GEN.ENA_NO_REG.ENA_dly_reg_srl2_n_0 ;
  wire \SAFETY_CKT_GEN.POR_B_i_1_n_0 ;
  wire \SAFETY_CKT_GEN.RSTA_SHFT_REG_reg[3]_srl3_n_0 ;
  wire \SAFETY_CKT_GEN.RSTA_SHFT_REG_reg_n_0_[0] ;
  wire \SAFETY_CKT_GEN.RSTA_SHFT_REG_reg_n_0_[4] ;
  wire \SAFETY_CKT_GEN.RSTB_SHFT_REG_reg[3]_srl3_n_0 ;
  wire \SAFETY_CKT_GEN.RSTB_SHFT_REG_reg_n_0_[0] ;
  wire \SAFETY_CKT_GEN.RSTB_SHFT_REG_reg_n_0_[4] ;
  wire [0:0]SS;
  wire [39:0]din;
  wire [4:0]dout;
  wire [7:0]\gc1.count_d2_reg[7] ;
  wire [4:0]\gic0.gc1.count_d3_reg[4] ;
  wire out;
  wire ram_rstram_b;
  wire rd_clk;
  wire rd_en;
  wire wr_clk;

  FDRE #(
    .INIT(1'b0)) 
    \SAFETY_CKT_GEN.ENA_NO_REG.ENA_dly_D_reg 
       (.C(wr_clk),
        .CE(1'b1),
        .D(\SAFETY_CKT_GEN.ENA_NO_REG.ENA_dly_reg_srl2_n_0 ),
        .Q(ENA_dly_D),
        .R(1'b0));
  (* srl_bus_name = "U0/\inst_fifo_gen/gconvfifo.rf/grf.rf/gntv_or_sync_fifo.mem/gbm.gbmg.gbmga.ngecc.bmg/inst_blk_mem_gen/gnbram.gnativebmg.native_blk_mem_gen/valid.cstr/ramloop " *) 
  (* srl_name = "U0/\inst_fifo_gen/gconvfifo.rf/grf.rf/gntv_or_sync_fifo.mem/gbm.gbmg.gbmga.ngecc.bmg/inst_blk_mem_gen/gnbram.gnativebmg.native_blk_mem_gen/valid.cstr/ramloop[3].ram.r/SAFETY_CKT_GEN.ENA_NO_REG.ENA_dly_reg_srl2 " *) 
  SRL16E #(
    .INIT(16'h0000)) 
    \SAFETY_CKT_GEN.ENA_NO_REG.ENA_dly_reg_srl2 
       (.A0(1'b1),
        .A1(1'b0),
        .A2(1'b0),
        .A3(1'b0),
        .CE(1'b1),
        .CLK(wr_clk),
        .D(\SAFETY_CKT_GEN.ENA_NO_REG.ENA_dly_reg_srl2_i_1_n_0 ),
        .Q(\SAFETY_CKT_GEN.ENA_NO_REG.ENA_dly_reg_srl2_n_0 ));
  LUT2 #(
    .INIT(4'h6)) 
    \SAFETY_CKT_GEN.ENA_NO_REG.ENA_dly_reg_srl2_i_1 
       (.I0(\SAFETY_CKT_GEN.RSTA_SHFT_REG_reg_n_0_[4] ),
        .I1(\SAFETY_CKT_GEN.RSTA_SHFT_REG_reg_n_0_[0] ),
        .O(\SAFETY_CKT_GEN.ENA_NO_REG.ENA_dly_reg_srl2_i_1_n_0 ));
  FDRE #(
    .INIT(1'b0)) 
    \SAFETY_CKT_GEN.ENB_NO_REG.ENB_dly_D_reg 
       (.C(rd_clk),
        .CE(1'b1),
        .D(ENB_dly),
        .Q(ENB_dly_D),
        .R(1'b0));
  FDSE #(
    .INIT(1'b0)) 
    \SAFETY_CKT_GEN.ENB_NO_REG.ENB_dly_reg 
       (.C(rd_clk),
        .CE(1'b1),
        .D(POR_B),
        .Q(ENB_dly),
        .S(SS));
  LUT2 #(
    .INIT(4'h6)) 
    \SAFETY_CKT_GEN.POR_B_i_1 
       (.I0(\SAFETY_CKT_GEN.RSTB_SHFT_REG_reg_n_0_[4] ),
        .I1(\SAFETY_CKT_GEN.RSTB_SHFT_REG_reg_n_0_[0] ),
        .O(\SAFETY_CKT_GEN.POR_B_i_1_n_0 ));
  FDRE #(
    .INIT(1'b0)) 
    \SAFETY_CKT_GEN.POR_B_reg 
       (.C(rd_clk),
        .CE(1'b1),
        .D(\SAFETY_CKT_GEN.POR_B_i_1_n_0 ),
        .Q(POR_B),
        .R(1'b0));
  FDRE #(
    .INIT(1'b0)) 
    \SAFETY_CKT_GEN.RSTA_SHFT_REG_reg[0] 
       (.C(wr_clk),
        .CE(1'b1),
        .D(1'b1),
        .Q(\SAFETY_CKT_GEN.RSTA_SHFT_REG_reg_n_0_[0] ),
        .R(1'b0));
  (* srl_bus_name = "U0/\inst_fifo_gen/gconvfifo.rf/grf.rf/gntv_or_sync_fifo.mem/gbm.gbmg.gbmga.ngecc.bmg/inst_blk_mem_gen/gnbram.gnativebmg.native_blk_mem_gen/valid.cstr/ramloop[3].ram.r/SAFETY_CKT_GEN.RSTA_SHFT_REG_reg " *) 
  (* srl_name = "U0/\inst_fifo_gen/gconvfifo.rf/grf.rf/gntv_or_sync_fifo.mem/gbm.gbmg.gbmga.ngecc.bmg/inst_blk_mem_gen/gnbram.gnativebmg.native_blk_mem_gen/valid.cstr/ramloop[3].ram.r/SAFETY_CKT_GEN.RSTA_SHFT_REG_reg[3]_srl3 " *) 
  SRL16E #(
    .INIT(16'h0000)) 
    \SAFETY_CKT_GEN.RSTA_SHFT_REG_reg[3]_srl3 
       (.A0(1'b0),
        .A1(1'b1),
        .A2(1'b0),
        .A3(1'b0),
        .CE(1'b1),
        .CLK(wr_clk),
        .D(\SAFETY_CKT_GEN.RSTA_SHFT_REG_reg_n_0_[0] ),
        .Q(\SAFETY_CKT_GEN.RSTA_SHFT_REG_reg[3]_srl3_n_0 ));
  FDRE #(
    .INIT(1'b0)) 
    \SAFETY_CKT_GEN.RSTA_SHFT_REG_reg[4] 
       (.C(wr_clk),
        .CE(1'b1),
        .D(\SAFETY_CKT_GEN.RSTA_SHFT_REG_reg[3]_srl3_n_0 ),
        .Q(\SAFETY_CKT_GEN.RSTA_SHFT_REG_reg_n_0_[4] ),
        .R(1'b0));
  FDRE #(
    .INIT(1'b0)) 
    \SAFETY_CKT_GEN.RSTB_SHFT_REG_reg[0] 
       (.C(rd_clk),
        .CE(1'b1),
        .D(1'b1),
        .Q(\SAFETY_CKT_GEN.RSTB_SHFT_REG_reg_n_0_[0] ),
        .R(1'b0));
  (* srl_bus_name = "U0/\inst_fifo_gen/gconvfifo.rf/grf.rf/gntv_or_sync_fifo.mem/gbm.gbmg.gbmga.ngecc.bmg/inst_blk_mem_gen/gnbram.gnativebmg.native_blk_mem_gen/valid.cstr/ramloop[3].ram.r/SAFETY_CKT_GEN.RSTB_SHFT_REG_reg " *) 
  (* srl_name = "U0/\inst_fifo_gen/gconvfifo.rf/grf.rf/gntv_or_sync_fifo.mem/gbm.gbmg.gbmga.ngecc.bmg/inst_blk_mem_gen/gnbram.gnativebmg.native_blk_mem_gen/valid.cstr/ramloop[3].ram.r/SAFETY_CKT_GEN.RSTB_SHFT_REG_reg[3]_srl3 " *) 
  SRL16E #(
    .INIT(16'h0000)) 
    \SAFETY_CKT_GEN.RSTB_SHFT_REG_reg[3]_srl3 
       (.A0(1'b0),
        .A1(1'b1),
        .A2(1'b0),
        .A3(1'b0),
        .CE(1'b1),
        .CLK(rd_clk),
        .D(\SAFETY_CKT_GEN.RSTB_SHFT_REG_reg_n_0_[0] ),
        .Q(\SAFETY_CKT_GEN.RSTB_SHFT_REG_reg[3]_srl3_n_0 ));
  FDRE #(
    .INIT(1'b0)) 
    \SAFETY_CKT_GEN.RSTB_SHFT_REG_reg[4] 
       (.C(rd_clk),
        .CE(1'b1),
        .D(\SAFETY_CKT_GEN.RSTB_SHFT_REG_reg[3]_srl3_n_0 ),
        .Q(\SAFETY_CKT_GEN.RSTB_SHFT_REG_reg_n_0_[4] ),
        .R(1'b0));
  fifo_generator_0_blk_mem_gen_prim_wrapper__parameterized2 \prim_noinit.ram 
       (.E(E),
        .ENA_I(ENA_I),
        .ENB_I(ENB_I),
        .ENB_dly_D(ENB_dly_D),
        .SS(SS),
        .din(din),
        .dout(dout),
        .\gc1.count_d2_reg[7] (\gc1.count_d2_reg[7] ),
        .\gic0.gc1.count_d3_reg[4] (\gic0.gc1.count_d3_reg[4] ),
        .out(out),
        .ram_rstram_b(ram_rstram_b),
        .rd_clk(rd_clk),
        .rd_en(rd_en),
        .wr_clk(wr_clk));
endmodule

(* ORIG_REF_NAME = "blk_mem_gen_prim_wrapper" *) 
module fifo_generator_0_blk_mem_gen_prim_wrapper
   (dout,
    rd_clk,
    wr_clk,
    ENB_I,
    ENA_I,
    ram_rstram_b,
    \gc1.count_d2_reg[7] ,
    \gic0.gc1.count_d3_reg[4] ,
    din,
    E);
  output [8:0]dout;
  input rd_clk;
  input wr_clk;
  input ENB_I;
  input ENA_I;
  input ram_rstram_b;
  input [7:0]\gc1.count_d2_reg[7] ;
  input [4:0]\gic0.gc1.count_d3_reg[4] ;
  input [71:0]din;
  input [0:0]E;

  wire [0:0]E;
  wire ENA_I;
  wire ENB_I;
  wire [71:0]din;
  wire [8:0]dout;
  wire [7:0]\gc1.count_d2_reg[7] ;
  wire [4:0]\gic0.gc1.count_d3_reg[4] ;
  wire ram_rstram_b;
  wire rd_clk;
  wire wr_clk;
  wire \NLW_DEVICE_7SERIES.NO_BMM_INFO.SDP.WIDE_PRIM36_NO_ECC.ram_CASCADEOUTA_UNCONNECTED ;
  wire \NLW_DEVICE_7SERIES.NO_BMM_INFO.SDP.WIDE_PRIM36_NO_ECC.ram_CASCADEOUTB_UNCONNECTED ;
  wire \NLW_DEVICE_7SERIES.NO_BMM_INFO.SDP.WIDE_PRIM36_NO_ECC.ram_DBITERR_UNCONNECTED ;
  wire \NLW_DEVICE_7SERIES.NO_BMM_INFO.SDP.WIDE_PRIM36_NO_ECC.ram_SBITERR_UNCONNECTED ;
  wire [31:8]\NLW_DEVICE_7SERIES.NO_BMM_INFO.SDP.WIDE_PRIM36_NO_ECC.ram_DOADO_UNCONNECTED ;
  wire [31:0]\NLW_DEVICE_7SERIES.NO_BMM_INFO.SDP.WIDE_PRIM36_NO_ECC.ram_DOBDO_UNCONNECTED ;
  wire [3:1]\NLW_DEVICE_7SERIES.NO_BMM_INFO.SDP.WIDE_PRIM36_NO_ECC.ram_DOPADOP_UNCONNECTED ;
  wire [3:0]\NLW_DEVICE_7SERIES.NO_BMM_INFO.SDP.WIDE_PRIM36_NO_ECC.ram_DOPBDOP_UNCONNECTED ;
  wire [7:0]\NLW_DEVICE_7SERIES.NO_BMM_INFO.SDP.WIDE_PRIM36_NO_ECC.ram_ECCPARITY_UNCONNECTED ;
  wire [8:0]\NLW_DEVICE_7SERIES.NO_BMM_INFO.SDP.WIDE_PRIM36_NO_ECC.ram_RDADDRECC_UNCONNECTED ;

  (* box_type = "PRIMITIVE" *) 
  RAMB36E1 #(
    .DOA_REG(0),
    .DOB_REG(0),
    .EN_ECC_READ("FALSE"),
    .EN_ECC_WRITE("FALSE"),
    .INITP_00(256'h0000000000000000000000000000000000000000000000000000000000000000),
    .INITP_01(256'h0000000000000000000000000000000000000000000000000000000000000000),
    .INITP_02(256'h0000000000000000000000000000000000000000000000000000000000000000),
    .INITP_03(256'h0000000000000000000000000000000000000000000000000000000000000000),
    .INITP_04(256'h0000000000000000000000000000000000000000000000000000000000000000),
    .INITP_05(256'h0000000000000000000000000000000000000000000000000000000000000000),
    .INITP_06(256'h0000000000000000000000000000000000000000000000000000000000000000),
    .INITP_07(256'h0000000000000000000000000000000000000000000000000000000000000000),
    .INITP_08(256'h0000000000000000000000000000000000000000000000000000000000000000),
    .INITP_09(256'h0000000000000000000000000000000000000000000000000000000000000000),
    .INITP_0A(256'h0000000000000000000000000000000000000000000000000000000000000000),
    .INITP_0B(256'h0000000000000000000000000000000000000000000000000000000000000000),
    .INITP_0C(256'h0000000000000000000000000000000000000000000000000000000000000000),
    .INITP_0D(256'h0000000000000000000000000000000000000000000000000000000000000000),
    .INITP_0E(256'h0000000000000000000000000000000000000000000000000000000000000000),
    .INITP_0F(256'h0000000000000000000000000000000000000000000000000000000000000000),
    .INIT_00(256'h0000000000000000000000000000000000000000000000000000000000000000),
    .INIT_01(256'h0000000000000000000000000000000000000000000000000000000000000000),
    .INIT_02(256'h0000000000000000000000000000000000000000000000000000000000000000),
    .INIT_03(256'h0000000000000000000000000000000000000000000000000000000000000000),
    .INIT_04(256'h0000000000000000000000000000000000000000000000000000000000000000),
    .INIT_05(256'h0000000000000000000000000000000000000000000000000000000000000000),
    .INIT_06(256'h0000000000000000000000000000000000000000000000000000000000000000),
    .INIT_07(256'h0000000000000000000000000000000000000000000000000000000000000000),
    .INIT_08(256'h0000000000000000000000000000000000000000000000000000000000000000),
    .INIT_09(256'h0000000000000000000000000000000000000000000000000000000000000000),
    .INIT_0A(256'h0000000000000000000000000000000000000000000000000000000000000000),
    .INIT_0B(256'h0000000000000000000000000000000000000000000000000000000000000000),
    .INIT_0C(256'h0000000000000000000000000000000000000000000000000000000000000000),
    .INIT_0D(256'h0000000000000000000000000000000000000000000000000000000000000000),
    .INIT_0E(256'h0000000000000000000000000000000000000000000000000000000000000000),
    .INIT_0F(256'h0000000000000000000000000000000000000000000000000000000000000000),
    .INIT_10(256'h0000000000000000000000000000000000000000000000000000000000000000),
    .INIT_11(256'h0000000000000000000000000000000000000000000000000000000000000000),
    .INIT_12(256'h0000000000000000000000000000000000000000000000000000000000000000),
    .INIT_13(256'h0000000000000000000000000000000000000000000000000000000000000000),
    .INIT_14(256'h0000000000000000000000000000000000000000000000000000000000000000),
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
    .INIT_6A(256'h0000000000000000000000000000000000000000000000000000000000000000),
    .INIT_6B(256'h0000000000000000000000000000000000000000000000000000000000000000),
    .INIT_6C(256'h0000000000000000000000000000000000000000000000000000000000000000),
    .INIT_6D(256'h0000000000000000000000000000000000000000000000000000000000000000),
    .INIT_6E(256'h0000000000000000000000000000000000000000000000000000000000000000),
    .INIT_6F(256'h0000000000000000000000000000000000000000000000000000000000000000),
    .INIT_70(256'h0000000000000000000000000000000000000000000000000000000000000000),
    .INIT_71(256'h0000000000000000000000000000000000000000000000000000000000000000),
    .INIT_72(256'h0000000000000000000000000000000000000000000000000000000000000000),
    .INIT_73(256'h0000000000000000000000000000000000000000000000000000000000000000),
    .INIT_74(256'h0000000000000000000000000000000000000000000000000000000000000000),
    .INIT_75(256'h0000000000000000000000000000000000000000000000000000000000000000),
    .INIT_76(256'h0000000000000000000000000000000000000000000000000000000000000000),
    .INIT_77(256'h0000000000000000000000000000000000000000000000000000000000000000),
    .INIT_78(256'h0000000000000000000000000000000000000000000000000000000000000000),
    .INIT_79(256'h0000000000000000000000000000000000000000000000000000000000000000),
    .INIT_7A(256'h0000000000000000000000000000000000000000000000000000000000000000),
    .INIT_7B(256'h0000000000000000000000000000000000000000000000000000000000000000),
    .INIT_7C(256'h0000000000000000000000000000000000000000000000000000000000000000),
    .INIT_7D(256'h0000000000000000000000000000000000000000000000000000000000000000),
    .INIT_7E(256'h0000000000000000000000000000000000000000000000000000000000000000),
    .INIT_7F(256'h0000000000000000000000000000000000000000000000000000000000000000),
    .INIT_A(36'h000000000),
    .INIT_B(36'h000000000),
    .INIT_FILE("NONE"),
    .IS_CLKARDCLK_INVERTED(1'b0),
    .IS_CLKBWRCLK_INVERTED(1'b0),
    .IS_ENARDEN_INVERTED(1'b0),
    .IS_ENBWREN_INVERTED(1'b0),
    .IS_RSTRAMARSTRAM_INVERTED(1'b0),
    .IS_RSTRAMB_INVERTED(1'b0),
    .IS_RSTREGARSTREG_INVERTED(1'b0),
    .IS_RSTREGB_INVERTED(1'b0),
    .RAM_EXTENSION_A("NONE"),
    .RAM_EXTENSION_B("NONE"),
    .RAM_MODE("SDP"),
    .RDADDR_COLLISION_HWCONFIG("DELAYED_WRITE"),
    .READ_WIDTH_A(9),
    .READ_WIDTH_B(0),
    .RSTREG_PRIORITY_A("REGCE"),
    .RSTREG_PRIORITY_B("REGCE"),
    .SIM_COLLISION_CHECK("ALL"),
    .SIM_DEVICE("7SERIES"),
    .SRVAL_A(36'h000000000),
    .SRVAL_B(36'h000000000),
    .WRITE_MODE_A("WRITE_FIRST"),
    .WRITE_MODE_B("WRITE_FIRST"),
    .WRITE_WIDTH_A(0),
    .WRITE_WIDTH_B(72)) 
    \DEVICE_7SERIES.NO_BMM_INFO.SDP.WIDE_PRIM36_NO_ECC.ram 
       (.ADDRARDADDR({1'b1,1'b0,1'b0,1'b0,1'b0,\gc1.count_d2_reg[7] ,1'b1,1'b1,1'b1}),
        .ADDRBWRADDR({1'b1,1'b0,1'b0,1'b0,1'b0,\gic0.gc1.count_d3_reg[4] ,1'b1,1'b1,1'b1,1'b1,1'b1,1'b1}),
        .CASCADEINA(1'b0),
        .CASCADEINB(1'b0),
        .CASCADEOUTA(\NLW_DEVICE_7SERIES.NO_BMM_INFO.SDP.WIDE_PRIM36_NO_ECC.ram_CASCADEOUTA_UNCONNECTED ),
        .CASCADEOUTB(\NLW_DEVICE_7SERIES.NO_BMM_INFO.SDP.WIDE_PRIM36_NO_ECC.ram_CASCADEOUTB_UNCONNECTED ),
        .CLKARDCLK(rd_clk),
        .CLKBWRCLK(wr_clk),
        .DBITERR(\NLW_DEVICE_7SERIES.NO_BMM_INFO.SDP.WIDE_PRIM36_NO_ECC.ram_DBITERR_UNCONNECTED ),
        .DIADI({din[43:36],din[52:45],din[61:54],din[70:63]}),
        .DIBDI({din[7:0],din[16:9],din[25:18],din[34:27]}),
        .DIPADIP({din[44],din[53],din[62],din[71]}),
        .DIPBDIP({din[8],din[17],din[26],din[35]}),
        .DOADO({\NLW_DEVICE_7SERIES.NO_BMM_INFO.SDP.WIDE_PRIM36_NO_ECC.ram_DOADO_UNCONNECTED [31:8],dout[7:0]}),
        .DOBDO(\NLW_DEVICE_7SERIES.NO_BMM_INFO.SDP.WIDE_PRIM36_NO_ECC.ram_DOBDO_UNCONNECTED [31:0]),
        .DOPADOP({\NLW_DEVICE_7SERIES.NO_BMM_INFO.SDP.WIDE_PRIM36_NO_ECC.ram_DOPADOP_UNCONNECTED [3:1],dout[8]}),
        .DOPBDOP(\NLW_DEVICE_7SERIES.NO_BMM_INFO.SDP.WIDE_PRIM36_NO_ECC.ram_DOPBDOP_UNCONNECTED [3:0]),
        .ECCPARITY(\NLW_DEVICE_7SERIES.NO_BMM_INFO.SDP.WIDE_PRIM36_NO_ECC.ram_ECCPARITY_UNCONNECTED [7:0]),
        .ENARDEN(ENB_I),
        .ENBWREN(ENA_I),
        .INJECTDBITERR(1'b0),
        .INJECTSBITERR(1'b0),
        .RDADDRECC(\NLW_DEVICE_7SERIES.NO_BMM_INFO.SDP.WIDE_PRIM36_NO_ECC.ram_RDADDRECC_UNCONNECTED [8:0]),
        .REGCEAREGCE(1'b0),
        .REGCEB(1'b0),
        .RSTRAMARSTRAM(ram_rstram_b),
        .RSTRAMB(1'b0),
        .RSTREGARSTREG(1'b0),
        .RSTREGB(1'b0),
        .SBITERR(\NLW_DEVICE_7SERIES.NO_BMM_INFO.SDP.WIDE_PRIM36_NO_ECC.ram_SBITERR_UNCONNECTED ),
        .WEA({1'b0,1'b0,1'b0,1'b0}),
        .WEBWE({E,E,E,E,E,E,E,E}));
endmodule

(* ORIG_REF_NAME = "blk_mem_gen_prim_wrapper" *) 
module fifo_generator_0_blk_mem_gen_prim_wrapper__parameterized0
   (dout,
    rd_clk,
    wr_clk,
    ENB_I,
    ENA_I,
    ram_rstram_b,
    \gc1.count_d2_reg[7] ,
    \gic0.gc1.count_d3_reg[4] ,
    din,
    E);
  output [8:0]dout;
  input rd_clk;
  input wr_clk;
  input ENB_I;
  input ENA_I;
  input ram_rstram_b;
  input [7:0]\gc1.count_d2_reg[7] ;
  input [4:0]\gic0.gc1.count_d3_reg[4] ;
  input [71:0]din;
  input [0:0]E;

  wire [0:0]E;
  wire ENA_I;
  wire ENB_I;
  wire [71:0]din;
  wire [8:0]dout;
  wire [7:0]\gc1.count_d2_reg[7] ;
  wire [4:0]\gic0.gc1.count_d3_reg[4] ;
  wire ram_rstram_b;
  wire rd_clk;
  wire wr_clk;
  wire \NLW_DEVICE_7SERIES.NO_BMM_INFO.SDP.WIDE_PRIM36_NO_ECC.ram_CASCADEOUTA_UNCONNECTED ;
  wire \NLW_DEVICE_7SERIES.NO_BMM_INFO.SDP.WIDE_PRIM36_NO_ECC.ram_CASCADEOUTB_UNCONNECTED ;
  wire \NLW_DEVICE_7SERIES.NO_BMM_INFO.SDP.WIDE_PRIM36_NO_ECC.ram_DBITERR_UNCONNECTED ;
  wire \NLW_DEVICE_7SERIES.NO_BMM_INFO.SDP.WIDE_PRIM36_NO_ECC.ram_SBITERR_UNCONNECTED ;
  wire [31:8]\NLW_DEVICE_7SERIES.NO_BMM_INFO.SDP.WIDE_PRIM36_NO_ECC.ram_DOADO_UNCONNECTED ;
  wire [31:0]\NLW_DEVICE_7SERIES.NO_BMM_INFO.SDP.WIDE_PRIM36_NO_ECC.ram_DOBDO_UNCONNECTED ;
  wire [3:1]\NLW_DEVICE_7SERIES.NO_BMM_INFO.SDP.WIDE_PRIM36_NO_ECC.ram_DOPADOP_UNCONNECTED ;
  wire [3:0]\NLW_DEVICE_7SERIES.NO_BMM_INFO.SDP.WIDE_PRIM36_NO_ECC.ram_DOPBDOP_UNCONNECTED ;
  wire [7:0]\NLW_DEVICE_7SERIES.NO_BMM_INFO.SDP.WIDE_PRIM36_NO_ECC.ram_ECCPARITY_UNCONNECTED ;
  wire [8:0]\NLW_DEVICE_7SERIES.NO_BMM_INFO.SDP.WIDE_PRIM36_NO_ECC.ram_RDADDRECC_UNCONNECTED ;

  (* box_type = "PRIMITIVE" *) 
  RAMB36E1 #(
    .DOA_REG(0),
    .DOB_REG(0),
    .EN_ECC_READ("FALSE"),
    .EN_ECC_WRITE("FALSE"),
    .INITP_00(256'h0000000000000000000000000000000000000000000000000000000000000000),
    .INITP_01(256'h0000000000000000000000000000000000000000000000000000000000000000),
    .INITP_02(256'h0000000000000000000000000000000000000000000000000000000000000000),
    .INITP_03(256'h0000000000000000000000000000000000000000000000000000000000000000),
    .INITP_04(256'h0000000000000000000000000000000000000000000000000000000000000000),
    .INITP_05(256'h0000000000000000000000000000000000000000000000000000000000000000),
    .INITP_06(256'h0000000000000000000000000000000000000000000000000000000000000000),
    .INITP_07(256'h0000000000000000000000000000000000000000000000000000000000000000),
    .INITP_08(256'h0000000000000000000000000000000000000000000000000000000000000000),
    .INITP_09(256'h0000000000000000000000000000000000000000000000000000000000000000),
    .INITP_0A(256'h0000000000000000000000000000000000000000000000000000000000000000),
    .INITP_0B(256'h0000000000000000000000000000000000000000000000000000000000000000),
    .INITP_0C(256'h0000000000000000000000000000000000000000000000000000000000000000),
    .INITP_0D(256'h0000000000000000000000000000000000000000000000000000000000000000),
    .INITP_0E(256'h0000000000000000000000000000000000000000000000000000000000000000),
    .INITP_0F(256'h0000000000000000000000000000000000000000000000000000000000000000),
    .INIT_00(256'h0000000000000000000000000000000000000000000000000000000000000000),
    .INIT_01(256'h0000000000000000000000000000000000000000000000000000000000000000),
    .INIT_02(256'h0000000000000000000000000000000000000000000000000000000000000000),
    .INIT_03(256'h0000000000000000000000000000000000000000000000000000000000000000),
    .INIT_04(256'h0000000000000000000000000000000000000000000000000000000000000000),
    .INIT_05(256'h0000000000000000000000000000000000000000000000000000000000000000),
    .INIT_06(256'h0000000000000000000000000000000000000000000000000000000000000000),
    .INIT_07(256'h0000000000000000000000000000000000000000000000000000000000000000),
    .INIT_08(256'h0000000000000000000000000000000000000000000000000000000000000000),
    .INIT_09(256'h0000000000000000000000000000000000000000000000000000000000000000),
    .INIT_0A(256'h0000000000000000000000000000000000000000000000000000000000000000),
    .INIT_0B(256'h0000000000000000000000000000000000000000000000000000000000000000),
    .INIT_0C(256'h0000000000000000000000000000000000000000000000000000000000000000),
    .INIT_0D(256'h0000000000000000000000000000000000000000000000000000000000000000),
    .INIT_0E(256'h0000000000000000000000000000000000000000000000000000000000000000),
    .INIT_0F(256'h0000000000000000000000000000000000000000000000000000000000000000),
    .INIT_10(256'h0000000000000000000000000000000000000000000000000000000000000000),
    .INIT_11(256'h0000000000000000000000000000000000000000000000000000000000000000),
    .INIT_12(256'h0000000000000000000000000000000000000000000000000000000000000000),
    .INIT_13(256'h0000000000000000000000000000000000000000000000000000000000000000),
    .INIT_14(256'h0000000000000000000000000000000000000000000000000000000000000000),
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
    .INIT_6A(256'h0000000000000000000000000000000000000000000000000000000000000000),
    .INIT_6B(256'h0000000000000000000000000000000000000000000000000000000000000000),
    .INIT_6C(256'h0000000000000000000000000000000000000000000000000000000000000000),
    .INIT_6D(256'h0000000000000000000000000000000000000000000000000000000000000000),
    .INIT_6E(256'h0000000000000000000000000000000000000000000000000000000000000000),
    .INIT_6F(256'h0000000000000000000000000000000000000000000000000000000000000000),
    .INIT_70(256'h0000000000000000000000000000000000000000000000000000000000000000),
    .INIT_71(256'h0000000000000000000000000000000000000000000000000000000000000000),
    .INIT_72(256'h0000000000000000000000000000000000000000000000000000000000000000),
    .INIT_73(256'h0000000000000000000000000000000000000000000000000000000000000000),
    .INIT_74(256'h0000000000000000000000000000000000000000000000000000000000000000),
    .INIT_75(256'h0000000000000000000000000000000000000000000000000000000000000000),
    .INIT_76(256'h0000000000000000000000000000000000000000000000000000000000000000),
    .INIT_77(256'h0000000000000000000000000000000000000000000000000000000000000000),
    .INIT_78(256'h0000000000000000000000000000000000000000000000000000000000000000),
    .INIT_79(256'h0000000000000000000000000000000000000000000000000000000000000000),
    .INIT_7A(256'h0000000000000000000000000000000000000000000000000000000000000000),
    .INIT_7B(256'h0000000000000000000000000000000000000000000000000000000000000000),
    .INIT_7C(256'h0000000000000000000000000000000000000000000000000000000000000000),
    .INIT_7D(256'h0000000000000000000000000000000000000000000000000000000000000000),
    .INIT_7E(256'h0000000000000000000000000000000000000000000000000000000000000000),
    .INIT_7F(256'h0000000000000000000000000000000000000000000000000000000000000000),
    .INIT_A(36'h000000000),
    .INIT_B(36'h000000000),
    .INIT_FILE("NONE"),
    .IS_CLKARDCLK_INVERTED(1'b0),
    .IS_CLKBWRCLK_INVERTED(1'b0),
    .IS_ENARDEN_INVERTED(1'b0),
    .IS_ENBWREN_INVERTED(1'b0),
    .IS_RSTRAMARSTRAM_INVERTED(1'b0),
    .IS_RSTRAMB_INVERTED(1'b0),
    .IS_RSTREGARSTREG_INVERTED(1'b0),
    .IS_RSTREGB_INVERTED(1'b0),
    .RAM_EXTENSION_A("NONE"),
    .RAM_EXTENSION_B("NONE"),
    .RAM_MODE("SDP"),
    .RDADDR_COLLISION_HWCONFIG("DELAYED_WRITE"),
    .READ_WIDTH_A(9),
    .READ_WIDTH_B(0),
    .RSTREG_PRIORITY_A("REGCE"),
    .RSTREG_PRIORITY_B("REGCE"),
    .SIM_COLLISION_CHECK("ALL"),
    .SIM_DEVICE("7SERIES"),
    .SRVAL_A(36'h000000000),
    .SRVAL_B(36'h000000000),
    .WRITE_MODE_A("WRITE_FIRST"),
    .WRITE_MODE_B("WRITE_FIRST"),
    .WRITE_WIDTH_A(0),
    .WRITE_WIDTH_B(72)) 
    \DEVICE_7SERIES.NO_BMM_INFO.SDP.WIDE_PRIM36_NO_ECC.ram 
       (.ADDRARDADDR({1'b1,1'b0,1'b0,1'b0,1'b0,\gc1.count_d2_reg[7] ,1'b1,1'b1,1'b1}),
        .ADDRBWRADDR({1'b1,1'b0,1'b0,1'b0,1'b0,\gic0.gc1.count_d3_reg[4] ,1'b1,1'b1,1'b1,1'b1,1'b1,1'b1}),
        .CASCADEINA(1'b0),
        .CASCADEINB(1'b0),
        .CASCADEOUTA(\NLW_DEVICE_7SERIES.NO_BMM_INFO.SDP.WIDE_PRIM36_NO_ECC.ram_CASCADEOUTA_UNCONNECTED ),
        .CASCADEOUTB(\NLW_DEVICE_7SERIES.NO_BMM_INFO.SDP.WIDE_PRIM36_NO_ECC.ram_CASCADEOUTB_UNCONNECTED ),
        .CLKARDCLK(rd_clk),
        .CLKBWRCLK(wr_clk),
        .DBITERR(\NLW_DEVICE_7SERIES.NO_BMM_INFO.SDP.WIDE_PRIM36_NO_ECC.ram_DBITERR_UNCONNECTED ),
        .DIADI({din[43:36],din[52:45],din[61:54],din[70:63]}),
        .DIBDI({din[7:0],din[16:9],din[25:18],din[34:27]}),
        .DIPADIP({din[44],din[53],din[62],din[71]}),
        .DIPBDIP({din[8],din[17],din[26],din[35]}),
        .DOADO({\NLW_DEVICE_7SERIES.NO_BMM_INFO.SDP.WIDE_PRIM36_NO_ECC.ram_DOADO_UNCONNECTED [31:8],dout[7:0]}),
        .DOBDO(\NLW_DEVICE_7SERIES.NO_BMM_INFO.SDP.WIDE_PRIM36_NO_ECC.ram_DOBDO_UNCONNECTED [31:0]),
        .DOPADOP({\NLW_DEVICE_7SERIES.NO_BMM_INFO.SDP.WIDE_PRIM36_NO_ECC.ram_DOPADOP_UNCONNECTED [3:1],dout[8]}),
        .DOPBDOP(\NLW_DEVICE_7SERIES.NO_BMM_INFO.SDP.WIDE_PRIM36_NO_ECC.ram_DOPBDOP_UNCONNECTED [3:0]),
        .ECCPARITY(\NLW_DEVICE_7SERIES.NO_BMM_INFO.SDP.WIDE_PRIM36_NO_ECC.ram_ECCPARITY_UNCONNECTED [7:0]),
        .ENARDEN(ENB_I),
        .ENBWREN(ENA_I),
        .INJECTDBITERR(1'b0),
        .INJECTSBITERR(1'b0),
        .RDADDRECC(\NLW_DEVICE_7SERIES.NO_BMM_INFO.SDP.WIDE_PRIM36_NO_ECC.ram_RDADDRECC_UNCONNECTED [8:0]),
        .REGCEAREGCE(1'b0),
        .REGCEB(1'b0),
        .RSTRAMARSTRAM(ram_rstram_b),
        .RSTRAMB(1'b0),
        .RSTREGARSTREG(1'b0),
        .RSTREGB(1'b0),
        .SBITERR(\NLW_DEVICE_7SERIES.NO_BMM_INFO.SDP.WIDE_PRIM36_NO_ECC.ram_SBITERR_UNCONNECTED ),
        .WEA({1'b0,1'b0,1'b0,1'b0}),
        .WEBWE({E,E,E,E,E,E,E,E}));
endmodule
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
