VicidominiLab/BrightEyes-TTM/(commit log)

2021-10-13 version v1 first commit
    [BOM_DIGIBUFF8_rev2.xlsx]
2022-06-13 v2.0 initial
    [BOM.csv, KicadOutputList.csv, PCB StackUp.ods]
